SynDaverCO/syndaver-axi/README.md

All files shared here are shared under the CC-BY SA 4.0 license, with attribution to Aleph Objects.
