SynDaverCO/syndaver-axi/Electrical/Cable_drawings/Control_box/[100024] Harness, CB Plug to Ground Green, Syn1 [REV A].pdf

DRAWN BY: SAW | DATE: 01/14/2020 | 3121 N Garfield Ave Loveland, CO. 80538 Phone: 1-970-685-4501
CHECKED BY: CHECKED | DATE: XX/XX/XXXX
UNLESS OTHERWISE SPECIFIED DIMENSIONS ARE IN MILLIMETERS. TOLERANCES ARE: CUT LENGTHS ±3MM STRIP LENGTHS ±.5 | | TITLE: Harness, CB Plug to Ground Green, Syn1
DRAWING NUMBER: 100024 | SIZE: A4
RoHS COMPLIANT | REV: A
DO NOT SCALE DRAWING | SHEET:1 OF 1
Copyright 2020 Syndaver Labs CC-BY-SA 4.0, modified from designs from Aleph Objects, Inc. hps://creavecommons.org/licenses/by-sa/4.0/legalcode | | BOM
ITEM | QTY | UNIT | SUPPLIER | SUPPLIER P/N
A | 1 | PCE | TTI | 3-350820-2
B | 120 | mm | Allcable | HU15691626WE
C | 1 | PCE | Digikey | A27229TR-ND

## Cut Length = 120mm +/- 2mm

Strip 7mm | Strip 7mm

1x [A]
Conn Fast Receptacle 14-16AWG | 1x [C]
| Conn Ring 16-22AWG #4 Red PIDG

1x [B]

### 16AWG Green-Yellow Stripe Wire

REV | BY | DATE | NOTES
A | SAW | 1/21/2020 | Corrected Item C Part Number
