SynDaverCO/syndaver-axi/Electrical/Cable_drawings/Control_box/[100074] Harness, USB Ground, Syn1.pdf

DRAWN BY: SAW | DATE: 01/15/2020 | 3121 N Garfield Ave Loveland, CO. 80538 Phone: 1-970-685-4501
CHECKED BY: CHECKED | DATE: XX/XX/XXXX
UNLESS OTHERWISE SPECIFIED DIMENSIONS ARE IN MILLIMETERS. TOLERANCES ARE: CUT LENGTHS ±3MM STRIP LENGTHS ±.5 | | TITLE: Harness, USB Ground, Syn1
DRAWING NUMBER: 100074 | SIZE: A4
RoHS COMPLIANT | REV: IR
DO NOT SCALE DRAWING | SHEET:1 OF 1
Copyright 2020 Syndaver Labs CC-BY-SA 4.0, modified from designs from Aleph Objects, Inc. hps://creavecommons.org/licenses/by-sa/4.0/legalcode | | BOM
ITEM | QTY | UNIT | SUPPLIER | SUPPLIER P/N
A | 2 | PCE | Digikey | A27229TR-ND
B | 75 | mm | Allcable | HU15691626GN

## Cut Length = 75mm +/- 2mm

Strip 7mm | Strip 7mm

1x [B]

### 16AWG Green-Yellow Stripe Wire

1x [A]

### Conn Ring 16-22AWG #4 Red PIDG

1x [A]

### Conn Ring 16-22AWG #4 Red PIDG
