SynDaverCO/syndaver-axi/Electrical/Die_cut_contact_pads/Die_Cut-LCD_Ground_Pad-Syn1/[100069] Die Cut, LCD Ground Pad, Syn1.step

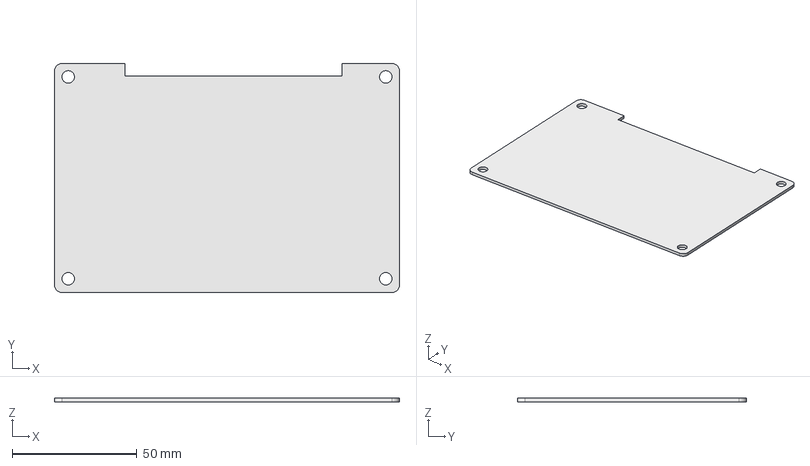
[picture p1: CAD file, 2020-06-04]
Electrical/Die_cut_contact_pads/Die_Cut-LCD_Ground_Pad-Syn1/[100069] Die Cut, LCD Ground Pad, Syn1.step
138.2 x 91.8 x 1.50 mm
