SynDaverCO/syndaver-axi/Electrical/Die_cut_contact_pads/Die_Cut-USB_ESD_Fingers-Syn1/[100073] Die Cut, USB ESD Fingers, Syn1.step

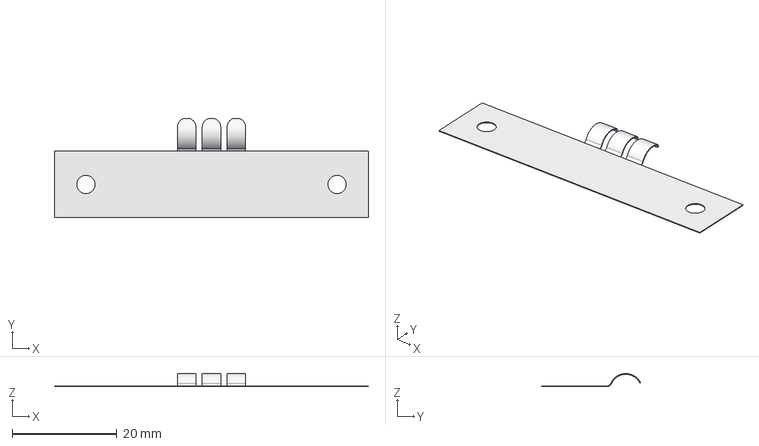
[picture p2: CAD file, 2020-06-04]
Electrical/Die_cut_contact_pads/Die_Cut-USB_ESD_Fingers-Syn1/[100073] Die Cut, USB ESD Fingers, Syn1.step
60.0 x 19.0 x 2.50 mm
