SynDaverCO/syndaver-axi/Mechanical/Machined_parts/10_12_mm_smooth_rods/[100062] Machined Part, 10mmx498mm Rod, Syn1.FCStd

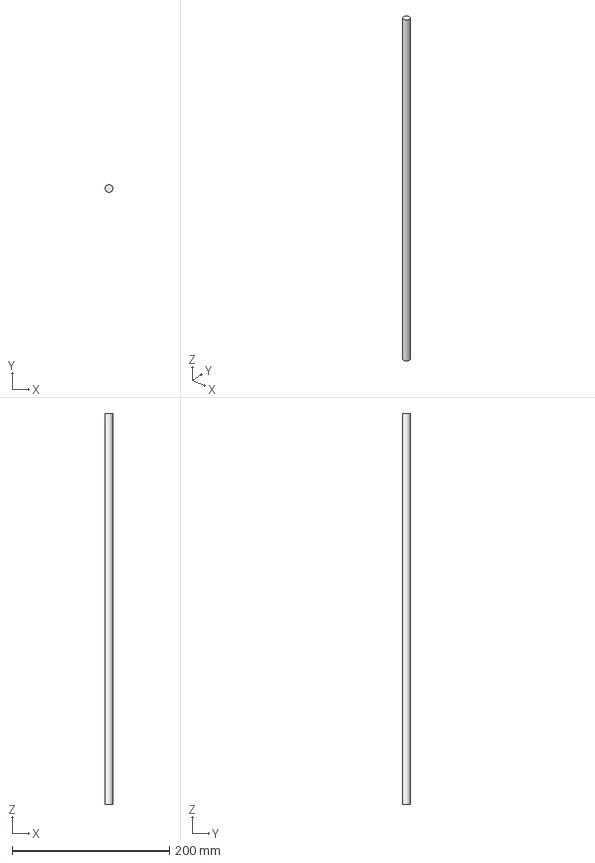
[picture p3: CAD file, 2020-06-04]
Mechanical/Machined_parts/10_12_mm_smooth_rods/[100062] Machined Part, 10mmx498mm Rod, Syn1.FCStd
9.99 x 10.00 x 498.0 mm
