SynDaverCO/syndaver-axi/Mechanical/Machined_parts/Machined_Part-Archim_Heatsink-Syn1/[100064] Machined Part, Archim Heatsink, Syn1.step

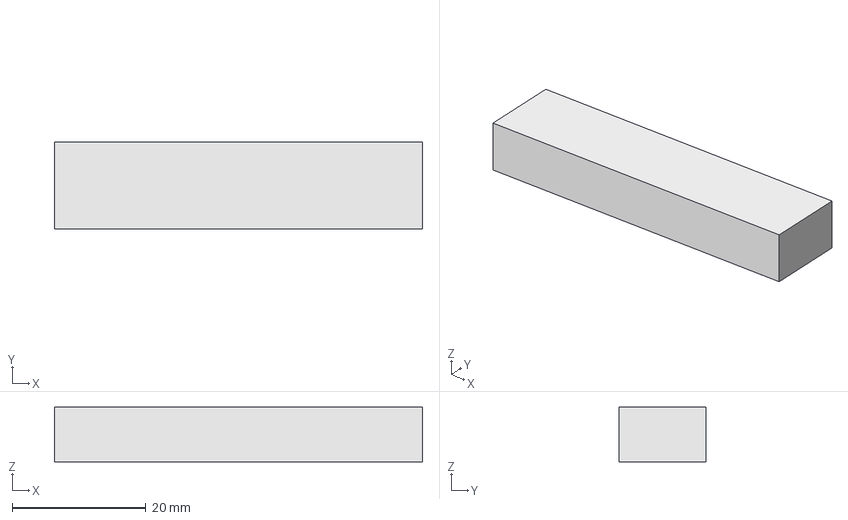
[picture p4: CAD file, 2020-06-04]
Mechanical/Machined_parts/Machined_Part-Archim_Heatsink-Syn1/[100064] Machined Part, Archim Heatsink, Syn1.step
55.0 x 13.0 x 8.20 mm
