SynDaverCO/syndaver-axi/Mechanical/Machined_parts/Machined_Part-YZ_Idler-Syn1/[100071] Machined Part, YZ Idler, Syn1.step

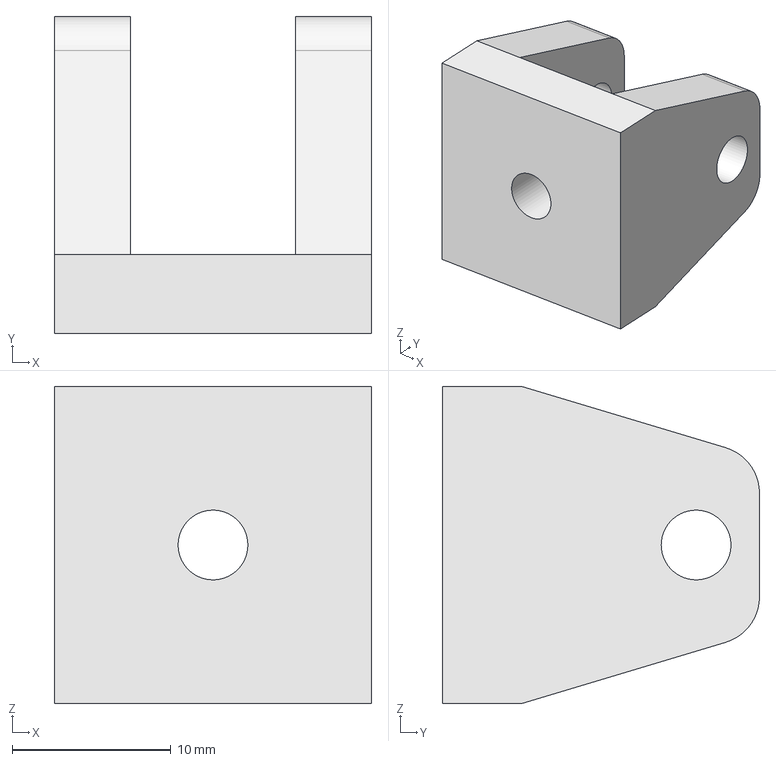
[picture p5: CAD file, 2020-06-04]
Mechanical/Machined_parts/Machined_Part-YZ_Idler-Syn1/[100071] Machined Part, YZ Idler, Syn1.step
20.0 x 20.0 x 20.0 mm
