SynDaverCO/syndaver-axi/Mechanical/Printed_parts/10mm_bushing_retaining_ring/10mm_bushing_retaining_ring_v0.1.fcstd

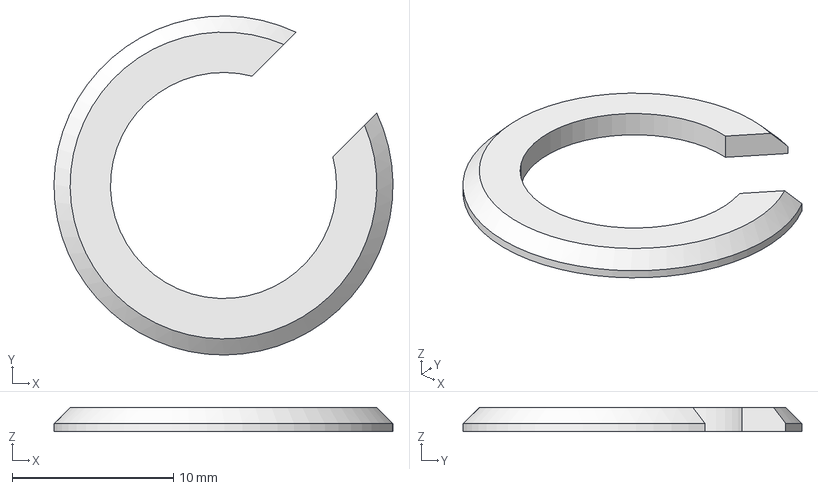
[picture p6: CAD file, 2020-06-04]
Mechanical/Printed_parts/10mm_bushing_retaining_ring/10mm_bushing_retaining_ring_v0.1.fcstd
21.0 x 21.0 x 1.50 mm
