SynDaverCO/syndaver-axi/Mechanical/Printed_parts/12mm_bushing_retaining_ring/12mm_bushing_retaining_ring.fcstd

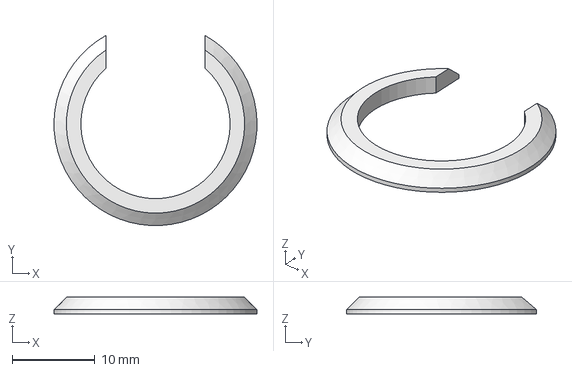
[picture p7: CAD file, 2020-06-04]
Mechanical/Printed_parts/12mm_bushing_retaining_ring/12mm_bushing_retaining_ring.fcstd
24.5 x 22.9 x 2.00 mm
