SynDaverCO/syndaver-axi/Mechanical/Printed_parts/bed_corner/bed_corner_v2.2.3.fcstd

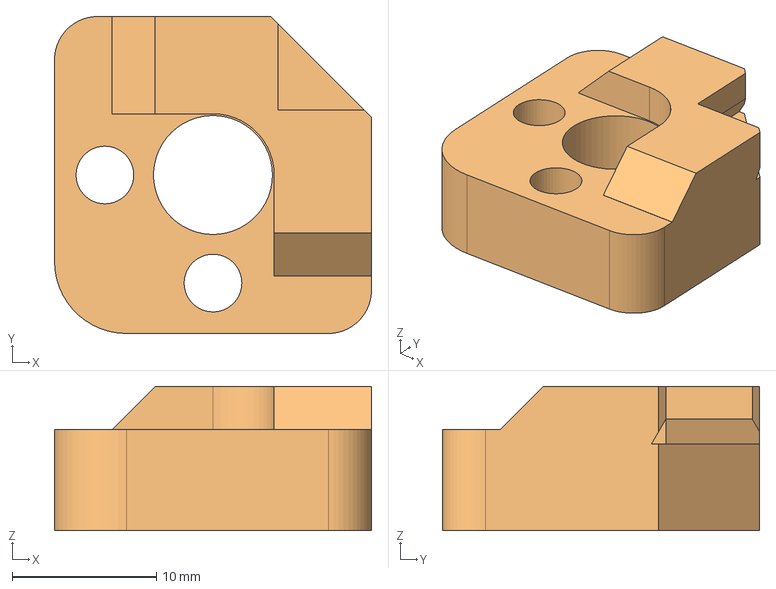
[picture p8: CAD file, 2020-06-04]
Mechanical/Printed_parts/bed_corner/bed_corner_v2.2.3.fcstd
22.0 x 22.0 x 10.0 mm
