SynDaverCO/syndaver-axi/Mechanical/Printed_parts/bed_mount_chassis/bed_mount_chassis_v3.6.fcstd

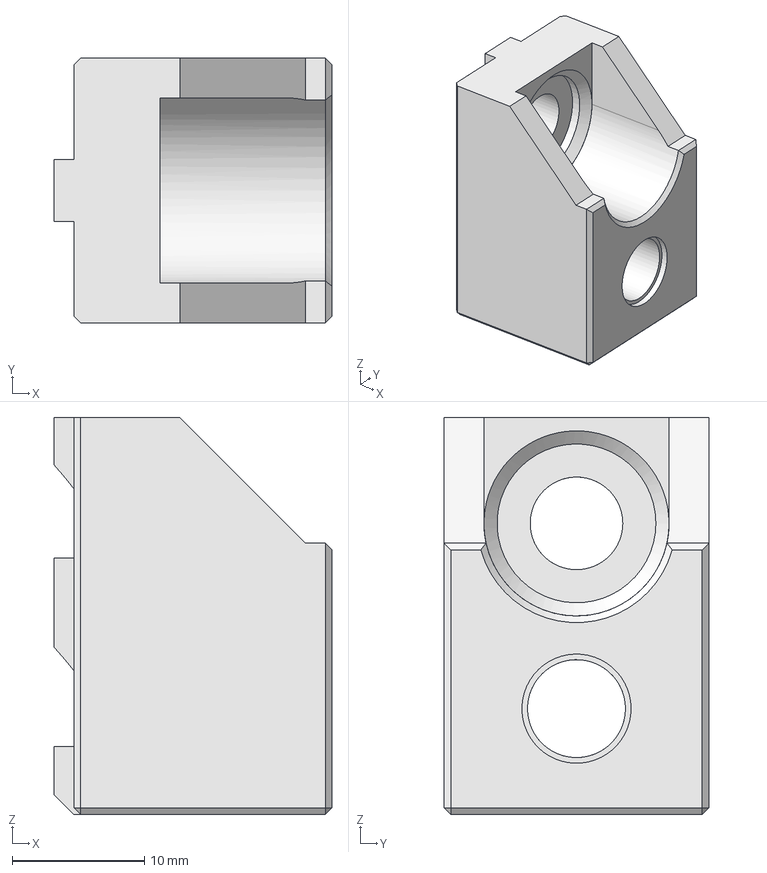
[picture p9: CAD file, 2020-06-04]
Mechanical/Printed_parts/bed_mount_chassis/bed_mount_chassis_v3.6.fcstd
21.0 x 20.0 x 30.0 mm
