SynDaverCO/syndaver-axi/Mechanical/Printed_parts/bed_mount_table/bed_mount_table_v1.1.fcstd

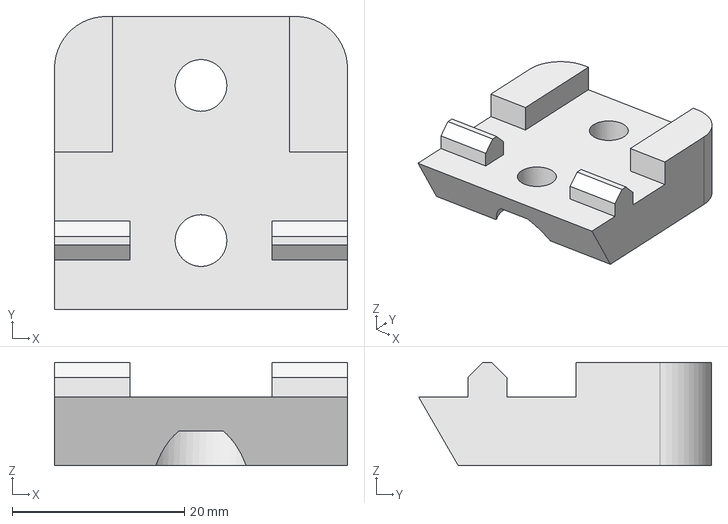
[picture p10: CAD file, 2020-06-04]
Mechanical/Printed_parts/bed_mount_table/bed_mount_table_v1.1.fcstd
34.0 x 34.0 x 12.0 mm
