SynDaverCO/syndaver-axi/Mechanical/Printed_parts/belt_anchor/Z_belt_anchor_v1.1.fcstd

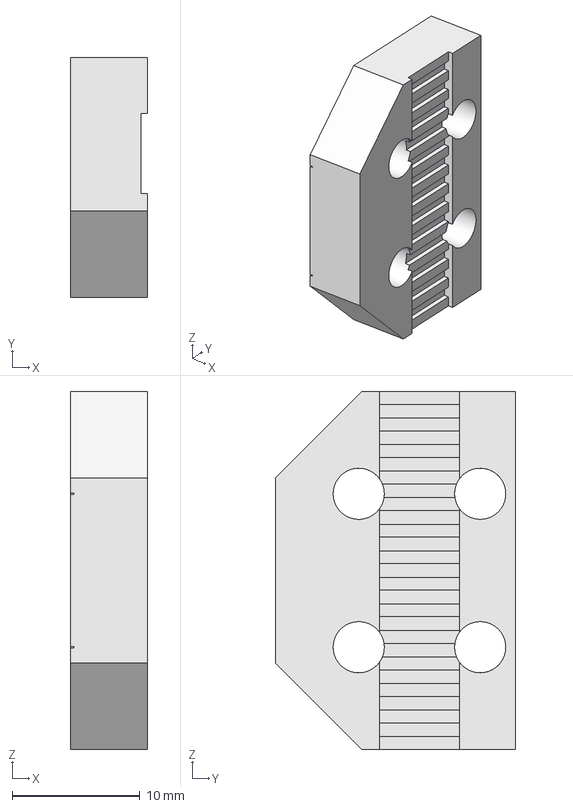
[picture p11: CAD file, 2020-06-04]
Mechanical/Printed_parts/belt_anchor/Z_belt_anchor_v1.1.fcstd
6.00 x 18.8 x 28.0 mm
