SynDaverCO/syndaver-axi/Mechanical/Printed_parts/cable_clip/cable_clip_v0.1.FCStd

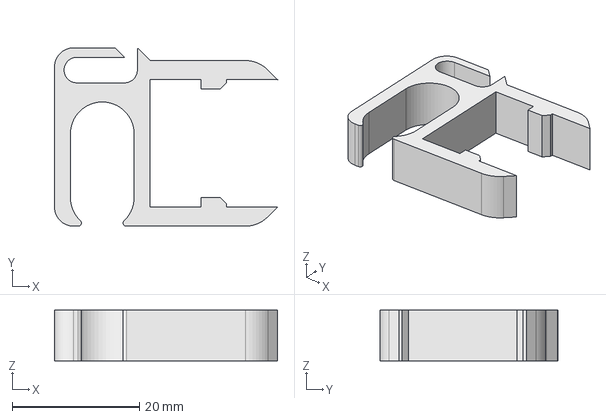
[picture p12: CAD file, 2020-06-04]
Mechanical/Printed_parts/cable_clip/cable_clip_v0.1.FCStd
35.0 x 28.0 x 8.00 mm
