SynDaverCO/syndaver-axi/Mechanical/Printed_parts/electronics_chassis_mount_front/electronics_chassis_mount_front_v1.fcstd

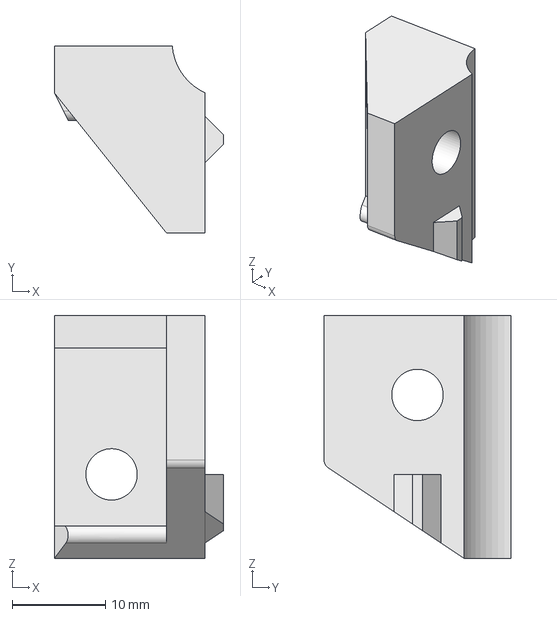
[picture p13: CAD file, 2020-06-04]
Mechanical/Printed_parts/electronics_chassis_mount_front/electronics_chassis_mount_front_v1.fcstd
18.1 x 20.0 x 26.0 mm
