SynDaverCO/syndaver-axi/Mechanical/Printed_parts/extruder_harness_cable_guide/extruder_harness_cable_guide_v0.1.FCStd

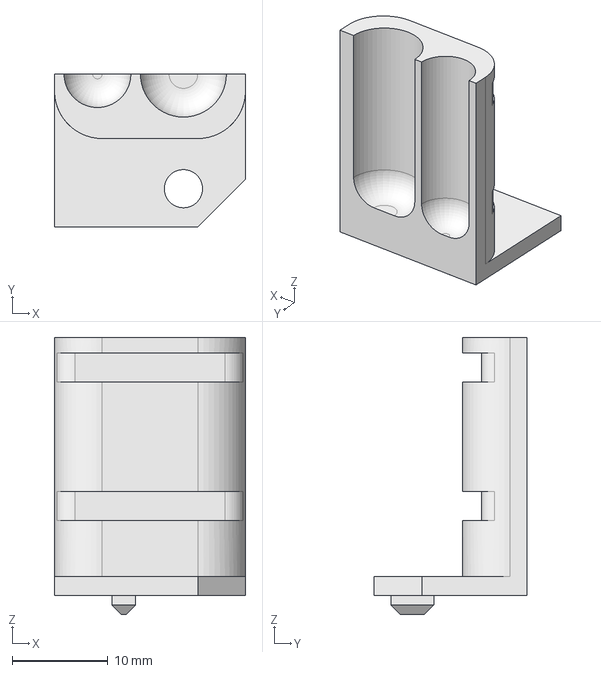
[picture p14: CAD file, 2020-06-04]
Mechanical/Printed_parts/extruder_harness_cable_guide/extruder_harness_cable_guide_v0.1.FCStd
20.0 x 16.0 x 29.0 mm
