SynDaverCO/syndaver-axi/Mechanical/Printed_parts/flexy_bed_foot/flexy_bed_foot_v0.1.fcstd

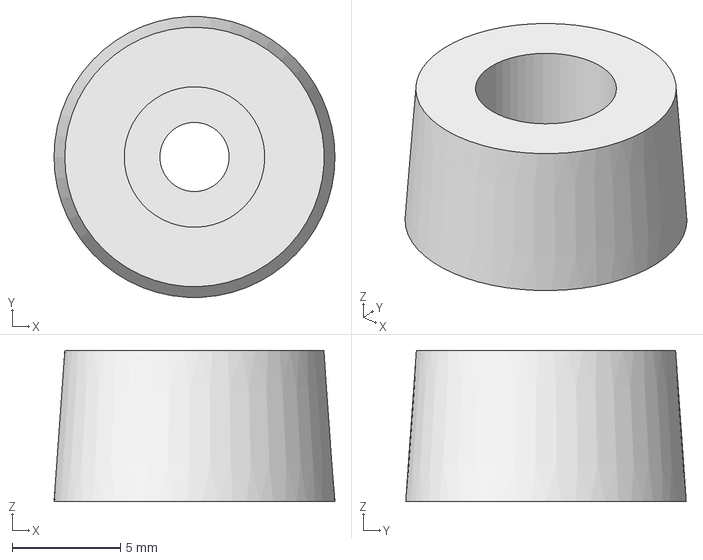
[picture p15: CAD file, 2020-06-04]
Mechanical/Printed_parts/flexy_bed_foot/flexy_bed_foot_v0.1.fcstd
13.0 x 13.0 x 7.00 mm
