SynDaverCO/syndaver-axi/Mechanical/Printed_parts/frame_foot/frame_foot_v0.1.FCStd

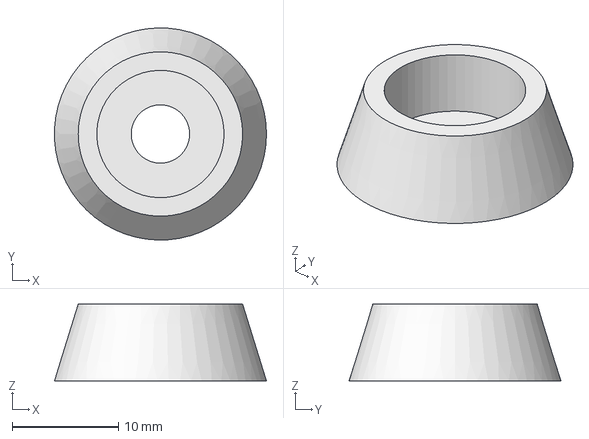
[picture p16: CAD file, 2020-06-04]
Mechanical/Printed_parts/frame_foot/frame_foot_v0.1.FCStd
20.0 x 20.0 x 7.25 mm
