SynDaverCO/syndaver-axi/Mechanical/Printed_parts/heatsink_mount/heatsink_mount_v0.3.FCStd

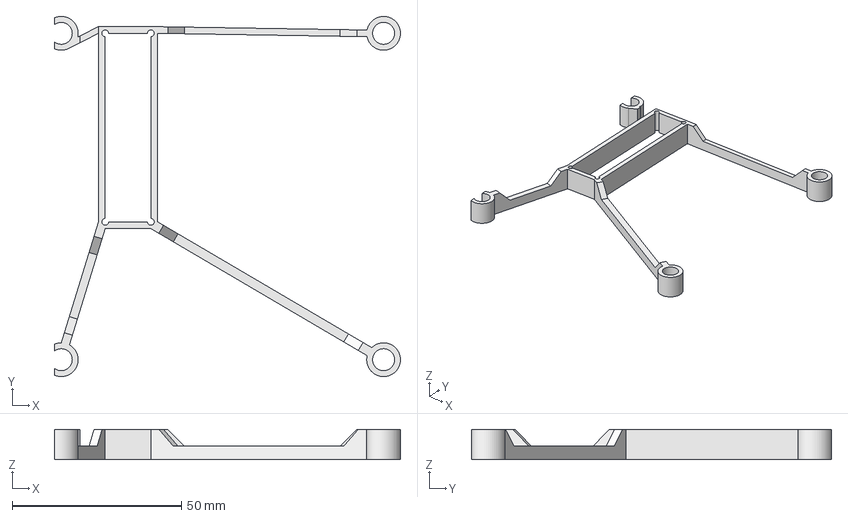
[picture p17: CAD file, 2020-06-04]
Mechanical/Printed_parts/heatsink_mount/heatsink_mount_v0.3.FCStd
102.3 x 106.5 x 9.00 mm
