SynDaverCO/syndaver-axi/Mechanical/Printed_parts/interconnect_housing_bottom/interconnect_housing_bottom_v0.1.FCStd

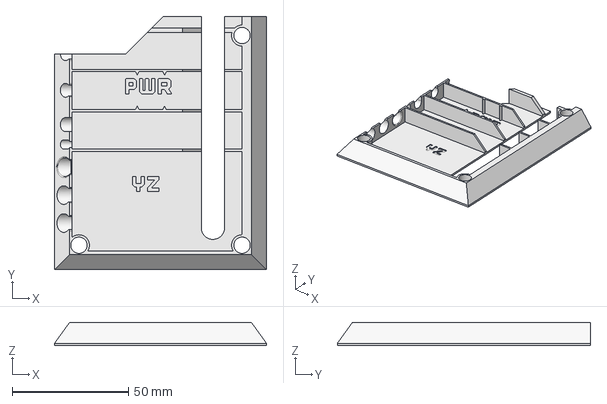
[picture p18: CAD file, 2020-06-04]
Mechanical/Printed_parts/interconnect_housing_bottom/interconnect_housing_bottom_v0.1.FCStd
91.0 x 108.8 x 10.0 mm
