SynDaverCO/syndaver-axi/Mechanical/Printed_parts/interconnect_housing_top/interconnect_housing_top.FCStd

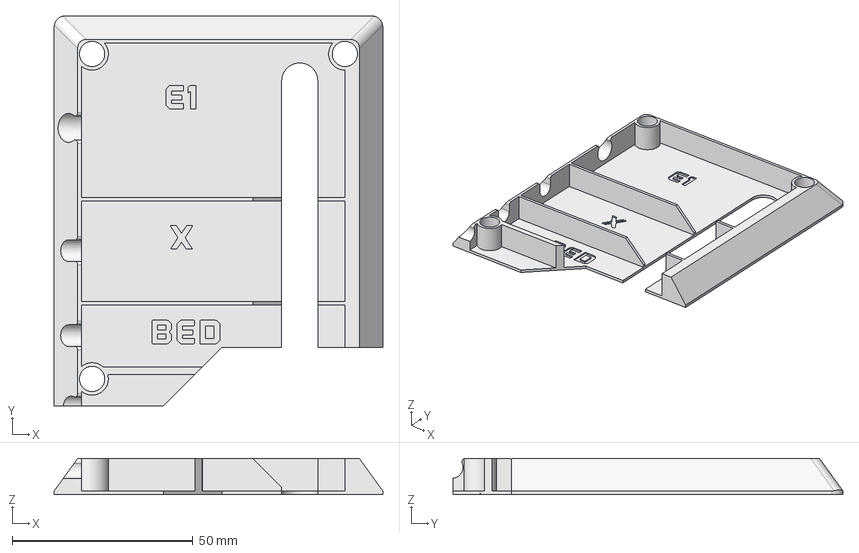
[picture p19: CAD file, 2020-06-04]
Mechanical/Printed_parts/interconnect_housing_top/interconnect_housing_top.FCStd
91.0 x 108.0 x 10.0 mm
