SynDaverCO/syndaver-axi/Mechanical/Printed_parts/interconnect_strain_relief/interconnect_strain_relief_v0.4.FCStd

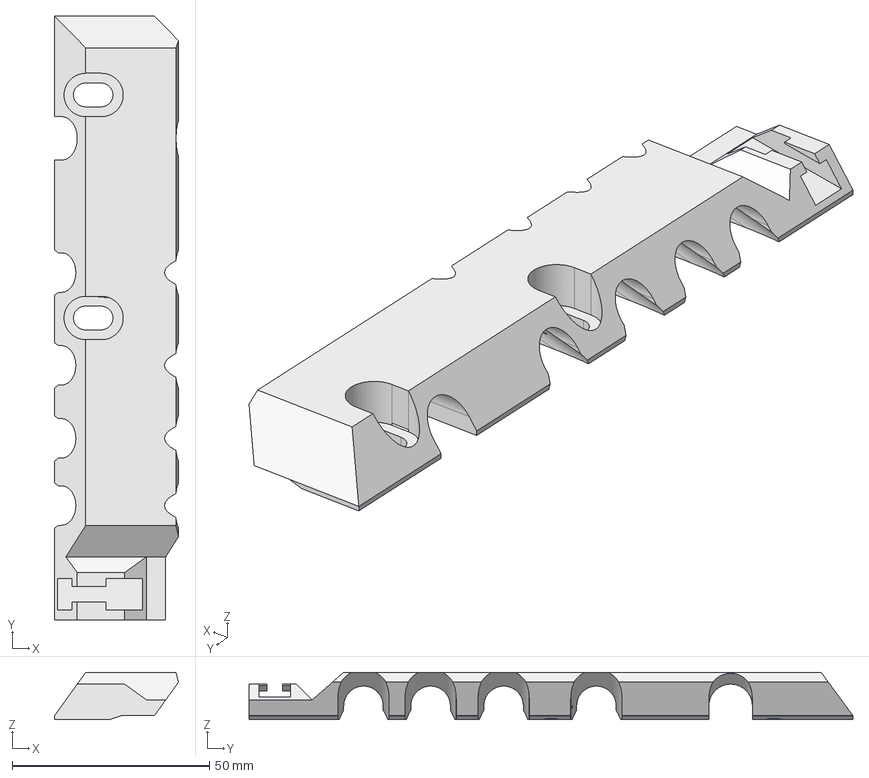
[picture p20: CAD file, 2020-06-04]
Mechanical/Printed_parts/interconnect_strain_relief/interconnect_strain_relief_v0.4.FCStd
31.4 x 153.0 x 12.0 mm
