SynDaverCO/syndaver-axi/Mechanical/Printed_parts/lcd_back/LCD_back_V0.2.3.FCStd

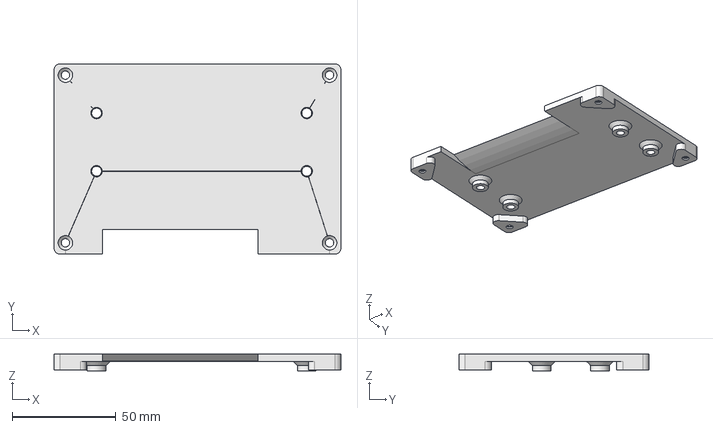
[picture p21: CAD file, 2020-06-04]
Mechanical/Printed_parts/lcd_back/LCD_back_V0.2.3.FCStd
138.2 x 91.8 x 8.00 mm
