SynDaverCO/syndaver-axi/Mechanical/Printed_parts/lcd_bezel/LCD_bezel_V0.3.fcstd

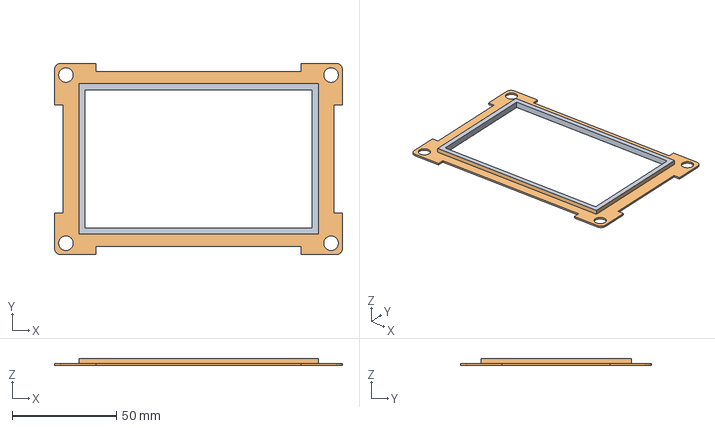
[picture p22: CAD file, 2020-06-04]
Mechanical/Printed_parts/lcd_bezel/LCD_bezel_V0.3.fcstd
138.2 x 91.9 x 3.50 mm
