SynDaverCO/syndaver-axi/Mechanical/Printed_parts/lcd_center/LCD_center_v0.2.fcstd

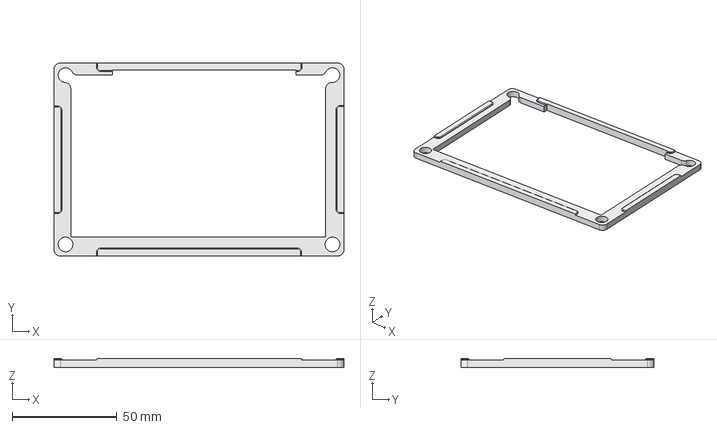
[picture p23: CAD file, 2020-06-04]
Mechanical/Printed_parts/lcd_center/LCD_center_v0.2.fcstd
138.2 x 92.0 x 4.25 mm
