SynDaverCO/syndaver-axi/Mechanical/Printed_parts/spool_arm/spool_arm_v1.2.fcstd

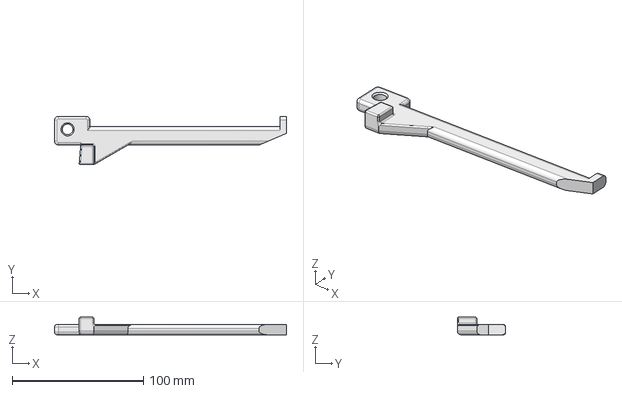
[picture p24: CAD file, 2020-06-04]
Mechanical/Printed_parts/spool_arm/spool_arm_v1.2.fcstd
177.0 x 37.0 x 13.5 mm
