SynDaverCO/syndaver-axi/Mechanical/Printed_parts/USB_bezel/USB_bezel_v1.1.FCStd

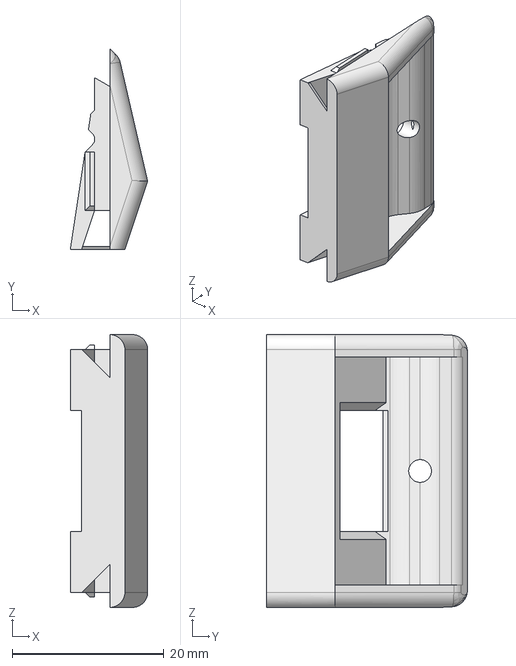
[picture p25: CAD file, 2020-06-04]
Mechanical/Printed_parts/USB_bezel/USB_bezel_v1.1.FCStd
10.2 x 26.5 x 36.0 mm
