SynDaverCO/syndaver-axi/Mechanical/Printed_parts/USB_mount/USB_mount_v0.1.FCStd

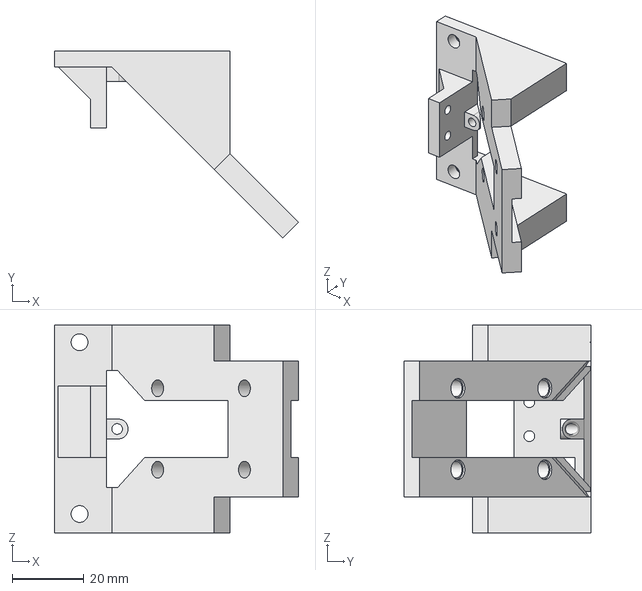
[picture p26: CAD file, 2020-06-04]
Mechanical/Printed_parts/USB_mount/USB_mount_v0.1.FCStd
68.2 x 52.3 x 58.0 mm
