SynDaverCO/syndaver-axi/Mechanical/Printed_parts/wiper_mount/wiper_mount_v2.1.fcstd

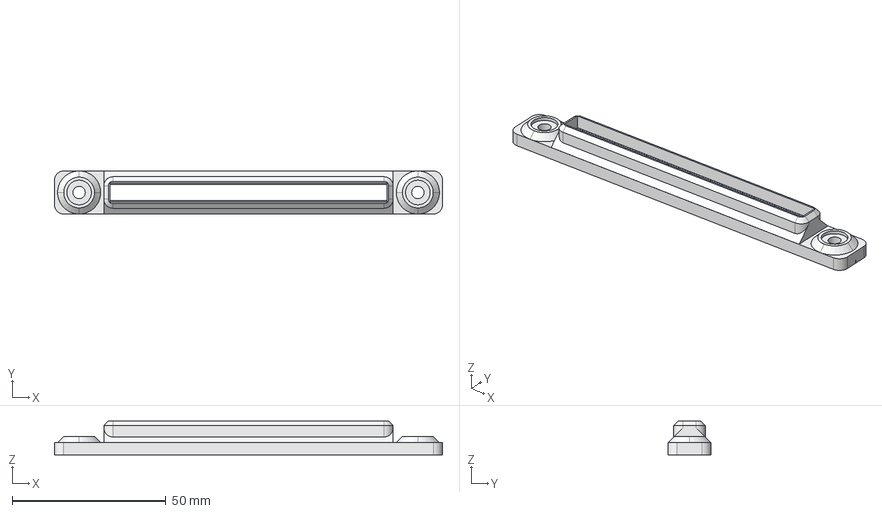
[picture p27: CAD file, 2020-06-04]
Mechanical/Printed_parts/wiper_mount/wiper_mount_v2.1.fcstd
126.0 x 14.0 x 11.0 mm
