SynDaverCO/syndaver-axi/Mechanical/Printed_parts/x_bearing_holder/x_bearing_holder_v0.2.3.FCStd

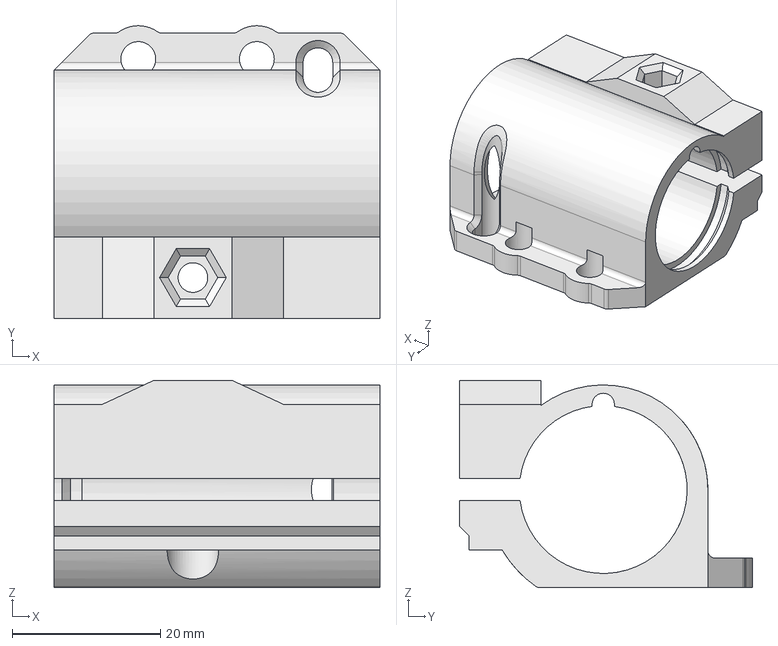
[picture p28: CAD file, 2020-06-04]
Mechanical/Printed_parts/x_bearing_holder/x_bearing_holder_v0.2.3.FCStd
44.0 x 39.5 x 28.0 mm
