SynDaverCO/syndaver-axi/Mechanical/Printed_parts/x_belt_clamp/x_belt_clamp_v0.1.fcstd

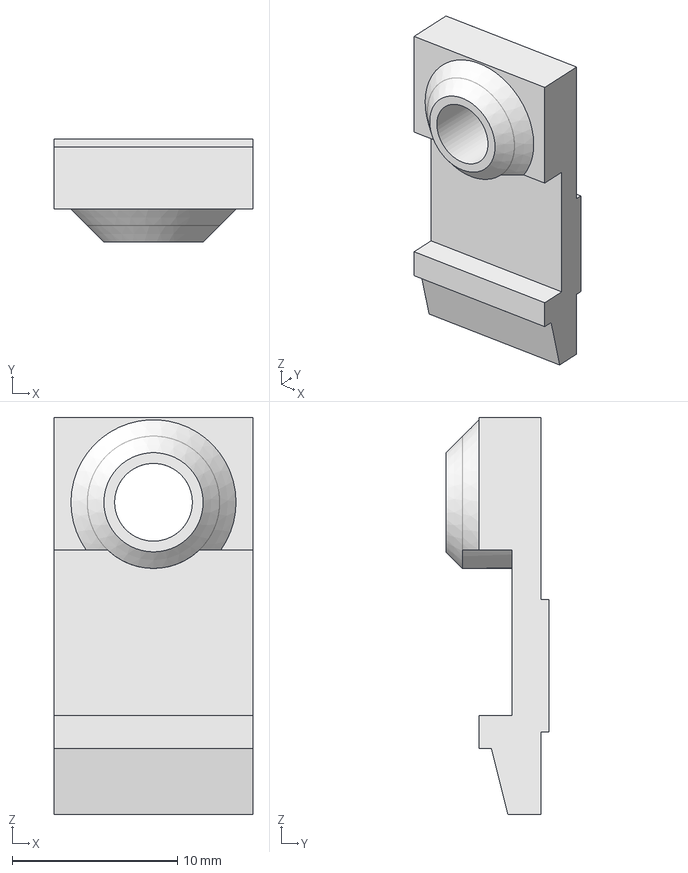
[picture p29: CAD file, 2020-06-04]
Mechanical/Printed_parts/x_belt_clamp/x_belt_clamp_v0.1.fcstd
12.0 x 6.25 x 24.0 mm
