SynDaverCO/syndaver-axi/Mechanical/Printed_parts/x_belt_tensioner/x_belt_tensioner_0.2.FCStd

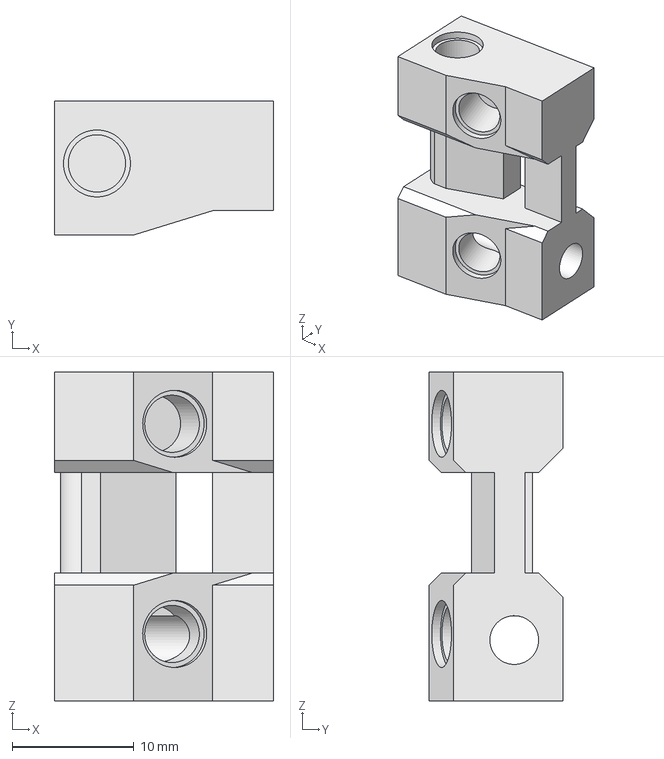
[picture p30: CAD file, 2020-06-04]
Mechanical/Printed_parts/x_belt_tensioner/x_belt_tensioner_0.2.FCStd
18.0 x 11.0 x 27.0 mm
