SynDaverCO/syndaver-axi/Mechanical/Printed_parts/x_belt_tensioner_clamp/x_belt_tensioner_clamp.fcstd

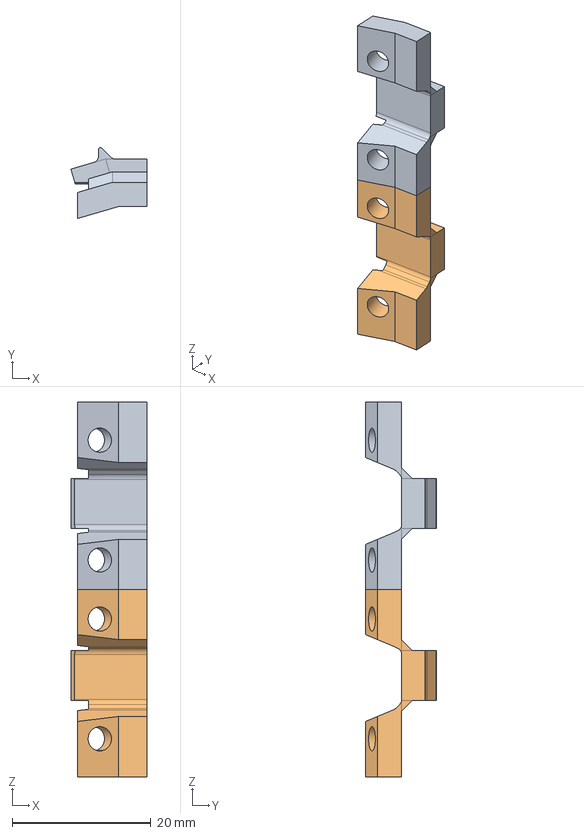
[picture p31: CAD file, 2020-06-04]
Mechanical/Printed_parts/x_belt_tensioner_clamp/x_belt_tensioner_clamp.fcstd
11.0 x 10.2 x 54.0 mm
Fillet001 (Mirror #1)
