SynDaverCO/syndaver-axi/Mechanical/Printed_parts/x_carriage/x_carriage_v0.5.2.stl

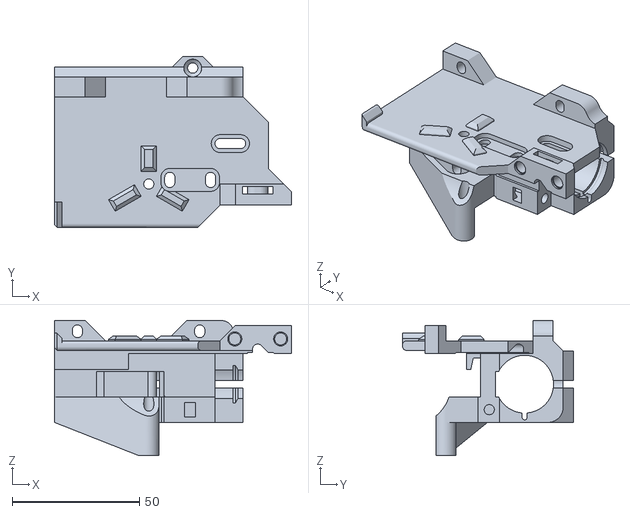
[picture p32: CAD file, 2020-06-04]
Mechanical/Printed_parts/x_carriage/x_carriage_v0.5.2.stl
93.0 x 67.0 x 53.0
