SynDaverCO/syndaver-axi/Mechanical/Printed_parts/x_carriage_cover/x_carriage_cover_v2.1.FCStd

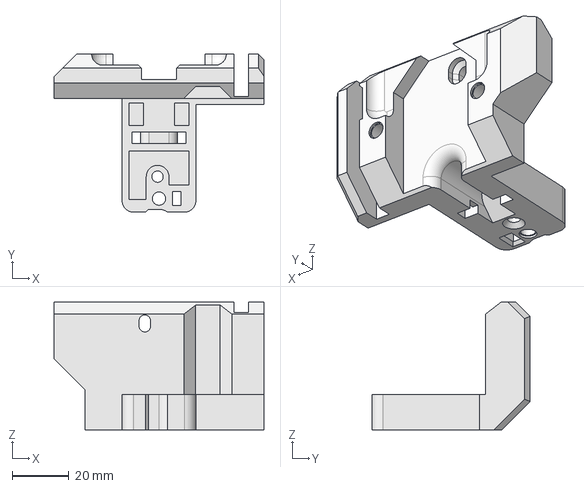
[picture p33: CAD file, 2020-06-04]
Mechanical/Printed_parts/x_carriage_cover/x_carriage_cover_v2.1.FCStd
74.0 x 55.8 x 45.0 mm
