SynDaverCO/syndaver-axi/Mechanical/Printed_parts/x_idler/vr_x_idler_v4.FCStd

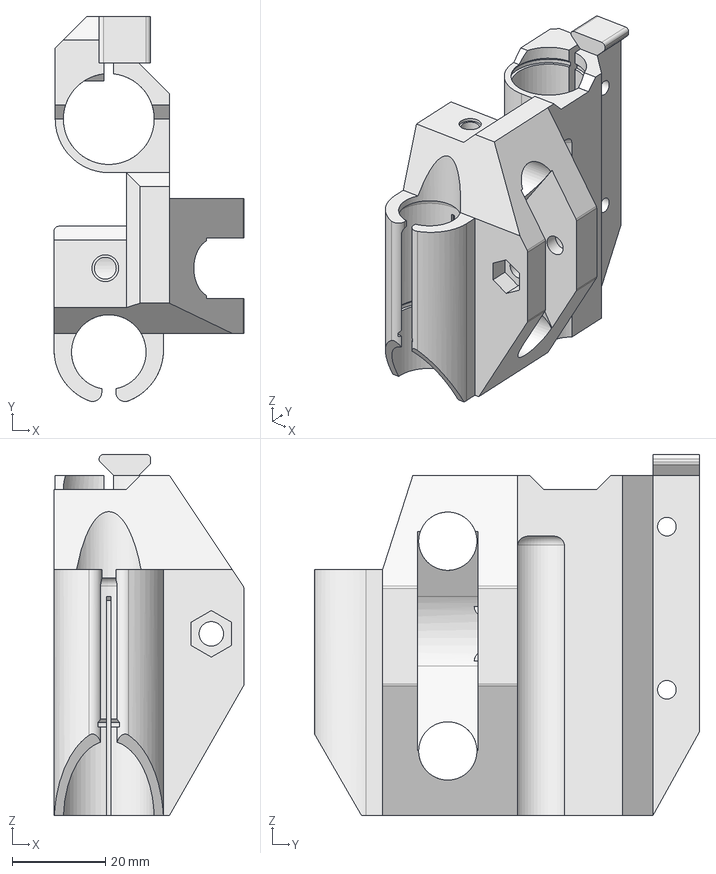
[picture p34: CAD file, 2020-06-04]
Mechanical/Printed_parts/x_idler/vr_x_idler_v4.FCStd
40.8 x 82.6 x 77.5 mm
