SynDaverCO/syndaver-axi/Mechanical/Printed_parts/x_motor_mount/x_motor_mount_v0.5.1.stl

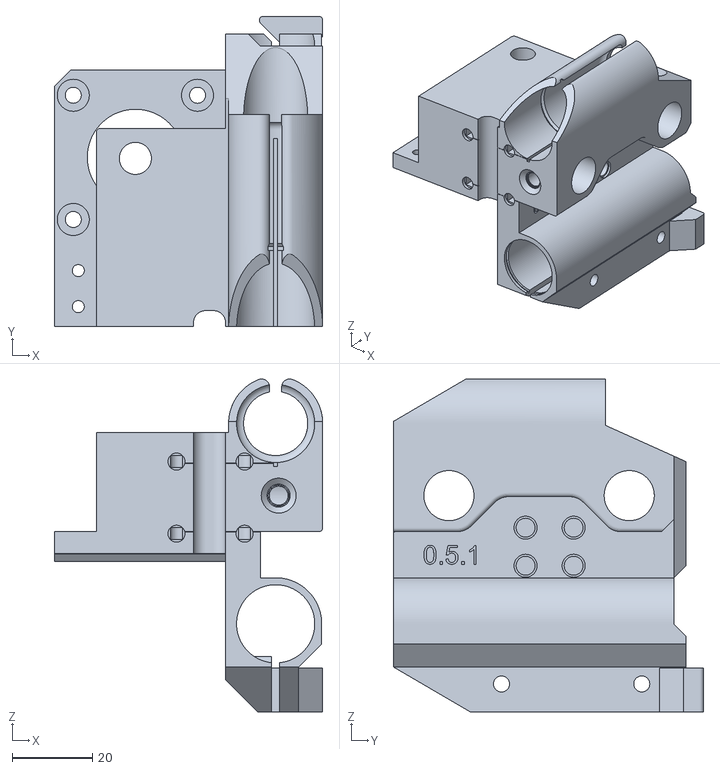
[picture p35: CAD file, 2020-06-04]
Mechanical/Printed_parts/x_motor_mount/x_motor_mount_v0.5.1.stl
67.0 x 77.4 x 83.1
