SynDaverCO/syndaver-axi/Mechanical/Printed_parts/y_bearing_holder/Y_bearing_holder_v1.4-12mm.FCStd

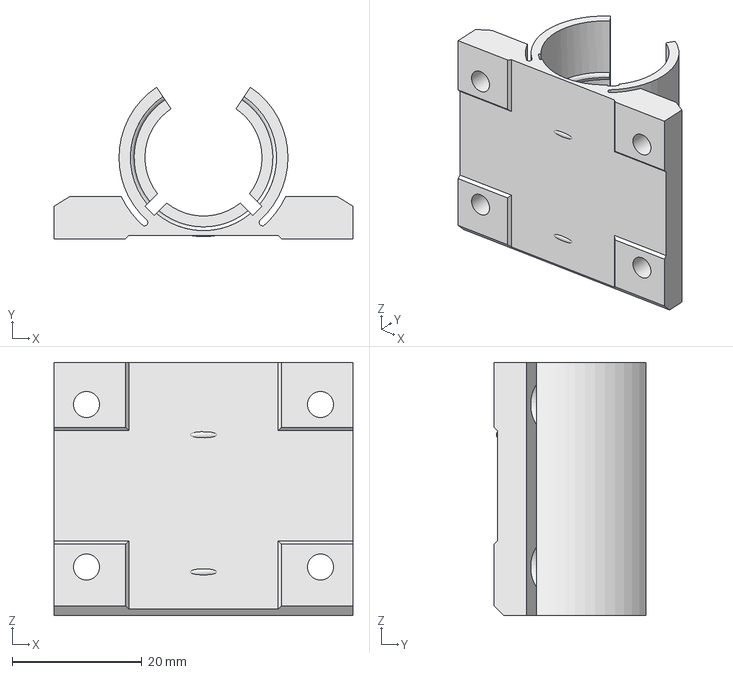
[picture p36: CAD file, 2020-06-04]
Mechanical/Printed_parts/y_bearing_holder/Y_bearing_holder_v1.4-12mm.FCStd
46.0 x 23.3 x 39.0 mm
