SynDaverCO/syndaver-axi/Mechanical/Printed_parts/y_belt_clamp/Y_belt_clamp_v0.3.FCStd

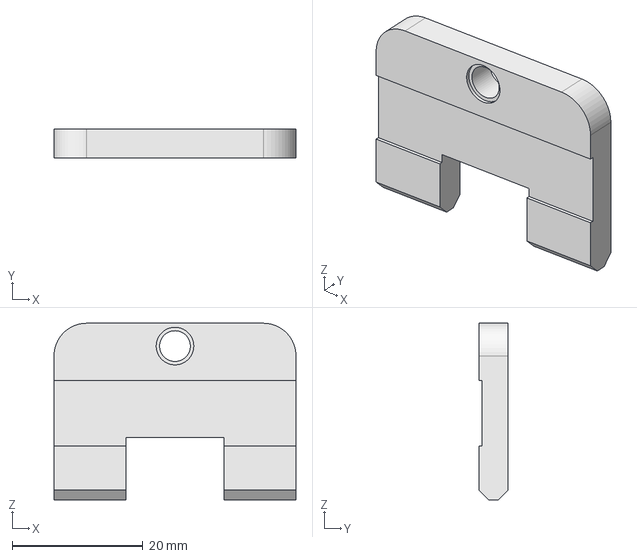
[picture p37: CAD file, 2020-06-04]
Mechanical/Printed_parts/y_belt_clamp/Y_belt_clamp_v0.3.FCStd
37.0 x 4.50 x 27.0 mm
