SynDaverCO/syndaver-axi/Mechanical/Printed_parts/y_belt_mount/y_belt_mount_v0.3.FCStd

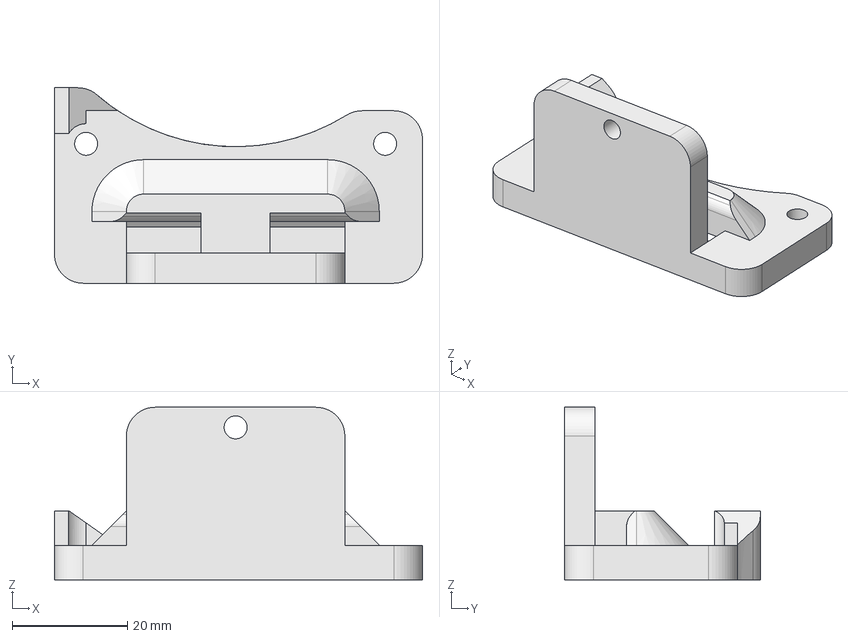
[picture p38: CAD file, 2020-06-04]
Mechanical/Printed_parts/y_belt_mount/y_belt_mount_v0.3.FCStd
64.0 x 34.0 x 30.0 mm
