SynDaverCO/syndaver-axi/Mechanical/Printed_parts/y_cable_cover/y_cable_cover_v1.3.FCStd

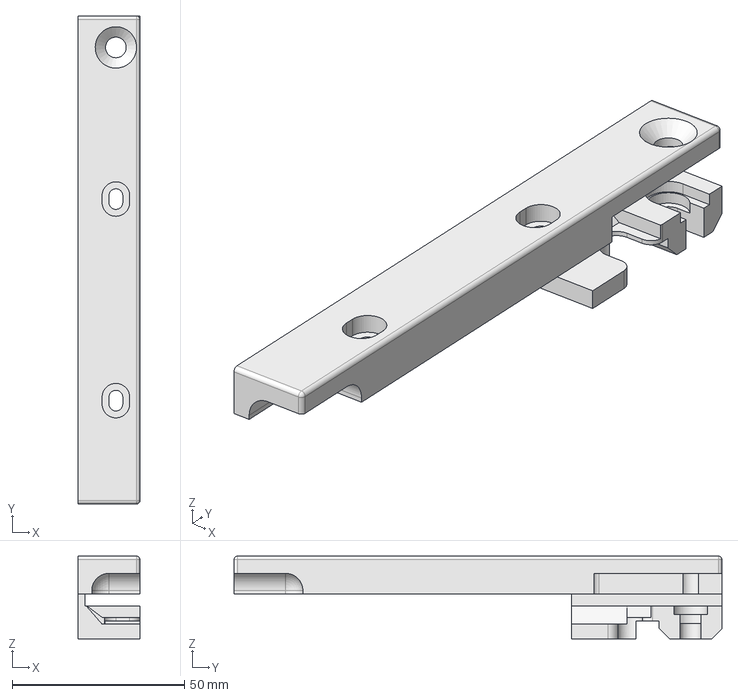
[picture p39: CAD file, 2020-06-04]
Mechanical/Printed_parts/y_cable_cover/y_cable_cover_v1.3.FCStd
18.0 x 141.6 x 24.0 mm
