SynDaverCO/syndaver-axi/Mechanical/Printed_parts/y_cable_mount/y_cable_mount_v0.1.fcstd

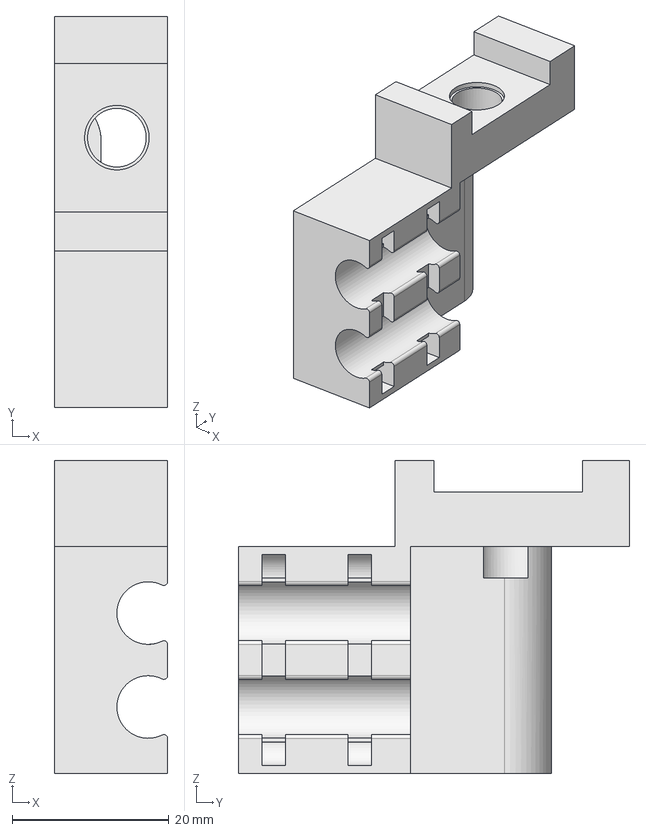
[picture p40: CAD file, 2020-06-04]
Mechanical/Printed_parts/y_cable_mount/y_cable_mount_v0.1.fcstd
14.5 x 50.0 x 40.0 mm
