SynDaverCO/syndaver-axi/Mechanical/Printed_parts/y_corner_left/y_corner_left_v1.4-12mm.FCStd

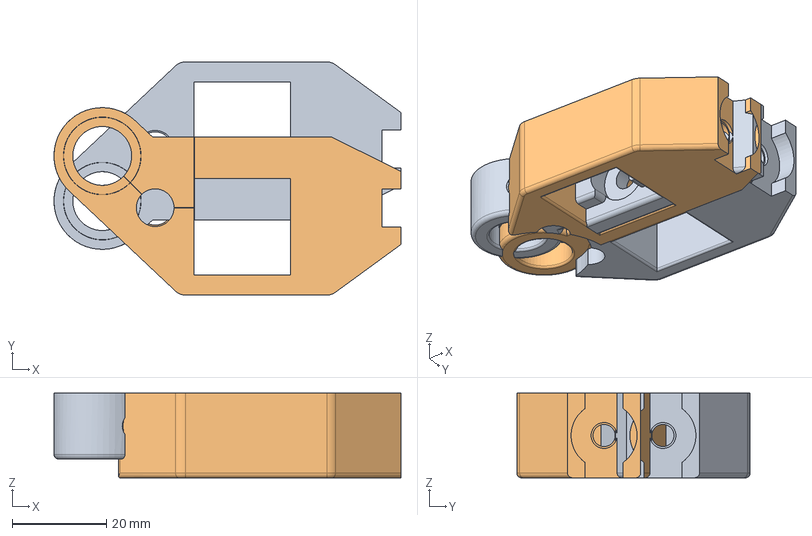
[picture p41: CAD file, 2020-06-04]
Mechanical/Printed_parts/y_corner_left/y_corner_left_v1.4-12mm.FCStd
73.7 x 49.5 x 18.0 mm
Fillet002 (Mirror #1)
