SynDaverCO/syndaver-axi/Mechanical/Printed_parts/y_corner_right/y_corner_right_v1.4-12mm.FCStd

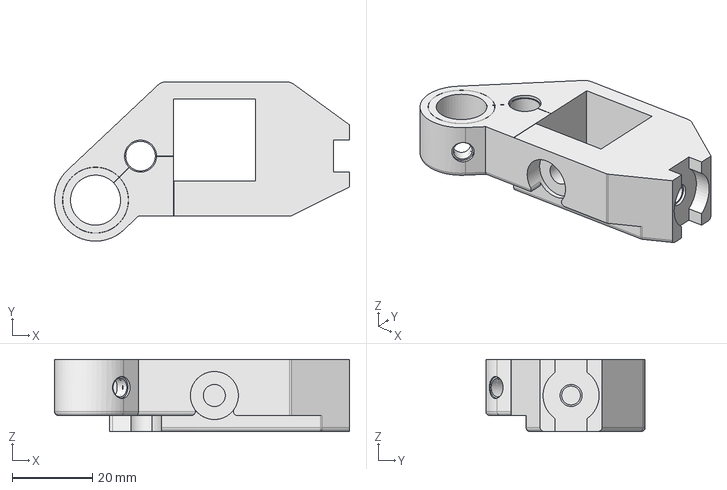
[picture p42: CAD file, 2020-06-04]
Mechanical/Printed_parts/y_corner_right/y_corner_right_v1.4-12mm.FCStd
73.7 x 39.8 x 18.0 mm
