SynDaverCO/syndaver-axi/Mechanical/Printed_parts/y_idler_housing/Y_idler_housing_v0.2.FCStd

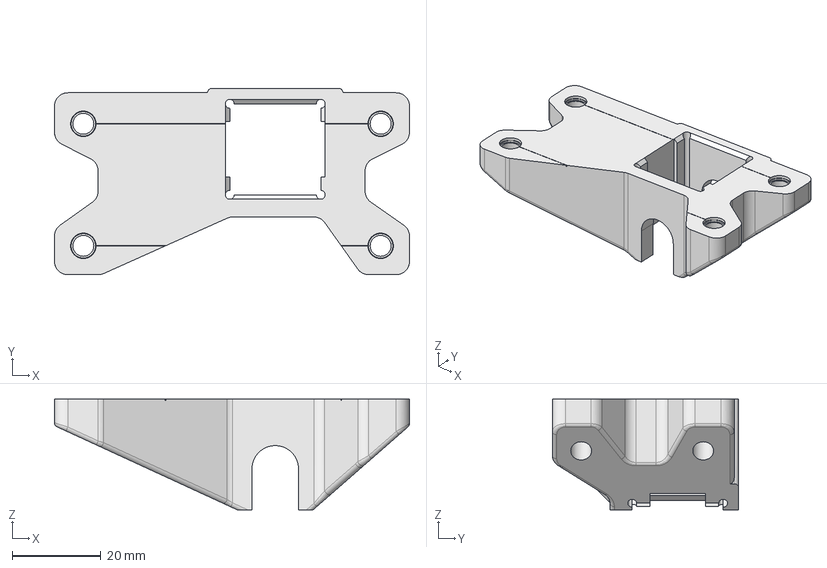
[picture p43: CAD file, 2020-06-04]
Mechanical/Printed_parts/y_idler_housing/Y_idler_housing_v0.2.FCStd
80.0 x 42.0 x 25.0 mm
