SynDaverCO/syndaver-axi/Mechanical/Printed_parts/y_motor_mount/Y_motor_mount_v0.2.FCStd

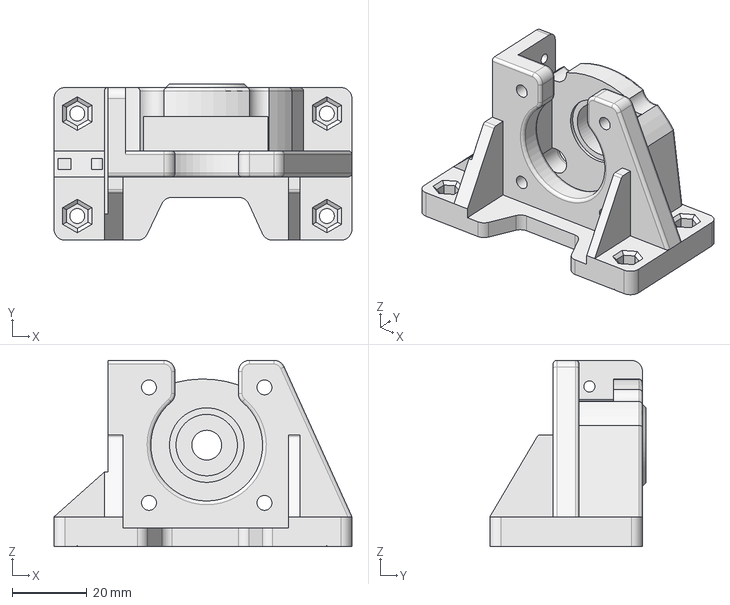
[picture p44: CAD file, 2020-06-04]
Mechanical/Printed_parts/y_motor_mount/Y_motor_mount_v0.2.FCStd
80.0 x 42.0 x 50.0 mm
