SynDaverCO/syndaver-axi/Mechanical/Printed_parts/z_lower_left/Z_lower_leftv2.5.fcstd

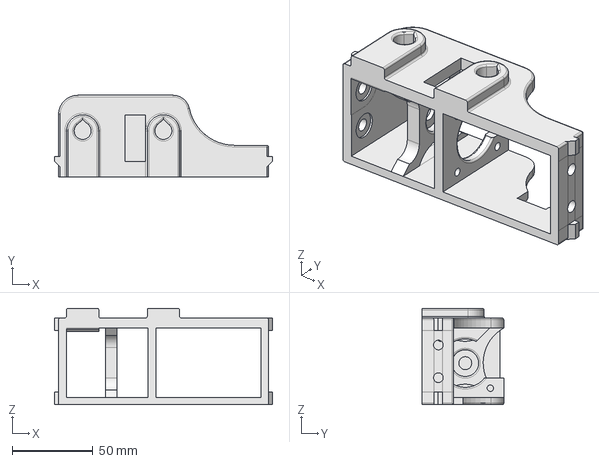
[picture p45: CAD file, 2020-06-04]
Mechanical/Printed_parts/z_lower_left/Z_lower_leftv2.5.fcstd
135.0 x 50.5 x 59.8 mm
