SynDaverCO/syndaver-axi/Mechanical/Printed_parts/z_lower_right/Z_lower_rightv2.5.fcstd

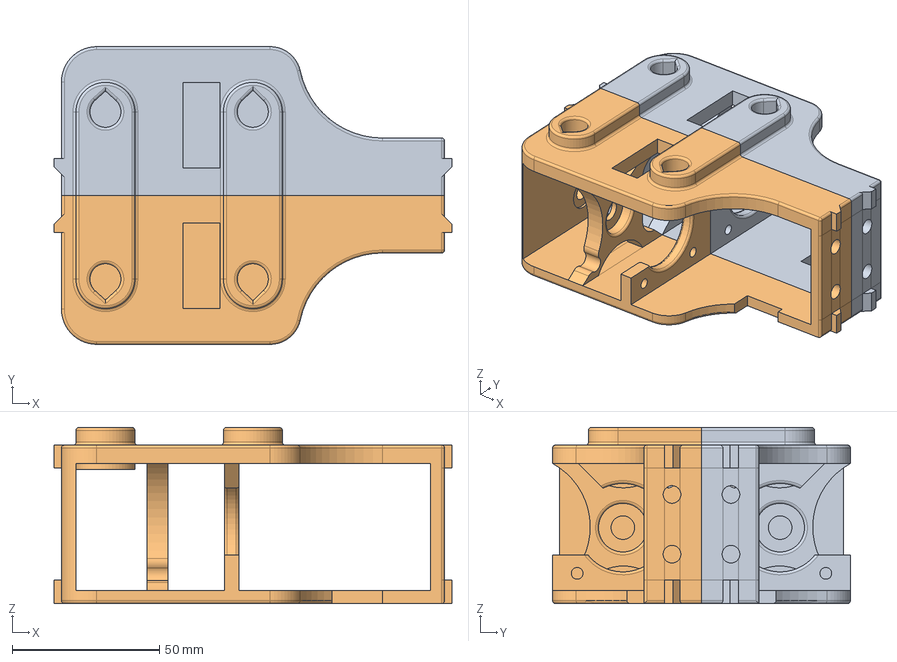
[picture p46: CAD file, 2020-06-04]
Mechanical/Printed_parts/z_lower_right/Z_lower_rightv2.5.fcstd
135.0 x 101.0 x 59.8 mm
Fillet002 (Mirror #1)
