SynDaverCO/syndaver-axi/Mechanical/Printed_parts/z_upper_left/Z_upper_leftv3.7.FCStd

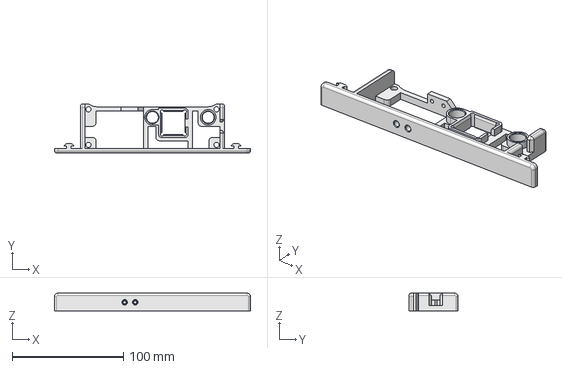
[picture p47: CAD file, 2020-06-04]
Mechanical/Printed_parts/z_upper_left/Z_upper_leftv3.7.FCStd
176.0 x 44.0 x 16.0 mm
