SynDaverCO/syndaver-axi/Mechanical/Printed_parts/z_upper_right/Z_upper_rightv3.7.FCStd

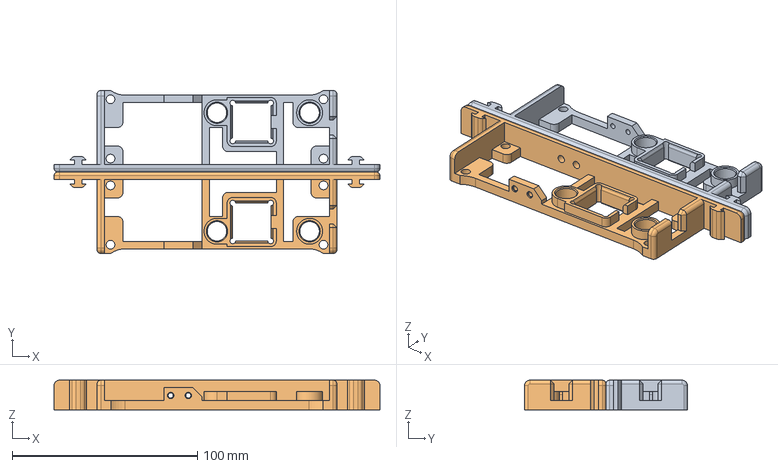
[picture p48: CAD file, 2020-06-04]
Mechanical/Printed_parts/z_upper_right/Z_upper_rightv3.7.FCStd
176.0 x 88.0 x 16.0 mm
Pocket007 (Mirror #1)
