SynDaverCO/syndaver-axi/Mechanical/Sheetmetal/Sheet_Metal-Chassis_Cover-Syn1/[100080] Sheet Metal, Chassis Cover, Syn1.step

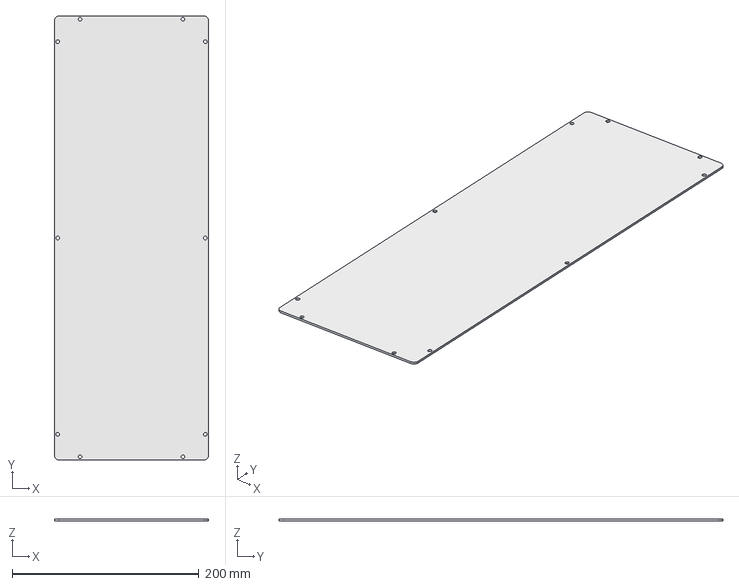
[picture p50: CAD file, 2020-06-04]
Mechanical/Sheetmetal/Sheet_Metal-Chassis_Cover-Syn1/[100080] Sheet Metal, Chassis Cover, Syn1.step
165.0 x 475.0 x 2.00 mm
