SynDaverCO/syndaver-axi/Mechanical/Sheetmetal/Sheet_Metal-Corner_Bracket-Syn1/[100065] Sheet Metal, Corner Bracket, Syn1.step

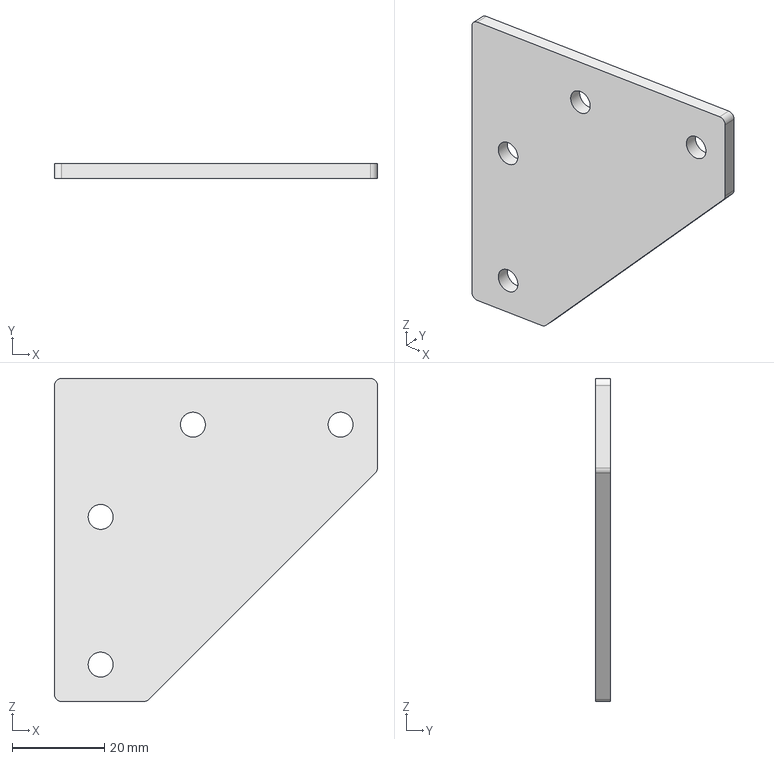
[picture p51: CAD file, 2020-06-04]
Mechanical/Sheetmetal/Sheet_Metal-Corner_Bracket-Syn1/[100065] Sheet Metal, Corner Bracket, Syn1.step
70.0 x 3.17 x 70.0 mm
