SynDaverCO/syndaver-axi/Mechanical/Sheetmetal/Sheet_Metal-Electronics_Chassis-Syn1/[100067] Sheet Metal, Electronics Chassis, Syn1.step

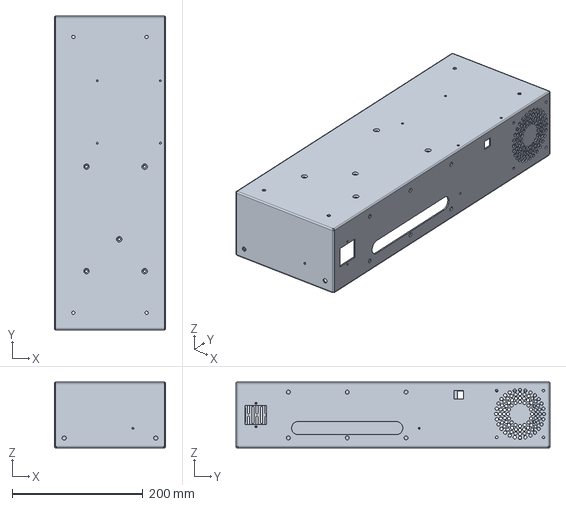
[picture p52: CAD file, 2020-06-04]
Mechanical/Sheetmetal/Sheet_Metal-Electronics_Chassis-Syn1/[100067] Sheet Metal, Electronics Chassis, Syn1.step
170.0 x 480.0 x 100.6 mm
