SynDaverCO/syndaver-axi/Mechanical/Sheetmetal/Sheet_Metal-Interconnect_Cover-Syn1/[100068] Sheet Metal, Interconnect Cover, Syn1.step

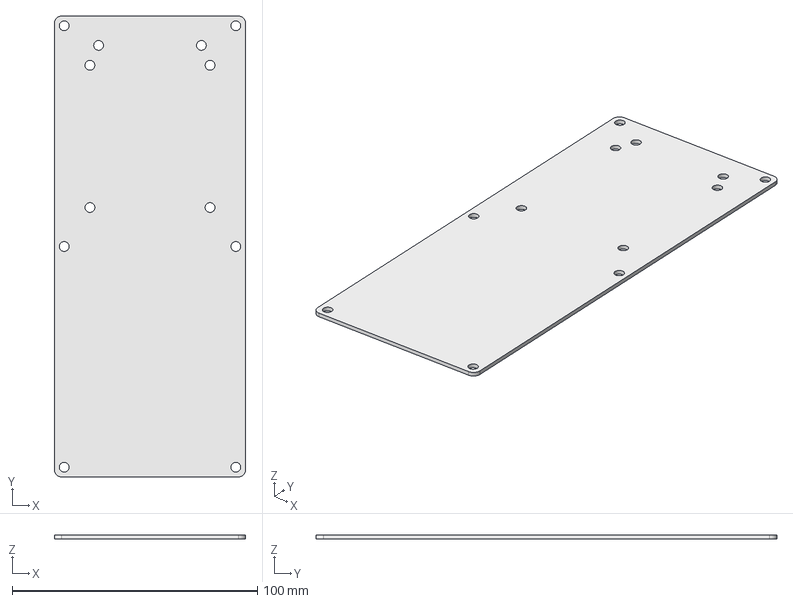
[picture p53: CAD file, 2020-06-04]
Mechanical/Sheetmetal/Sheet_Metal-Interconnect_Cover-Syn1/[100068] Sheet Metal, Interconnect Cover, Syn1.step
78.0 x 188.0 x 1.59 mm
