SynDaverCO/syndaver-axi/Mechanical/Sheetmetal/Sheet_Metal-Y_End_Plate-Syn1/[100070] Sheet Metal, Y End Plate, Syn1.step

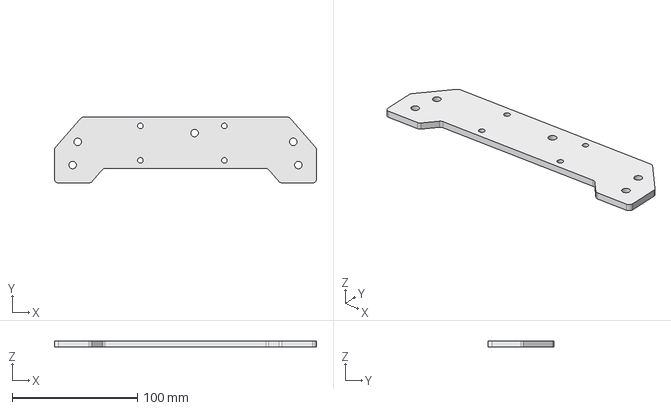
[picture p54: CAD file, 2020-06-04]
Mechanical/Sheetmetal/Sheet_Metal-Y_End_Plate-Syn1/[100070] Sheet Metal, Y End Plate, Syn1.step
209.0 x 52.5 x 4.76 mm
