SynDaverCO/syndaver-axi/Mechanical/Sheetmetal/Sheet_Metal-Z_Top_Plate-Syn1/[100072] Sheet Metal, Z Top Plate, Syn1.step

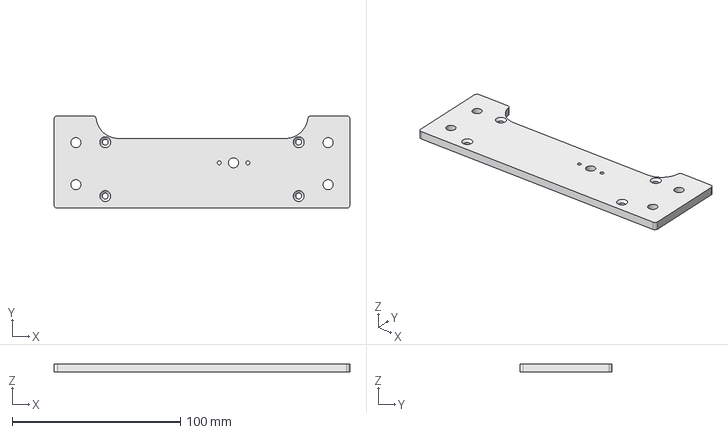
[picture p55: CAD file, 2020-06-04]
Mechanical/Sheetmetal/Sheet_Metal-Z_Top_Plate-Syn1/[100072] Sheet Metal, Z Top Plate, Syn1.step
176.0 x 55.0 x 5.00 mm
