SynDaverCO/syndaver-axi/Mechanical/Machined_parts/10_12_mm_smooth_rods/[100063] Machined Part, 12mmx538mm Rod, Syn1.FCStd

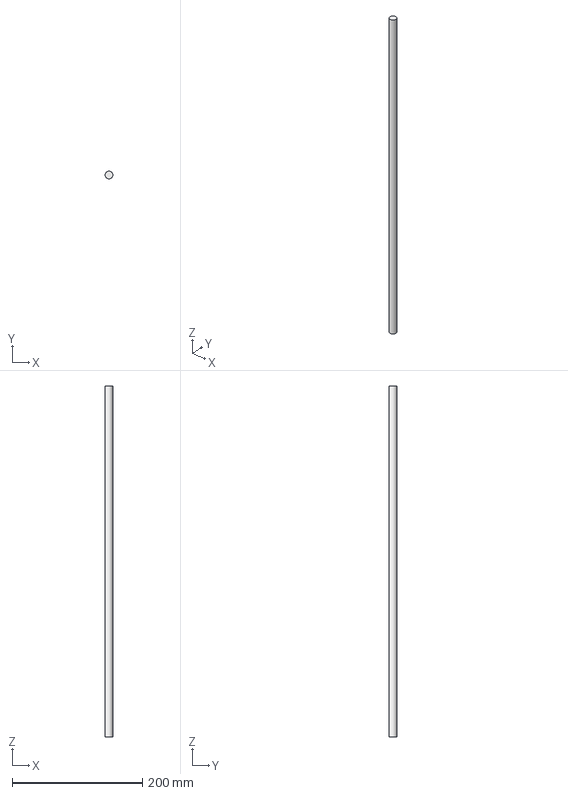
[picture p56: CAD file, 2020-06-04]
Mechanical/Machined_parts/10_12_mm_smooth_rods/[100063] Machined Part, 12mmx538mm Rod, Syn1.FCStd
12.0 x 12.0 x 538.0 mm
