SynDaverCO/syndaver-axi/Mechanical/Printed_parts/electronics_chassis_mount_back/electronics_chassis_mount_back_v1.1.FCStd

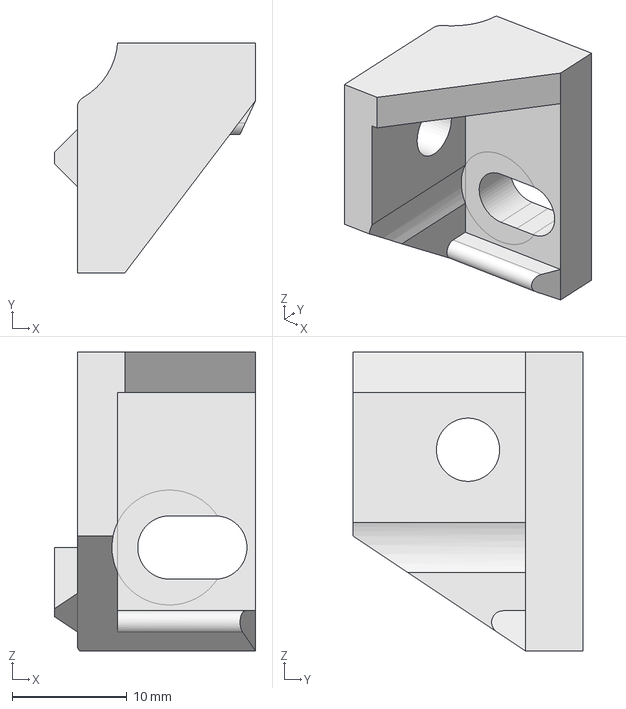
[picture p57: CAD file, 2020-06-04]
Mechanical/Printed_parts/electronics_chassis_mount_back/electronics_chassis_mount_back_v1.1.FCStd
17.5 x 20.0 x 26.0 mm
