SynDaverCO/syndaver-axi/Mechanical/Machined_parts/10_12_mm_smooth_rods/[100061] Machined Part, 10mmx403mm Rod, Syn1.FCStd

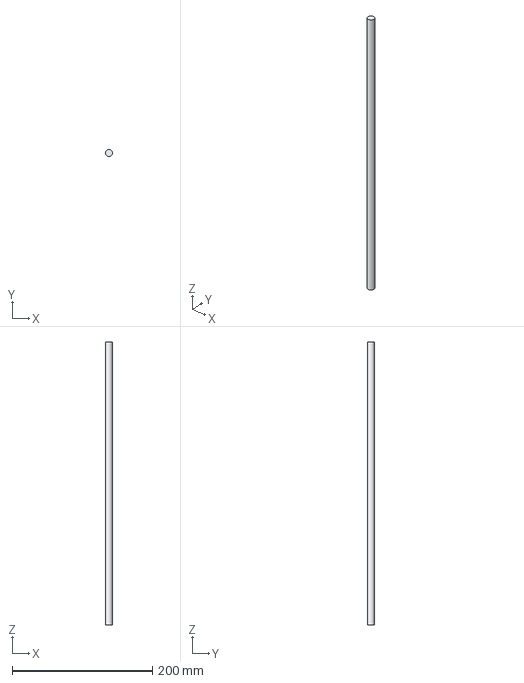
[picture p58: CAD file, 2020-06-04]
Mechanical/Machined_parts/10_12_mm_smooth_rods/[100061] Machined Part, 10mmx403mm Rod, Syn1.FCStd
9.99 x 10.00 x 403.0 mm
