SynDaverCO/syndaver-axi/(list of files, cad)

Other CAD files:
Mechanical/Printed_parts/heatsink_mount/heatsink_mount_0.3.stl
Mechanical/Sheetmetal/Sheet_Metal-Bed_Mount_Plate-Syn1/[100060] Sheet Metal, Bed Mount Plate, Syn1.FCStd
Electrical/Die_cut_contact_pads/Die_Cut-LCD_Ground_Pad-Syn1/[100069] Die Cut, LCD Ground Pad, Syn1.FCStd
Electrical/Die_cut_contact_pads/Die_Cut-USB_ESD_Fingers-Syn1/[100073] Die Cut, USB ESD Fingers, Syn1.FCStd
Mechanical/Machined_parts/Machined_Part-Archim_Heatsink-Syn1/[100064] Machined Part, Archim Heatsink, Syn1.fcstd
Mechanical/Machined_parts/Machined_Part-YZ_Idler-Syn1/[100071] Machined Part, YZ Idler, Syn1.FCStd
Mechanical/Printed_parts/10mm_bushing_retaining_ring/10mm_bushing_retaining_ring_v0.1.stl
Mechanical/Printed_parts/12mm_bushing_retaining_ring/12mm_bushing_retaining_ring.stl
Mechanical/Printed_parts/USB_bezel/USB_bezel_v1.1.stl
Mechanical/Printed_parts/USB_mount/USB_mount_v0.1.stl
Mechanical/Printed_parts/bed_corner/bed_corner_v2.2.3.stl
Mechanical/Printed_parts/bed_mount_chassis/bed_mount_chassis_v3.6.stl
Mechanical/Printed_parts/bed_mount_table/bed_mount_table_v1.1.stl
Mechanical/Printed_parts/belt_anchor/Z_belt_anchor_v1.1.stl
Mechanical/Printed_parts/cable_clip/cable_clip_v0.1.stl
Mechanical/Printed_parts/electronics_chassis_mount_back/electronics_chassis_mount_back_v1.1.stl
Mechanical/Printed_parts/electronics_chassis_mount_back/electronics_chassis_mount_back_v1.fcstd
Mechanical/Printed_parts/electronics_chassis_mount_back/electronics_chassis_mount_back_v1.stl
Mechanical/Printed_parts/electronics_chassis_mount_front/electronics_chassis_mount_front_v1.stl
Mechanical/Printed_parts/extruder_harness_cable_guide/extruder_harness_cable_guide_v0.1.stl
Mechanical/Printed_parts/flexy_bed_foot/flexy_bed_foot_v0.1.stl
Mechanical/Printed_parts/frame_foot/frame_foot_v0.1.stl
Mechanical/Printed_parts/interconnect_housing_bottom/interconnect_housing_bottom_v0.1.stl
Mechanical/Printed_parts/interconnect_housing_top/interconnect_housing_top.stl
Mechanical/Printed_parts/interconnect_strain_relief/interconnect_strain_relief_v0.4.stl
Mechanical/Printed_parts/lcd_back/LCD_back_V0.2.3.stl
Mechanical/Printed_parts/lcd_bezel/LCD_bezel_V0.3.stl
Mechanical/Printed_parts/lcd_center/LCD_center_V0.2.stl
Mechanical/Printed_parts/spool_arm/spool_arm_v1.2.stl
Mechanical/Printed_parts/wiper_mount/wiper_mount_v2.1.stl
Mechanical/Printed_parts/x_bearing_holder/x_bearing_holder_v0.2.3.stl
Mechanical/Printed_parts/x_belt_clamp/x_belt_clamp_v0.1.stl
Mechanical/Printed_parts/x_belt_tensioner/x_belt_tensioner_0.2.stl
Mechanical/Printed_parts/x_belt_tensioner_clamp/x_belt_tensioner_clamp.stl
Mechanical/Printed_parts/x_carriage_cover/x_carriage_cover_v2.1.stl
Mechanical/Printed_parts/x_idler/vr_x_idler_v4.stl
Mechanical/Printed_parts/y_bearing_holder/Y_bearing_holder_v1.4-12mm.stl
Mechanical/Printed_parts/y_belt_clamp/Y_belt_clamp_v0.3.stl
Mechanical/Printed_parts/y_belt_mount/y_belt_mount_v0.3.stl
Mechanical/Printed_parts/y_cable_cover/y_cable_cover_v1.3.stl
Mechanical/Printed_parts/y_cable_mount/y_cable_mount_v0.1.stl
Mechanical/Printed_parts/y_corner_left/y_corner_left_v1.4-12mm.stl
Mechanical/Printed_parts/y_corner_right/y_corner_right_v1.4-12mm.stl
Mechanical/Printed_parts/y_idler_housing/Y_idler_housing_v0.2.stl
Mechanical/Printed_parts/y_motor_mount/Y_motor_mount_v0.2.stl
Mechanical/Printed_parts/z_lower_left/Z_lower_leftv2.5.stl
Mechanical/Printed_parts/z_lower_right/Z_lower_rightv2.5.stl
Mechanical/Printed_parts/z_upper_left/Z_upper_leftv3.7.stl
Mechanical/Printed_parts/z_upper_right/Z_upper_rightv3.7.stl
Mechanical/Sheetmetal/Sheet_Metal-Chassis_Cover-Syn1/[100080] Sheet Metal, Chassis Cover, Syn1.FCStd
Mechanical/Sheetmetal/Sheet_Metal-Corner_Bracket-Syn1/[100065] Sheet Metal, Corner Bracket, Syn1.FCStd
Mechanical/Sheetmetal/Sheet_Metal-Electronics_Chassis-Syn1/[100067] Sheet Metal, Electronics Chassis, Syn1.FCStd
Mechanical/Sheetmetal/Sheet_Metal-Interconnect_Cover-Syn1/[100068] Sheet Metal, Interconnect Cover, Syn1.FCStd
Mechanical/Sheetmetal/Sheet_Metal-Y_End_Plate-Syn1/[100070] Sheet Metal, Y End Plate, Syn1.FCStd
Mechanical/Sheetmetal/Sheet_Metal-Z_Top_Plate-Syn1/[100072] Sheet Metal, Z Top Plate, Syn1.FCStd
