SynDaverCO/syndaver-axi/Electrical/Cable_drawings/Control_box/[100007] Harness, CB PSU to Ground Green, Assembled, Syn1 [REV A].pdf

DRAWN BY: SAW | DATE: 01/14/2020 | 3121 N Garfield Ave Loveland, CO. 80538 Phone: 1-970-685-4501
CHECKED BY: CHECKED | DATE: XX/XX/XXXX
UNLESS OTHERWISE SPECIFIED DIMENSIONS ARE IN MILLIMETERS. TOLERANCES ARE: CUT LENGTHS ±3MM STRIP LENGTHS ±.5 | | TITLE: Harness, CB PSU to Ground Green, Assembled, Syn1
DRAWING NUMBER: 100007 | SIZE: A4
RoHS COMPLIANT | REV: A
DO NOT SCALE DRAWING | SHEET:1 OF 1
Copyright 2020 Syndaver Labs CC-BY-SA 4.0, modified from designs from Aleph Objects, Inc. hps://creavecommons.org/licenses/by-sa/4.0/legalcode | | BOM
ITEM | QTY | UNIT | SUPPLIER | SUPPLIER P/N
A | 1 | PCE | Digikey | A27229TR-ND
B | 100 | mm | Allcable | HU15691626GN
C | 1 | PCE | TTI | 2-34541-1
Conn Ring 16-22 AWG | Cut Length = 100mm +/- 2mm
#4 Red PIDG | 16awg Green-Yellow Stripe Wire

Strip 7mm | Strip 7mm

## Conn spade term 16-22AWG

1x [B]

1x [A]
1x [C]
REV | BY | DATE | NOTE
A | SAW | 1/27/2020 | UPDATED [C] IMAGE - VISUAL ONLY
