SynDaverCO/syndaver-axi/Electrical/Cable_drawings/Control_box/[100008] Harness, CB DC Power Harness, Assembled, Syn1 [REV B].pdf

DRAWN BY: SAW | DATE: 01/14/2020 | 3121 N Garfield Ave Loveland, CO. 80538 Phone: 1-970-685-4501
CHECKED BY: CHECKED | DATE: XX/XX/XXXX
UNLESS OTHERWISE SPECIFIED DIMENSIONS ARE IN MILLIMETERS. TOLERANCES ARE: CUT LENGTHS ±3MM STRIP LENGTHS ±.5 | | TITLE: Harness, CB DC Power Harness, Assembled, Syn1
DRAWING NUMBER: 100008 | SIZE: A4
RoHS COMPLIANT | REV: B
DO NOT SCALE DRAWING | SHEET: 1 OF 1
Copyright 2020 Syndaver Labs CC-BY-SA 4.0, modified from designs from Aleph Objects, Inc. hps://creavecommons.org/licenses/by-sa/4.0/legalcode | | BOM
ITEM | QTY | UNIT | SUPPLIER | SUPPLIER P/N
A | 1650 mm | | Allcable | HU15691626BK
B | 1650 mm | | Allcable | HU15691626RD
C | 1 | PCE | TTI | 0395300006
D | 6 | PCE | TTI | FSD78-6-D
E | 6 | PCE | TTI | 2-34541-1

### Cut Length = 550mm +/- 3mm

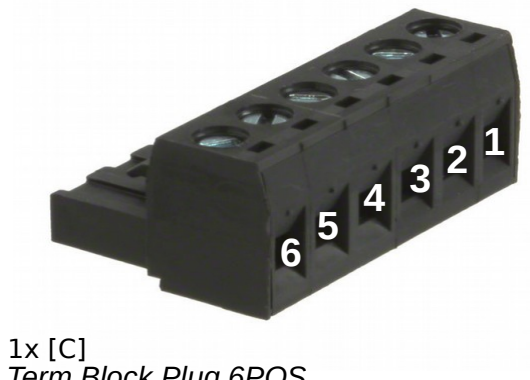
[picture p59: figure]

16 AWG 6.0mm Pin Length
Power Phase Black Single
Wire - Insulated Ferrule
Strip 7mm | 16awg Black Wire | Strip 7mm

16awg Red Wire

Pin 1

Pin 2

Pin 3

Pin 4

Pin 5

Term Block Plug 6POS | Pin 6
STR 5.08mm

Conn spade term 16-22AWG

6x [E]

3x [A]

3x [B]

6x [D]

REV | BY | DATE | NOTES
A | SAW | 1/27/2020 | UPDATE [E] IMAGE - VISUAL ONLY
B | WEST | 3/20/2020 | CHANGE PN OF ITEM [C] TO CORRECT PN
