SynDaverCO/syndaver-axi/Electrical/Cable_drawings/Control_box/[100025] Harness, CB Case Fan Assembly, Syn1.pdf

DRAWN BY: SAW | DATE: 01/14/2020 | 3121 N Garfield Ave Loveland, CO. 80538 Phone: 1-970-685-4501
CHECKED BY: CHECKED | DATE: XX/XX/XXXX
UNLESS OTHERWISE SPECIFIED DIMENSIONS ARE IN MILLIMETERS. TOLERANCES ARE: CUT LENGTHS ±3MM STRIP LENGTHS ±.5 | | TITLE: Harness, CB Case Fan Assembly, Syn1
DRAWING NUMBER: 100025 | SIZE: A4
RoHS COMPLIANT | REV: IR
DO NOT SCALE DRAWING | SHEET:1 OF 1
Copyright 2020 Syndaver Labs CC-BY-SA 4.0, modified from designs from Aleph Objects, Inc. hps://creavecommons.org/licenses/by-sa/4.0/legalcode | | BOM
ITEM | QTY | UNIT | SUPPLIER | SUPPLIER P/N
A | 1 | PCE | Pelonis Technologies, Inc. | C8015L24BPLP1B-7
B | 1 | PCE | Sager Electronics | 50579402
C | 2 | PCE | TTI Global Distribuon | 16-02-0086

Pelonis FAN 24V 80x15mm Low flow

1x [A]

1x [B] Pin 1

Length = 100mm

Strip 4mm
Pin 2

Female 2pin Housing

Female Molex Pin

2x [C]
