SynDaverCO/syndaver-axi/Mechanical/Machined_parts/10_12_mm_smooth_rods/[100061] Machined Part, 10mmx403mm Rod, Syn1.pdf

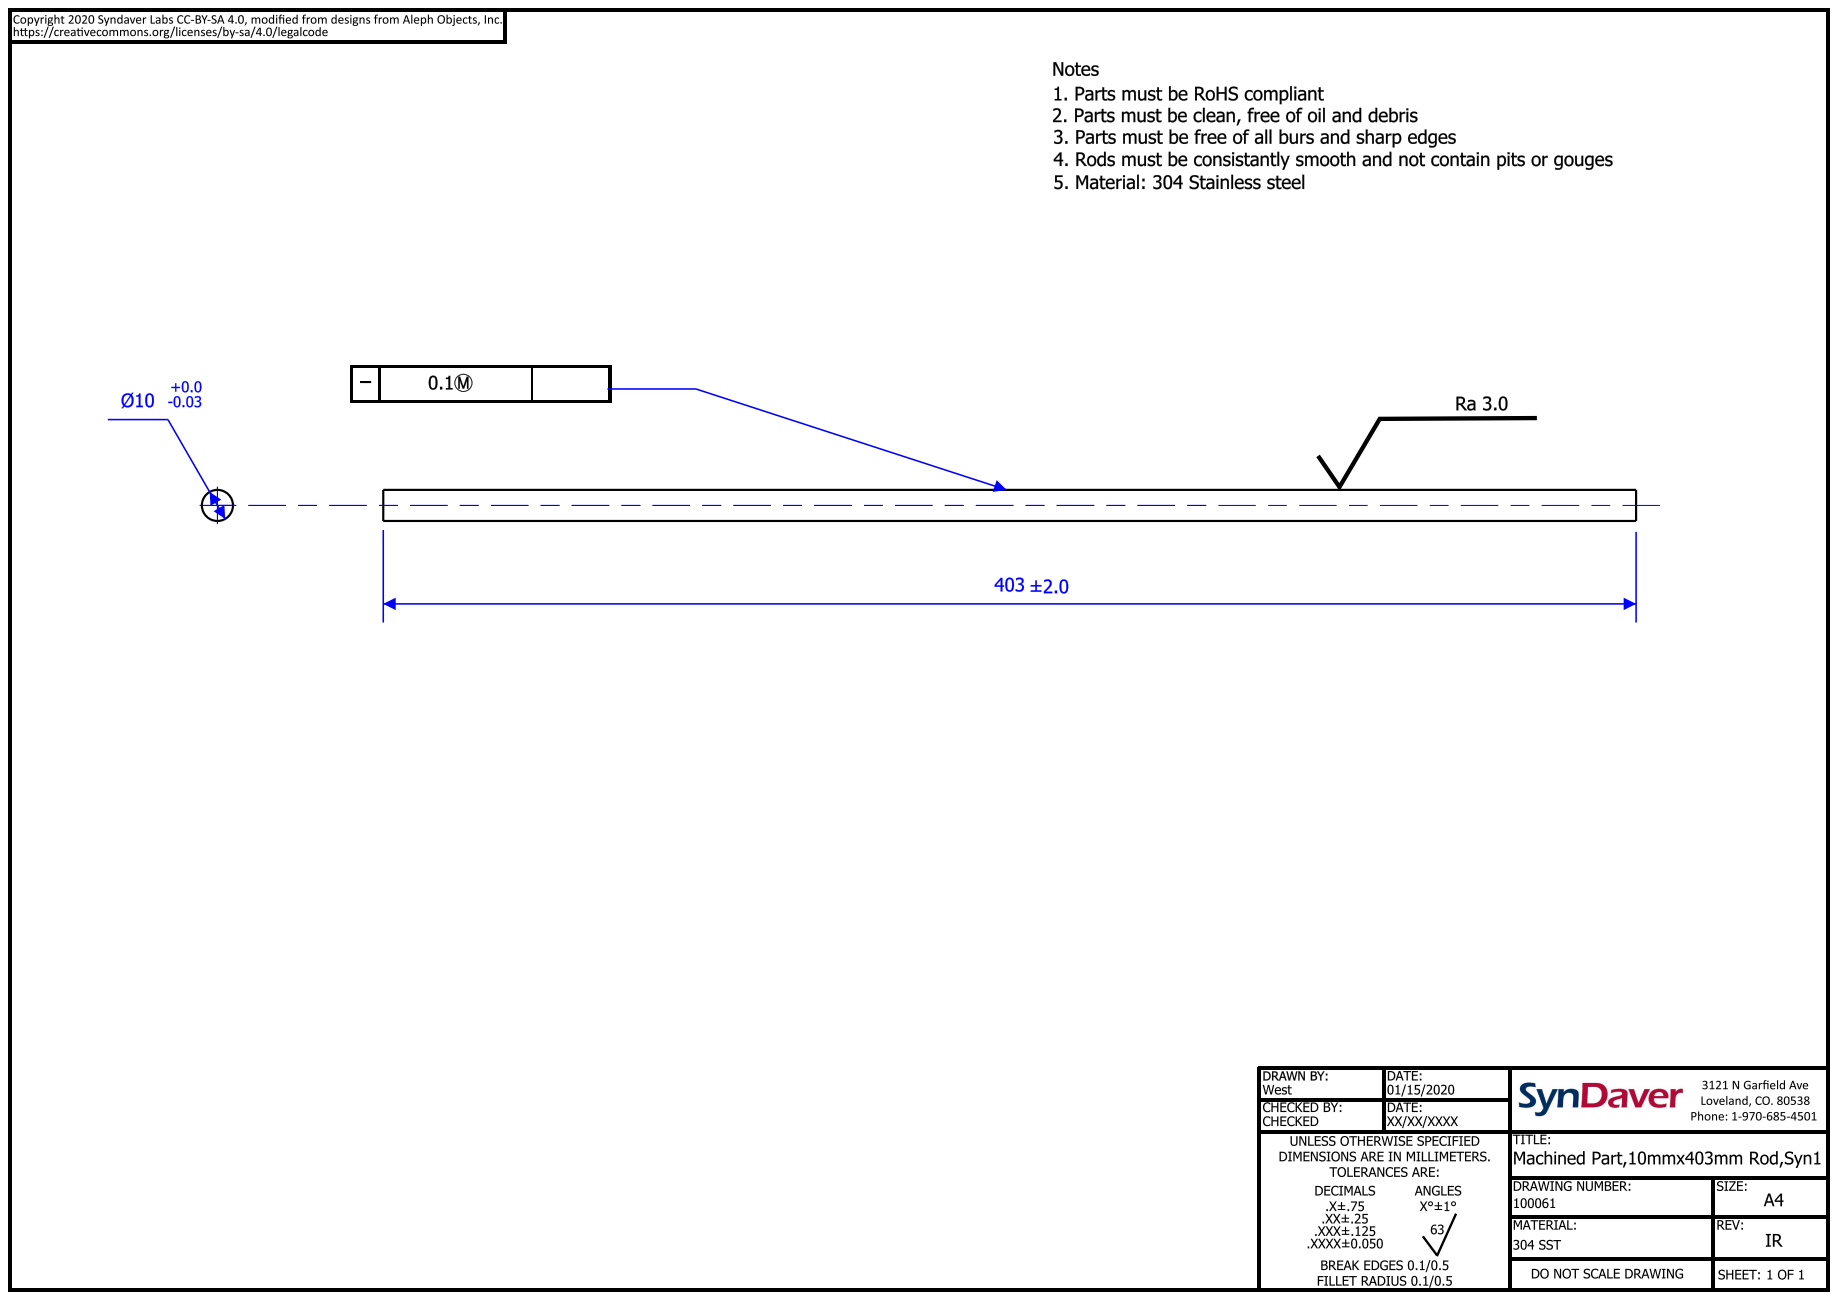
[picture p77: page 1]
