SynDaverCO/syndaver-axi/Mechanical/Machined_parts/10_12_mm_smooth_rods/[100062] Machined Part, 10mmx498mm Rod, Syn1.pdf

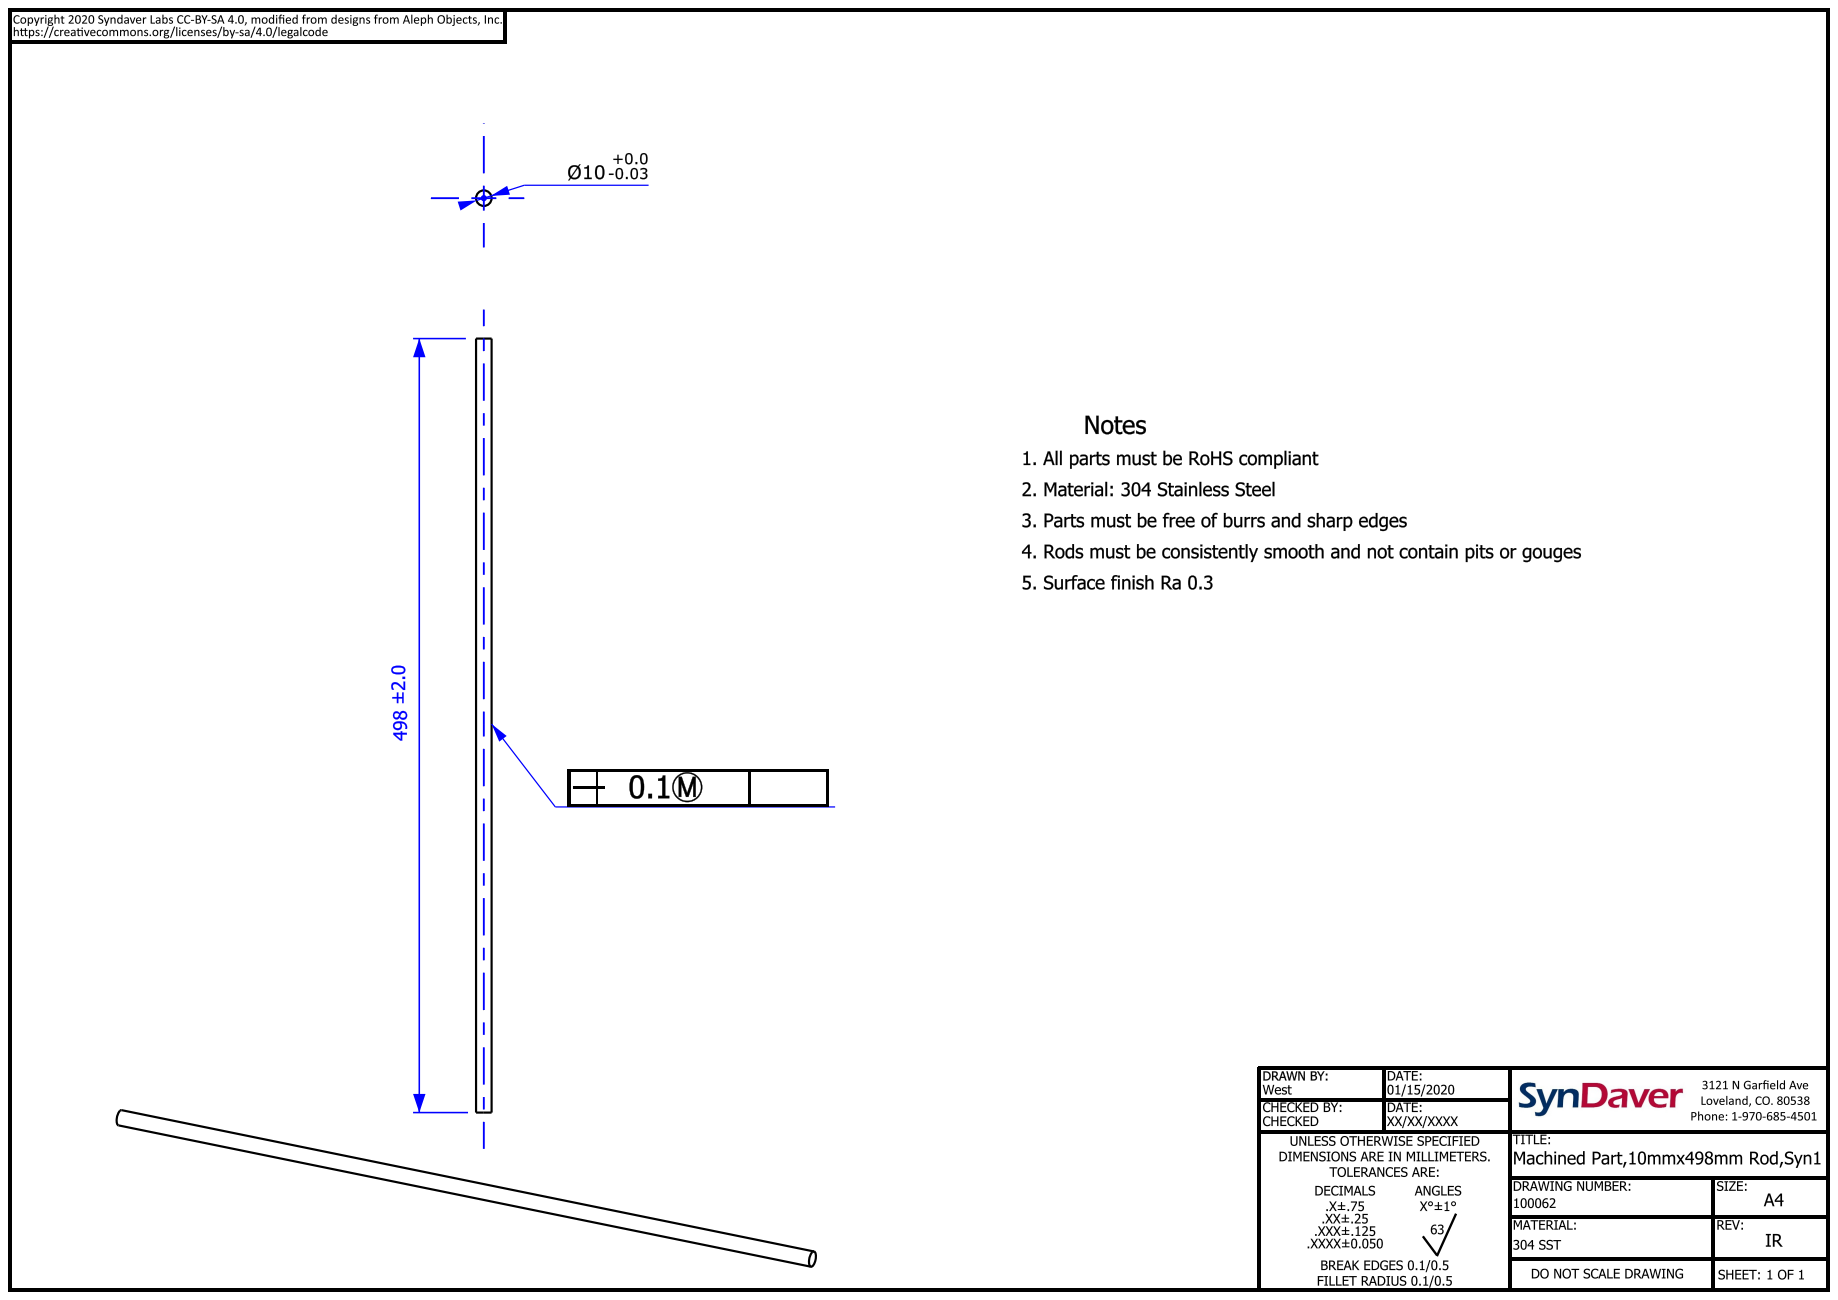
[picture p78: page 1]
