SynDaverCO/syndaver-axi/Mechanical/Machined_parts/10_12_mm_smooth_rods/[100063] Machined Part, 12mmx538mm Rod, Syn1.pdf

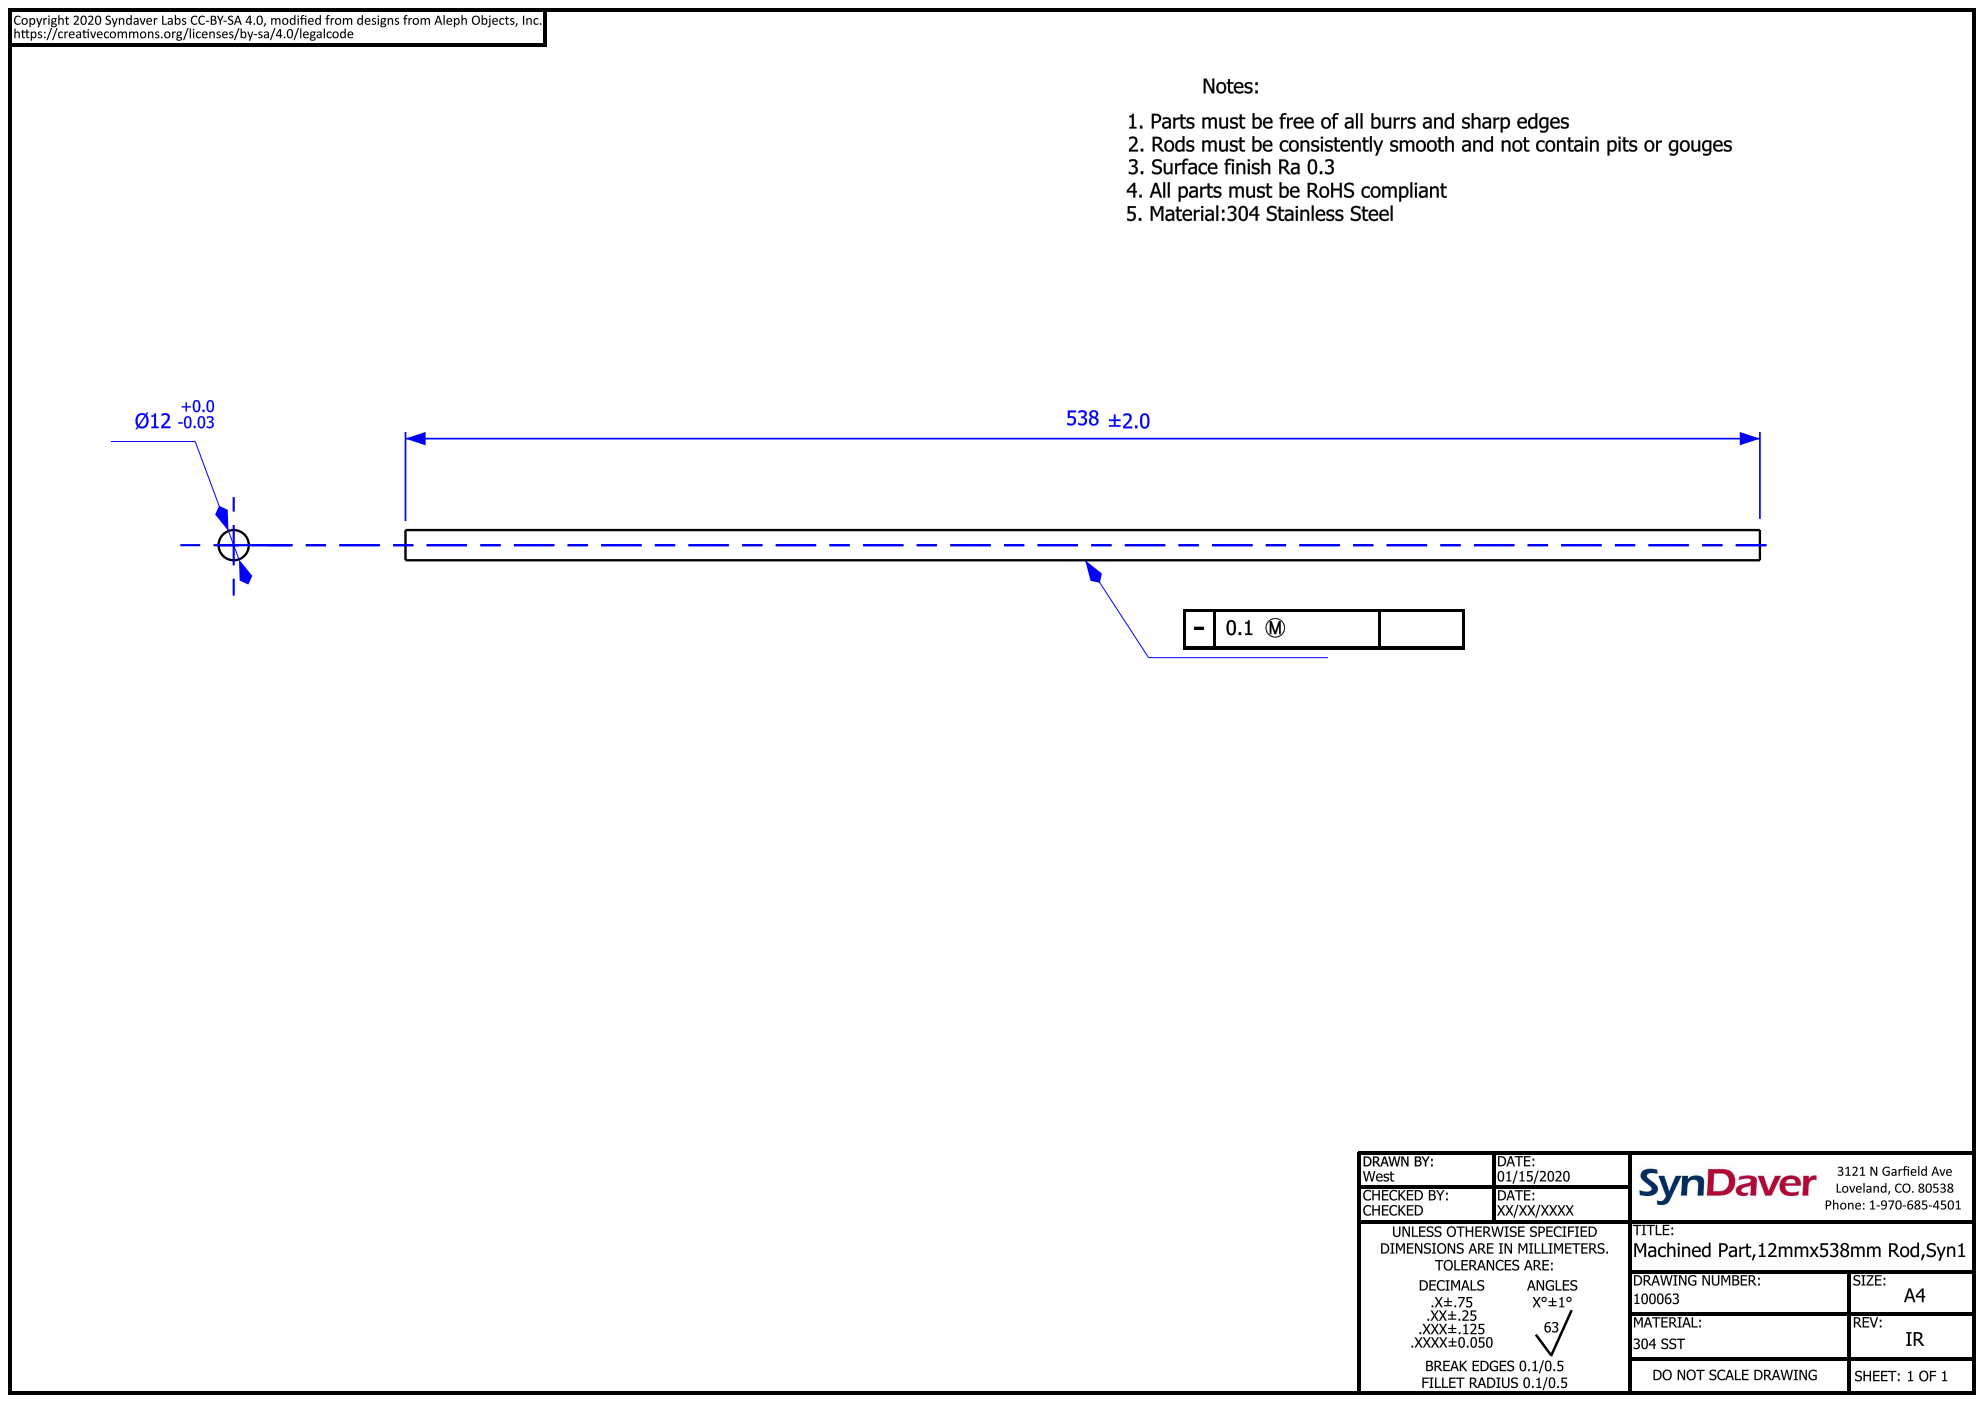
[picture p79: page 1]
