SynDaverCO/syndaver-axi/Mechanical/Machined_parts/Machined_Part-Archim_Heatsink-Syn1/[100064] Machined Part, Archim Heatsink, Syn1.pdf

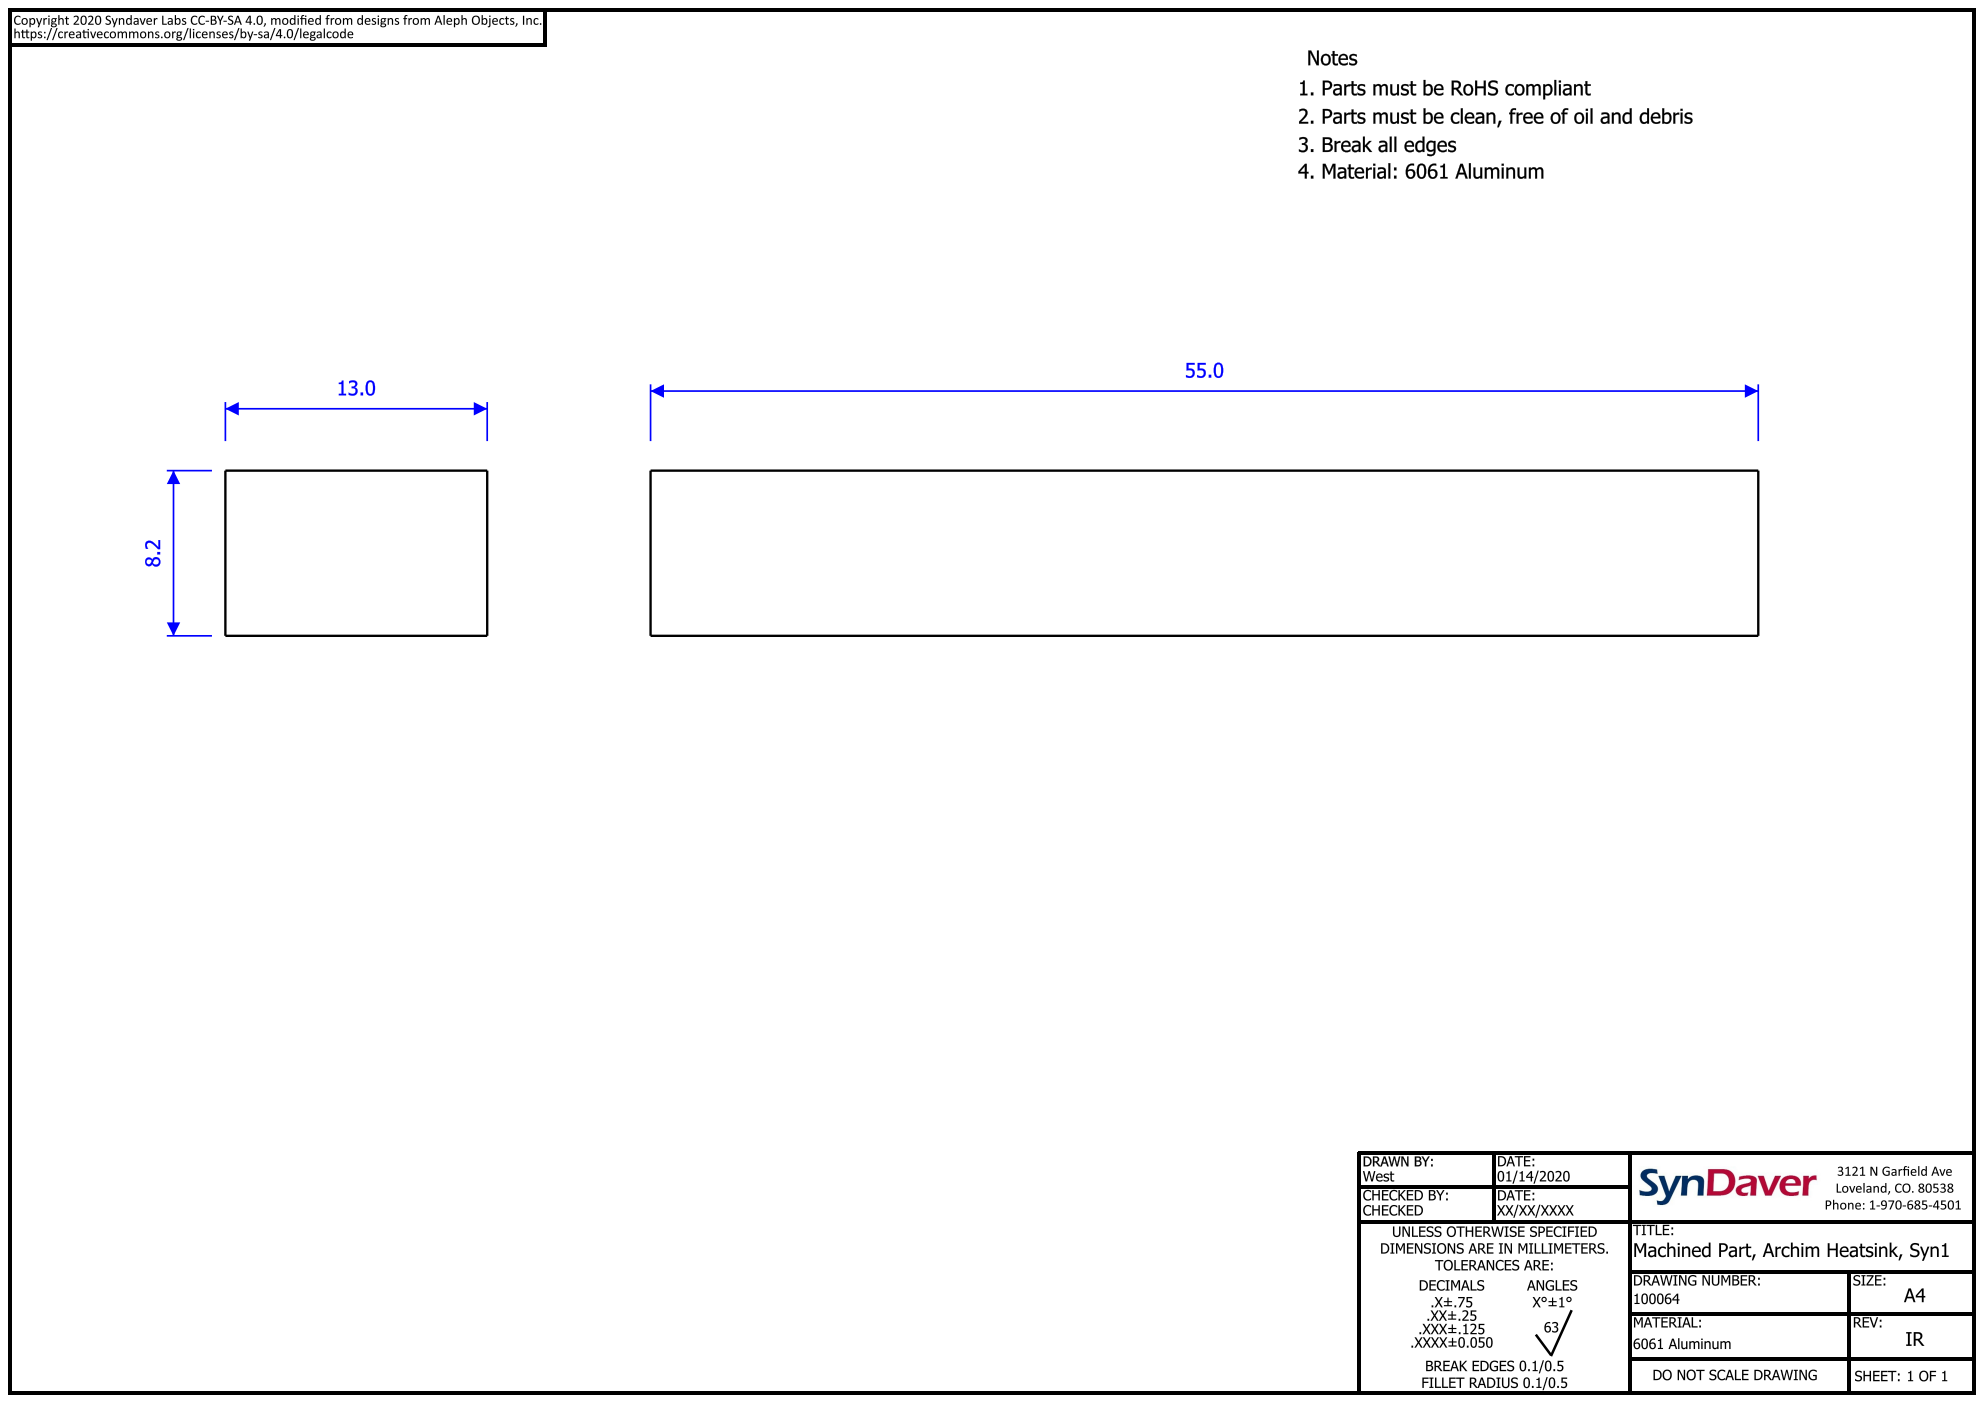
[picture p80: page 1]
