SynDaverCO/syndaver-axi/Mechanical/Machined_parts/Machined_Part-YZ_Idler-Syn1/[100071] Machined Part, YZ Idler, Syn1.pdf

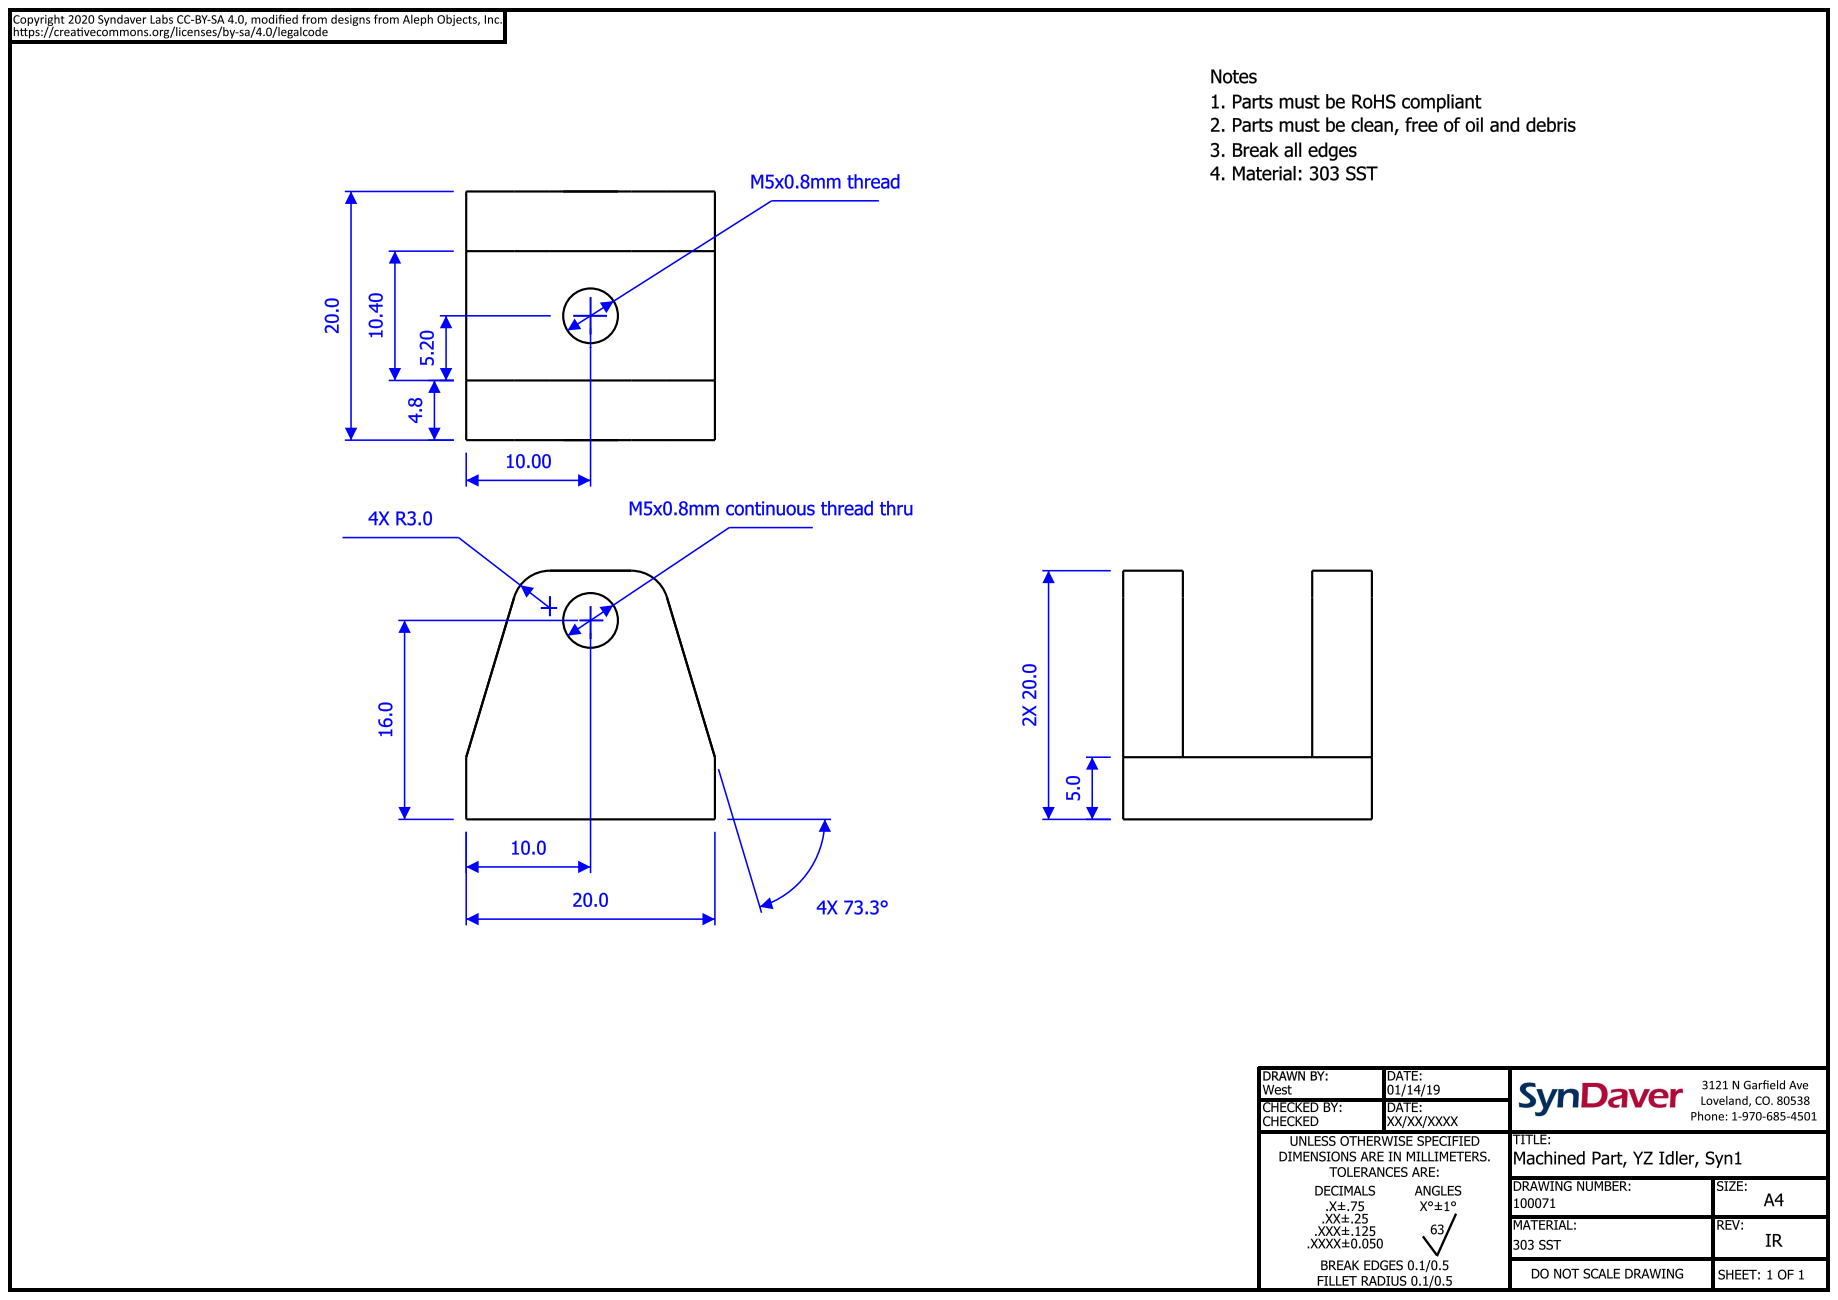
[picture p81: page 1]
