SynDaverCO/syndaver-axi/Mechanical/Sheetmetal/Sheet_Metal-Corner_Bracket-Syn1/[100065] Sheet Metal, Corner Bracket, Syn1 [Rev A].pdf

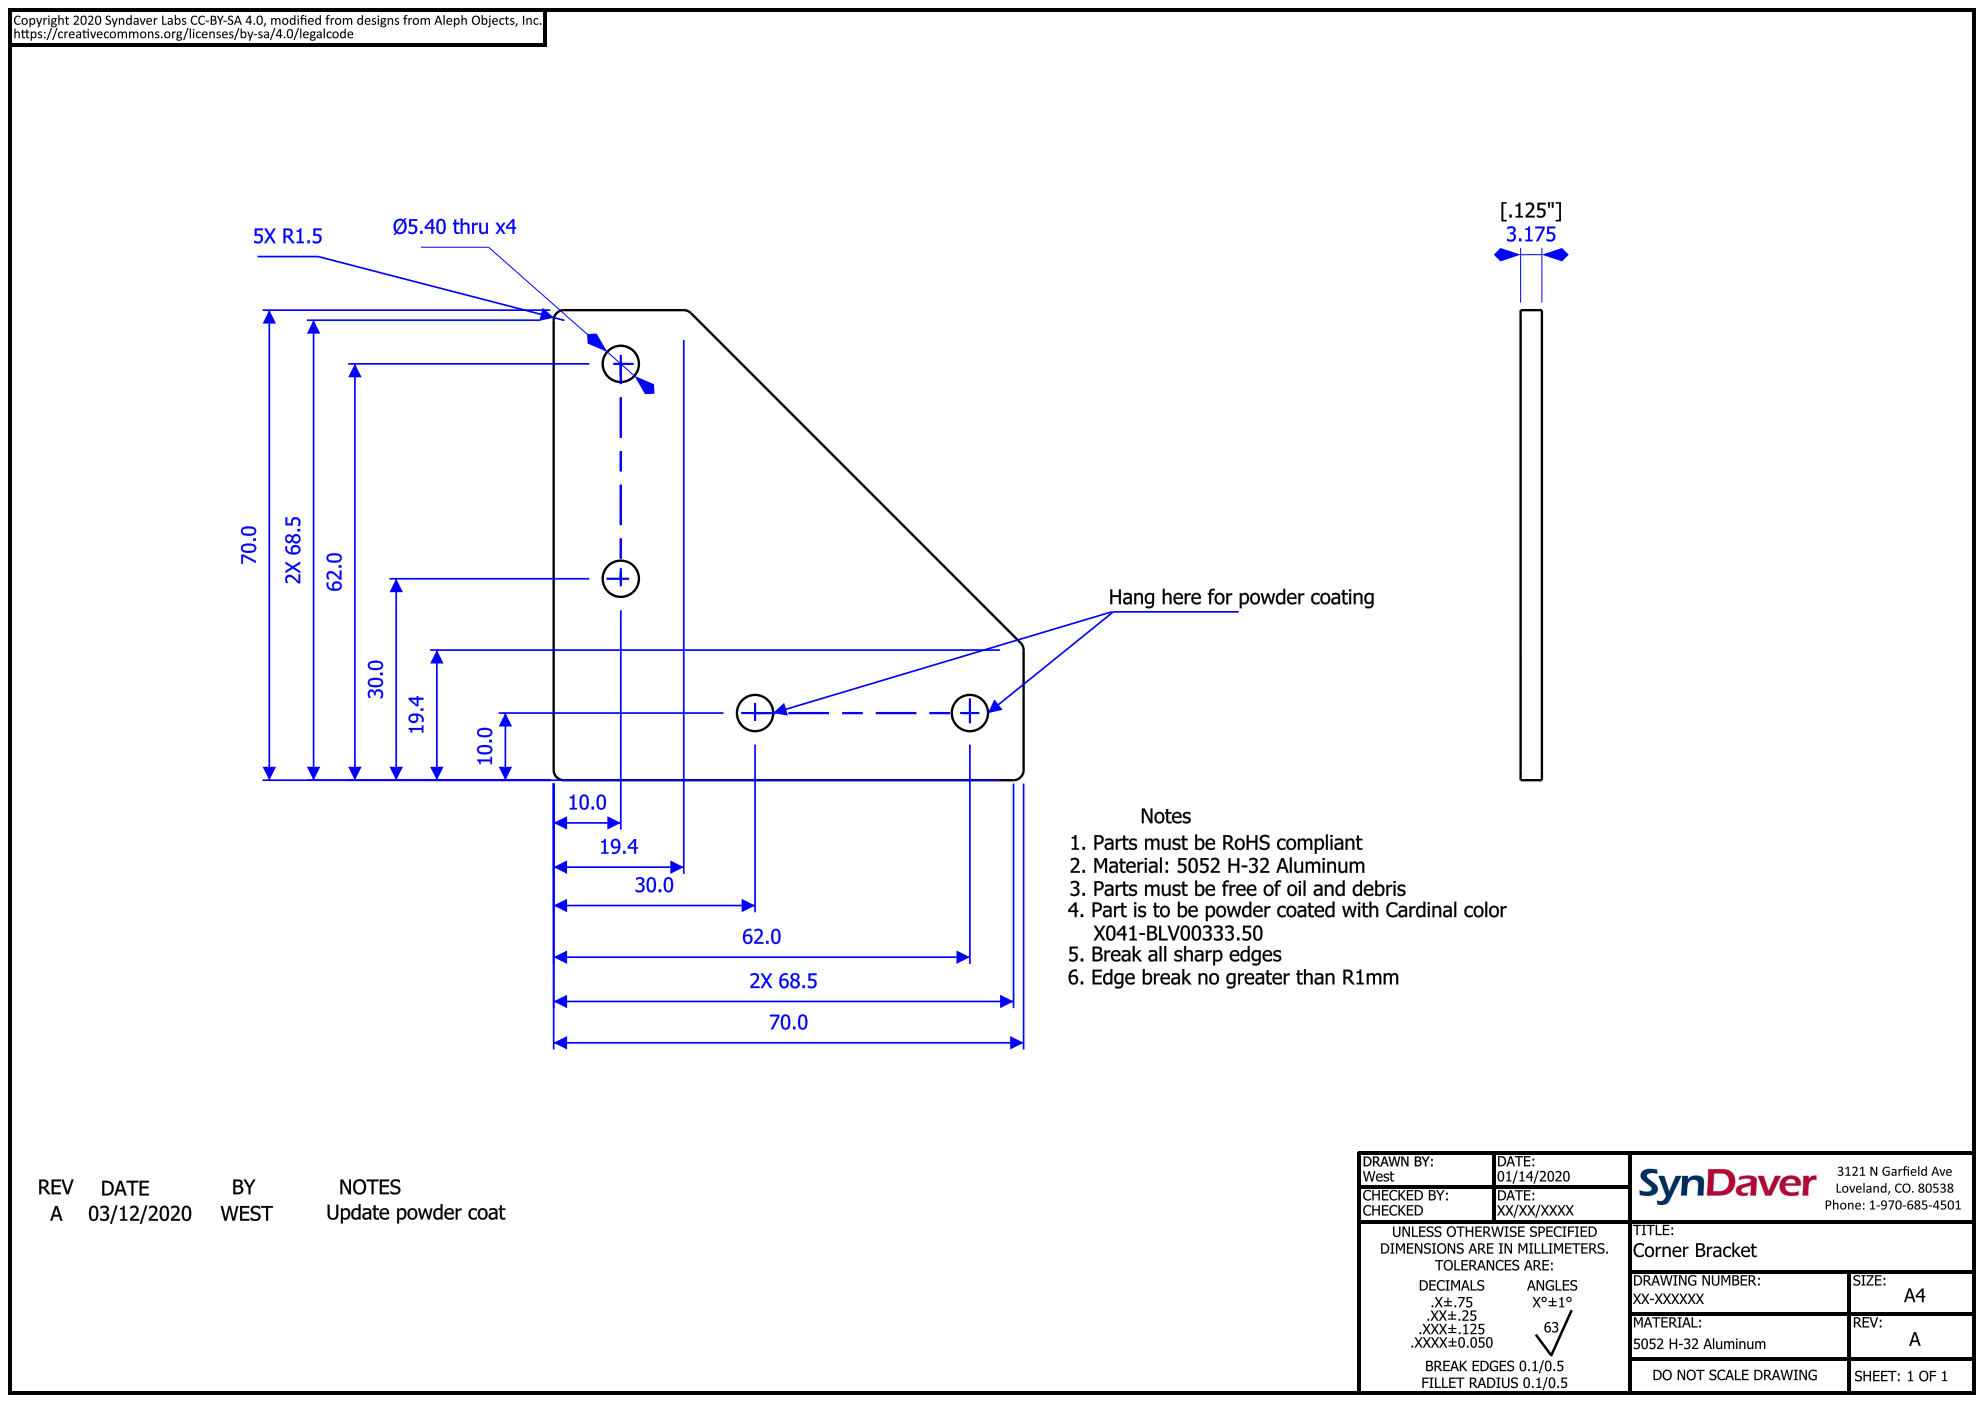
[picture p82: page 1]
