SynDaverCO/syndaver-axi/Mechanical/Sheetmetal/Sheet_Metal-Electronics_Chassis-Syn1/[100067] Sheet Metal, Electronics Chassis, Syn1 [REV B].pdf

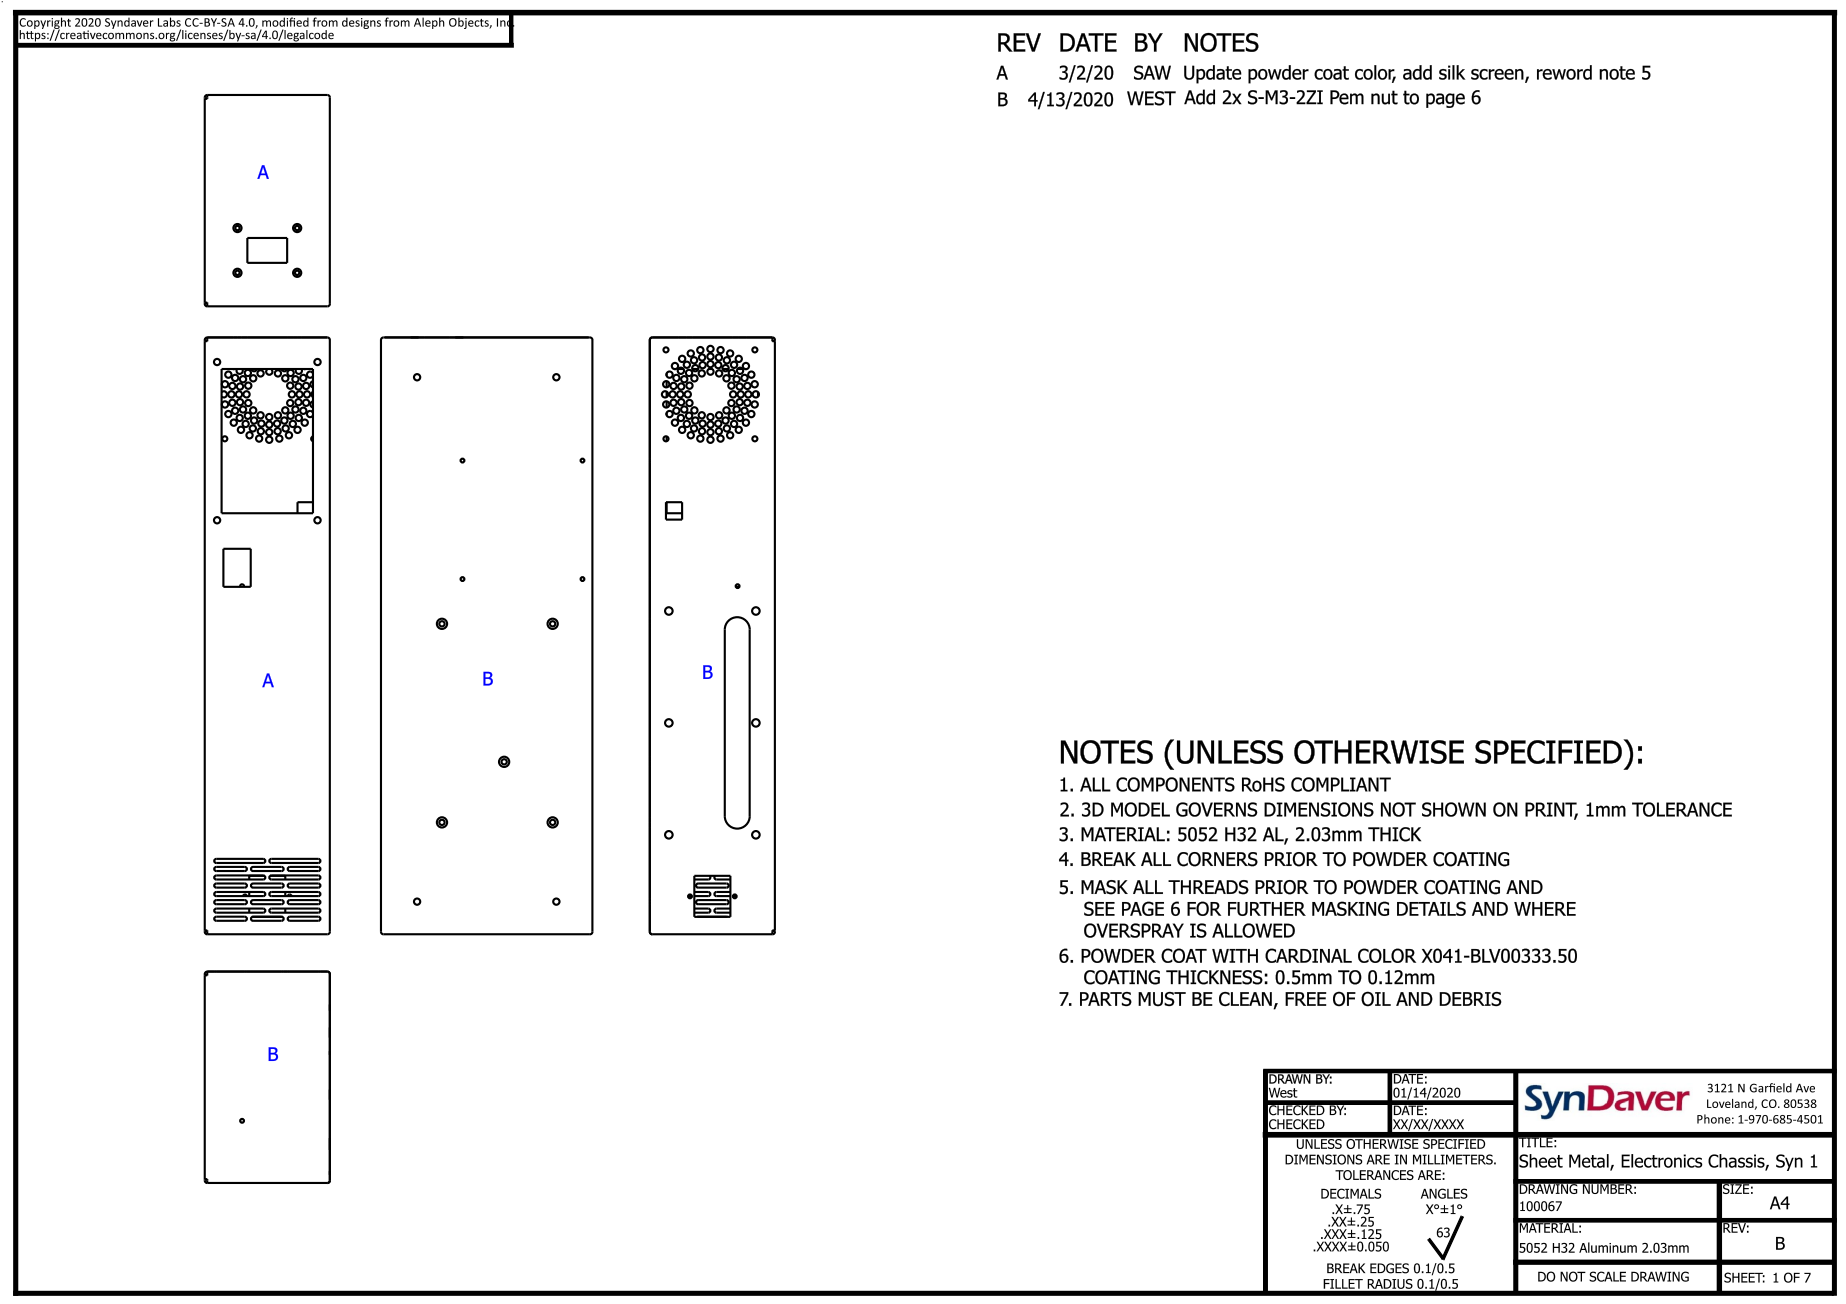
[picture p83: page 1]
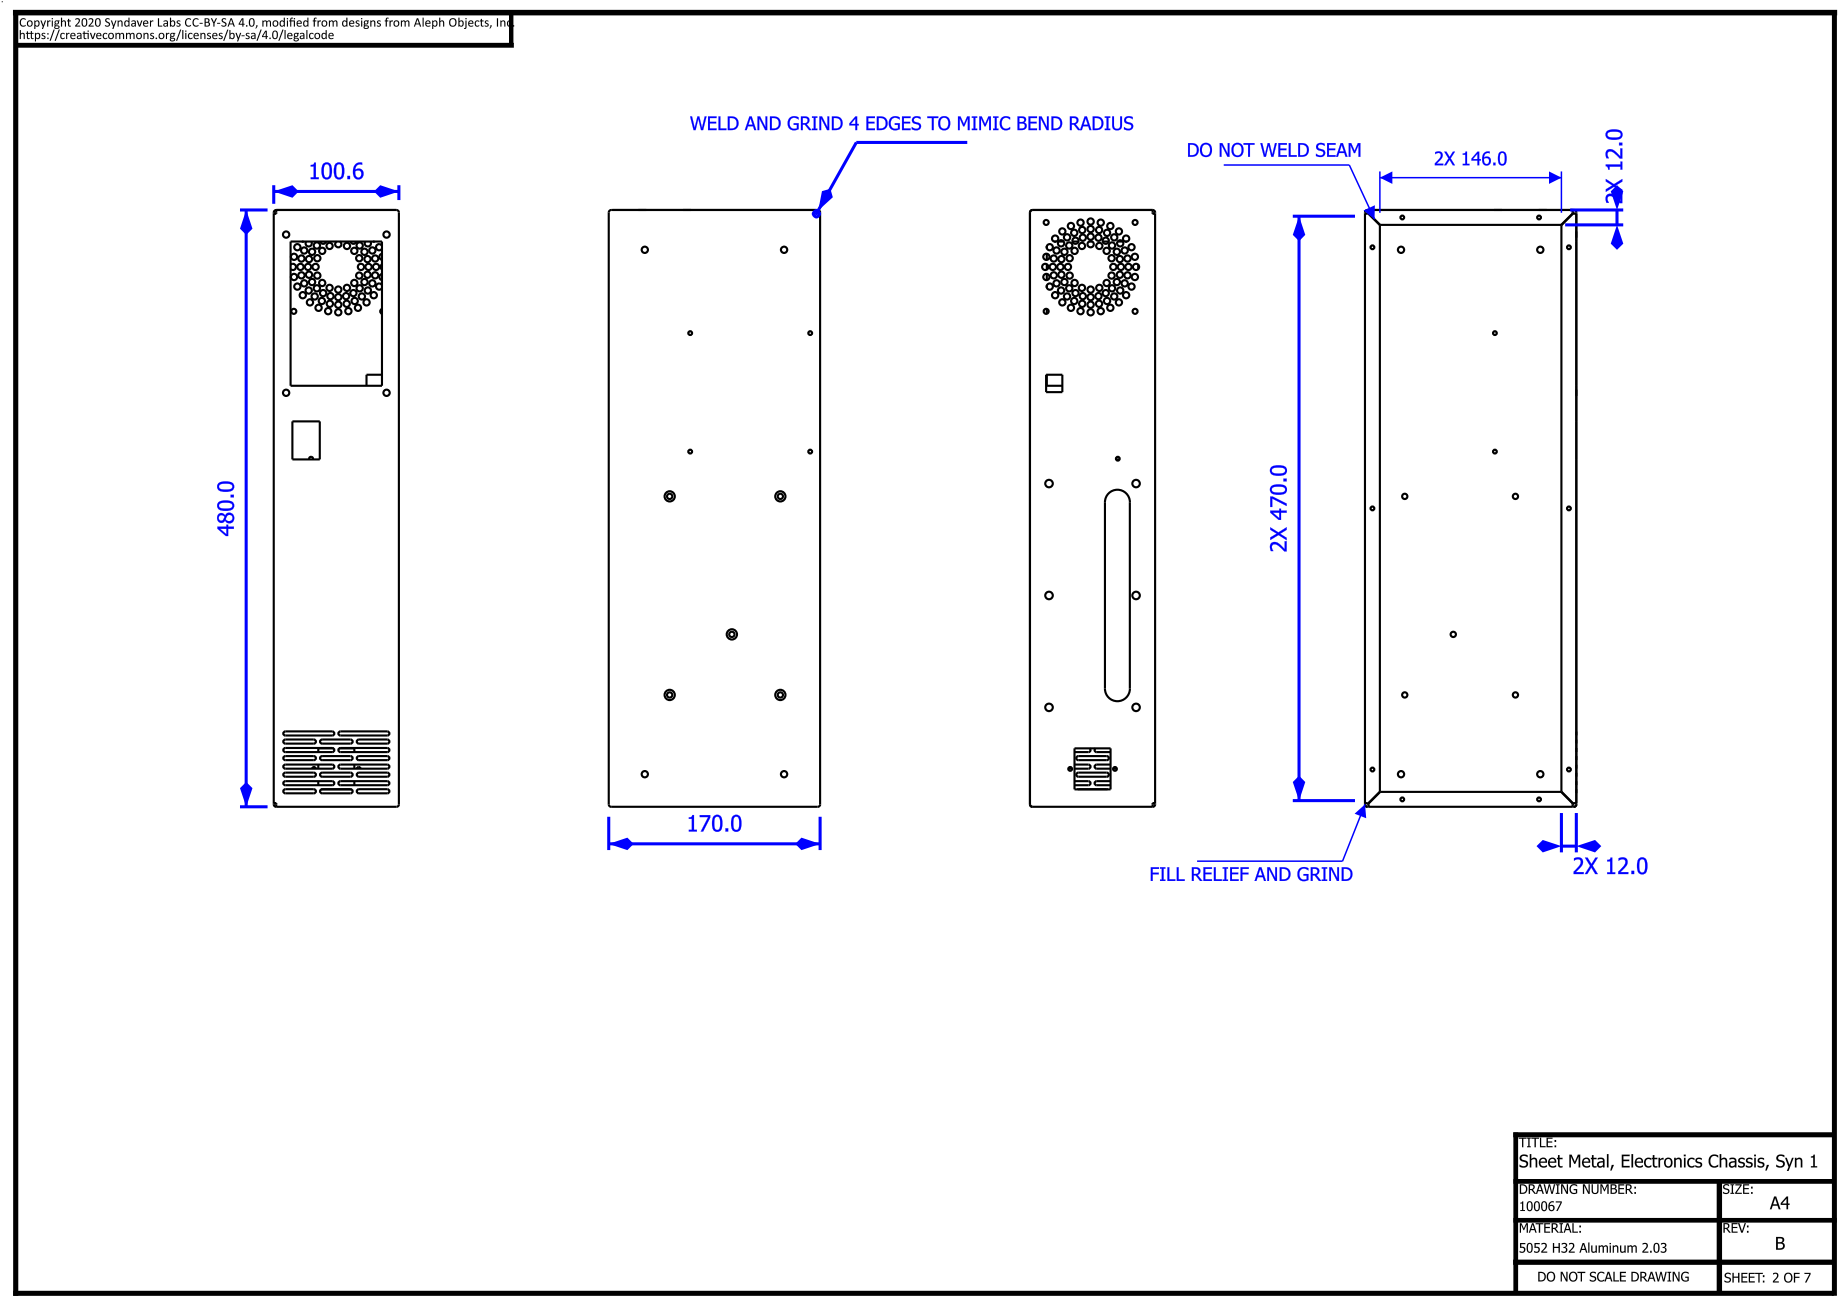
[picture p84: page 2]
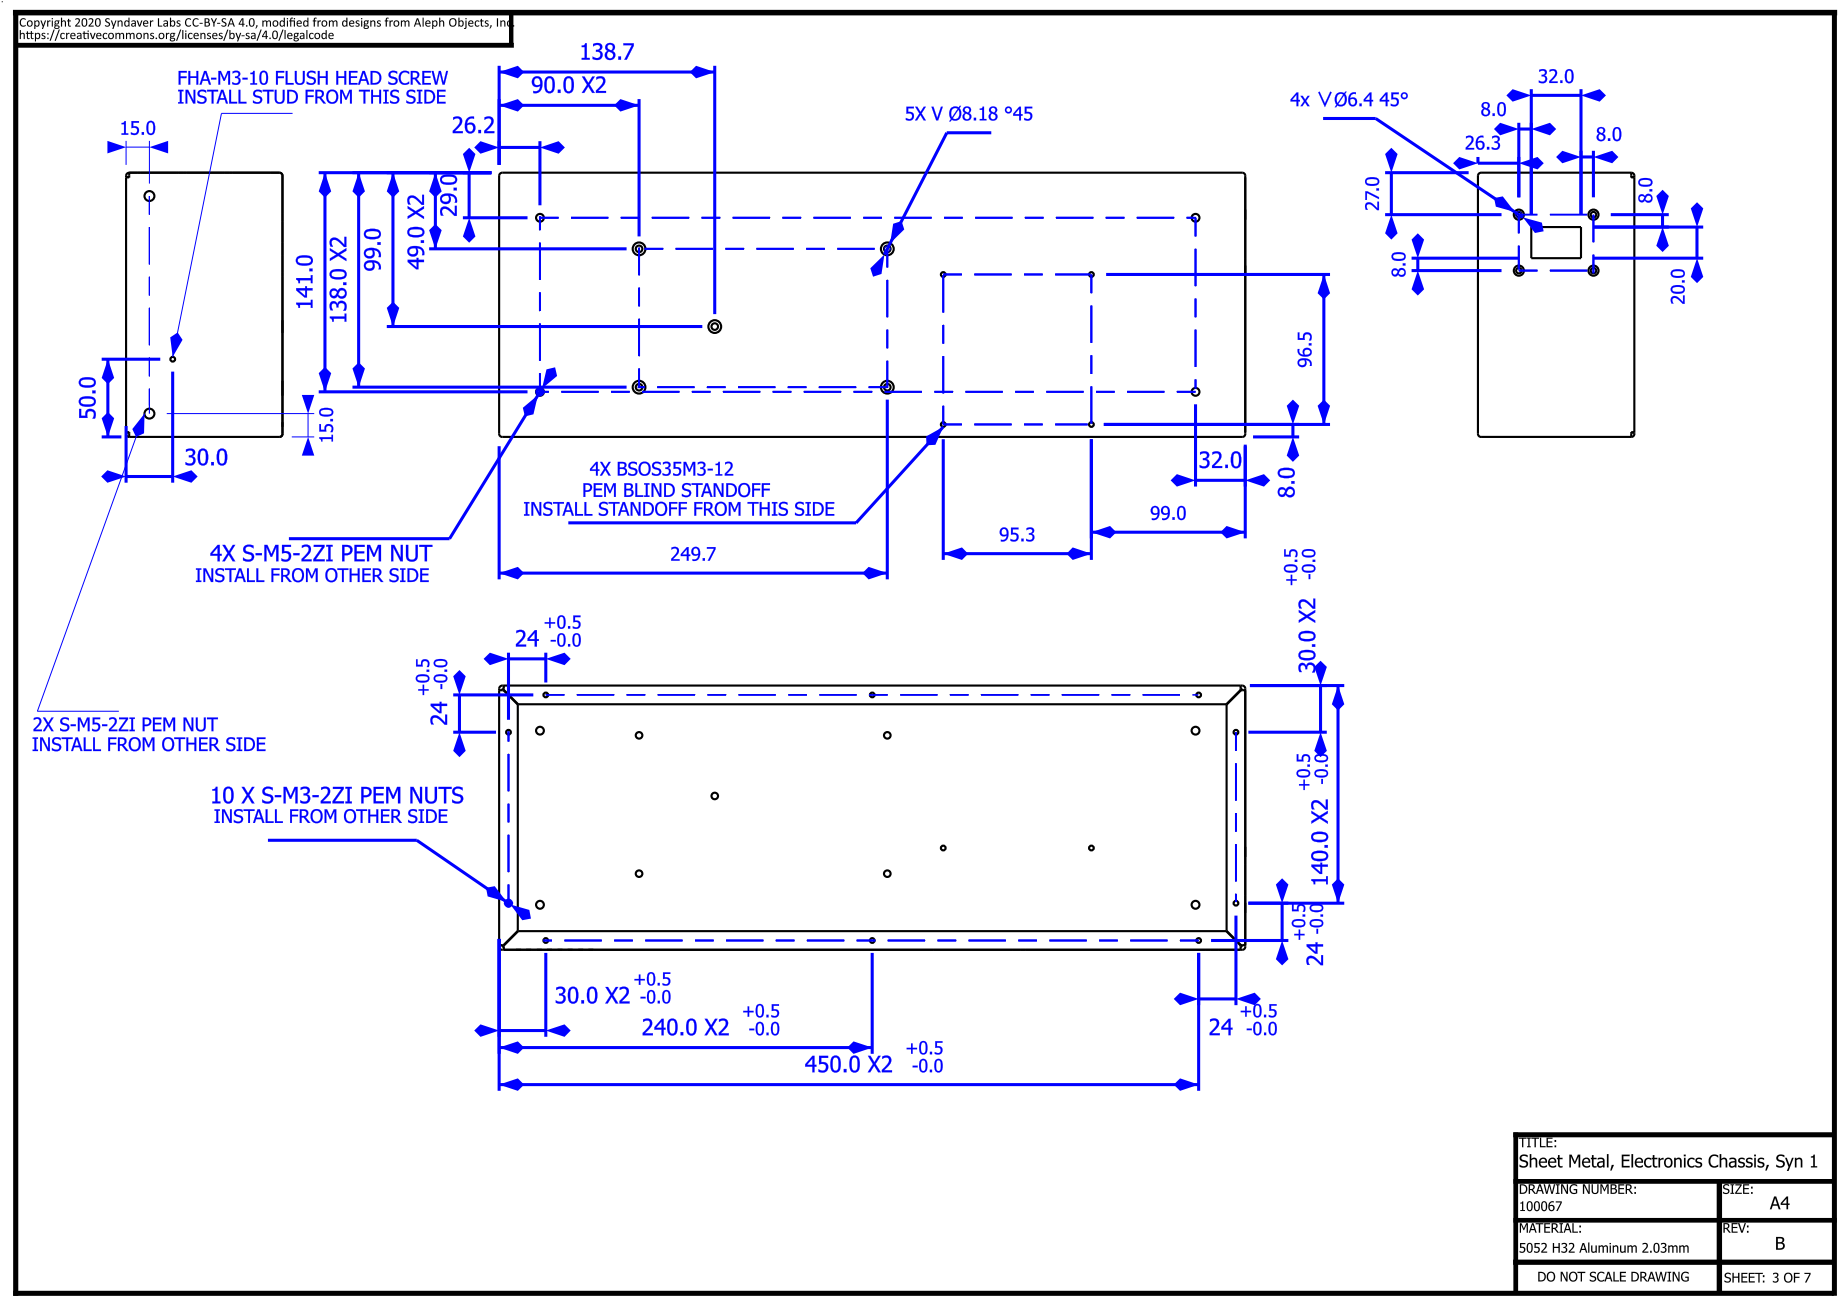
[picture p85: page 3]
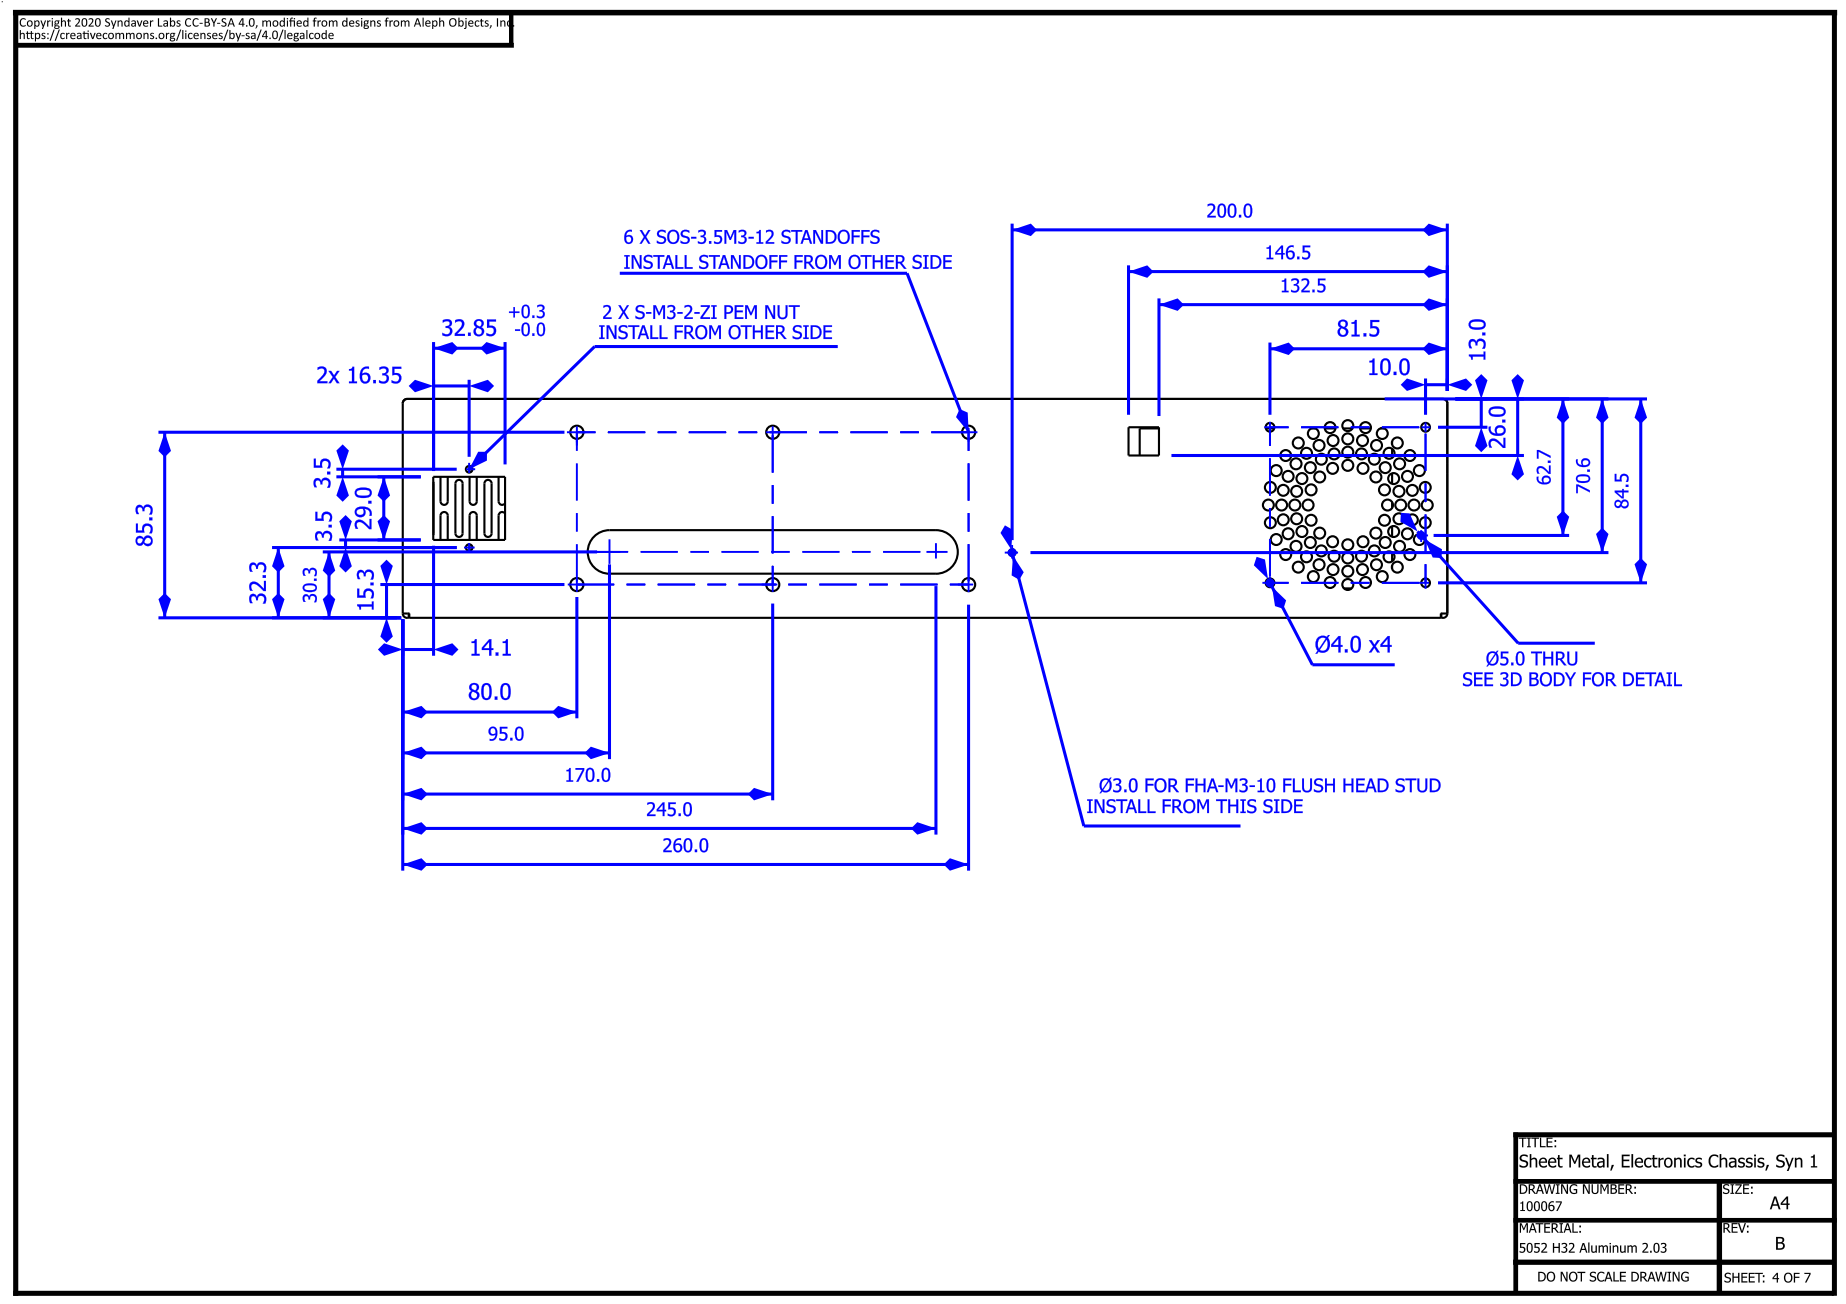
[picture p86: page 4]
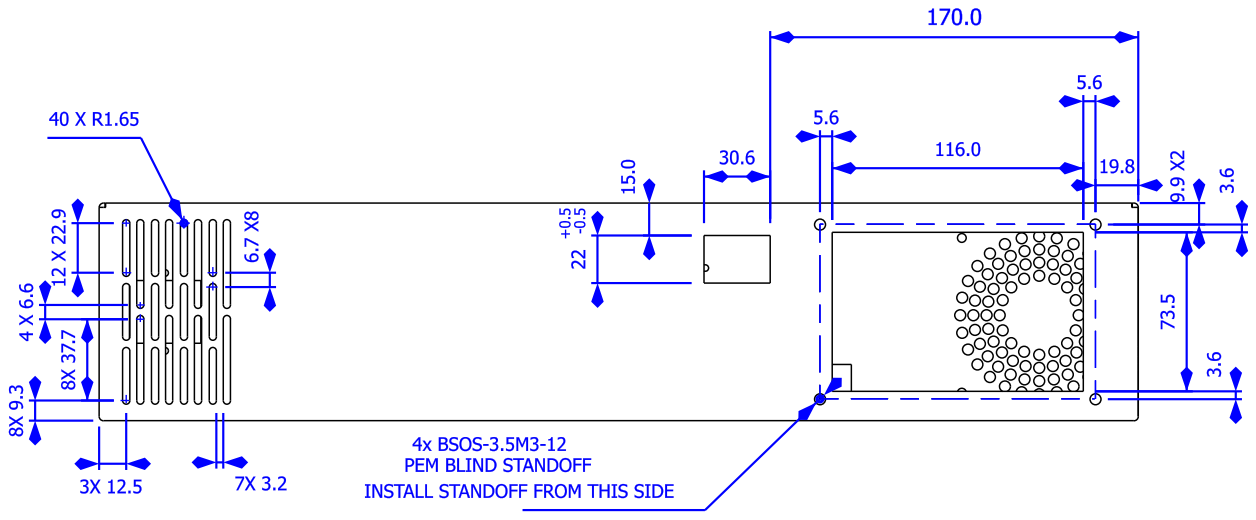
[picture p87: page 5]
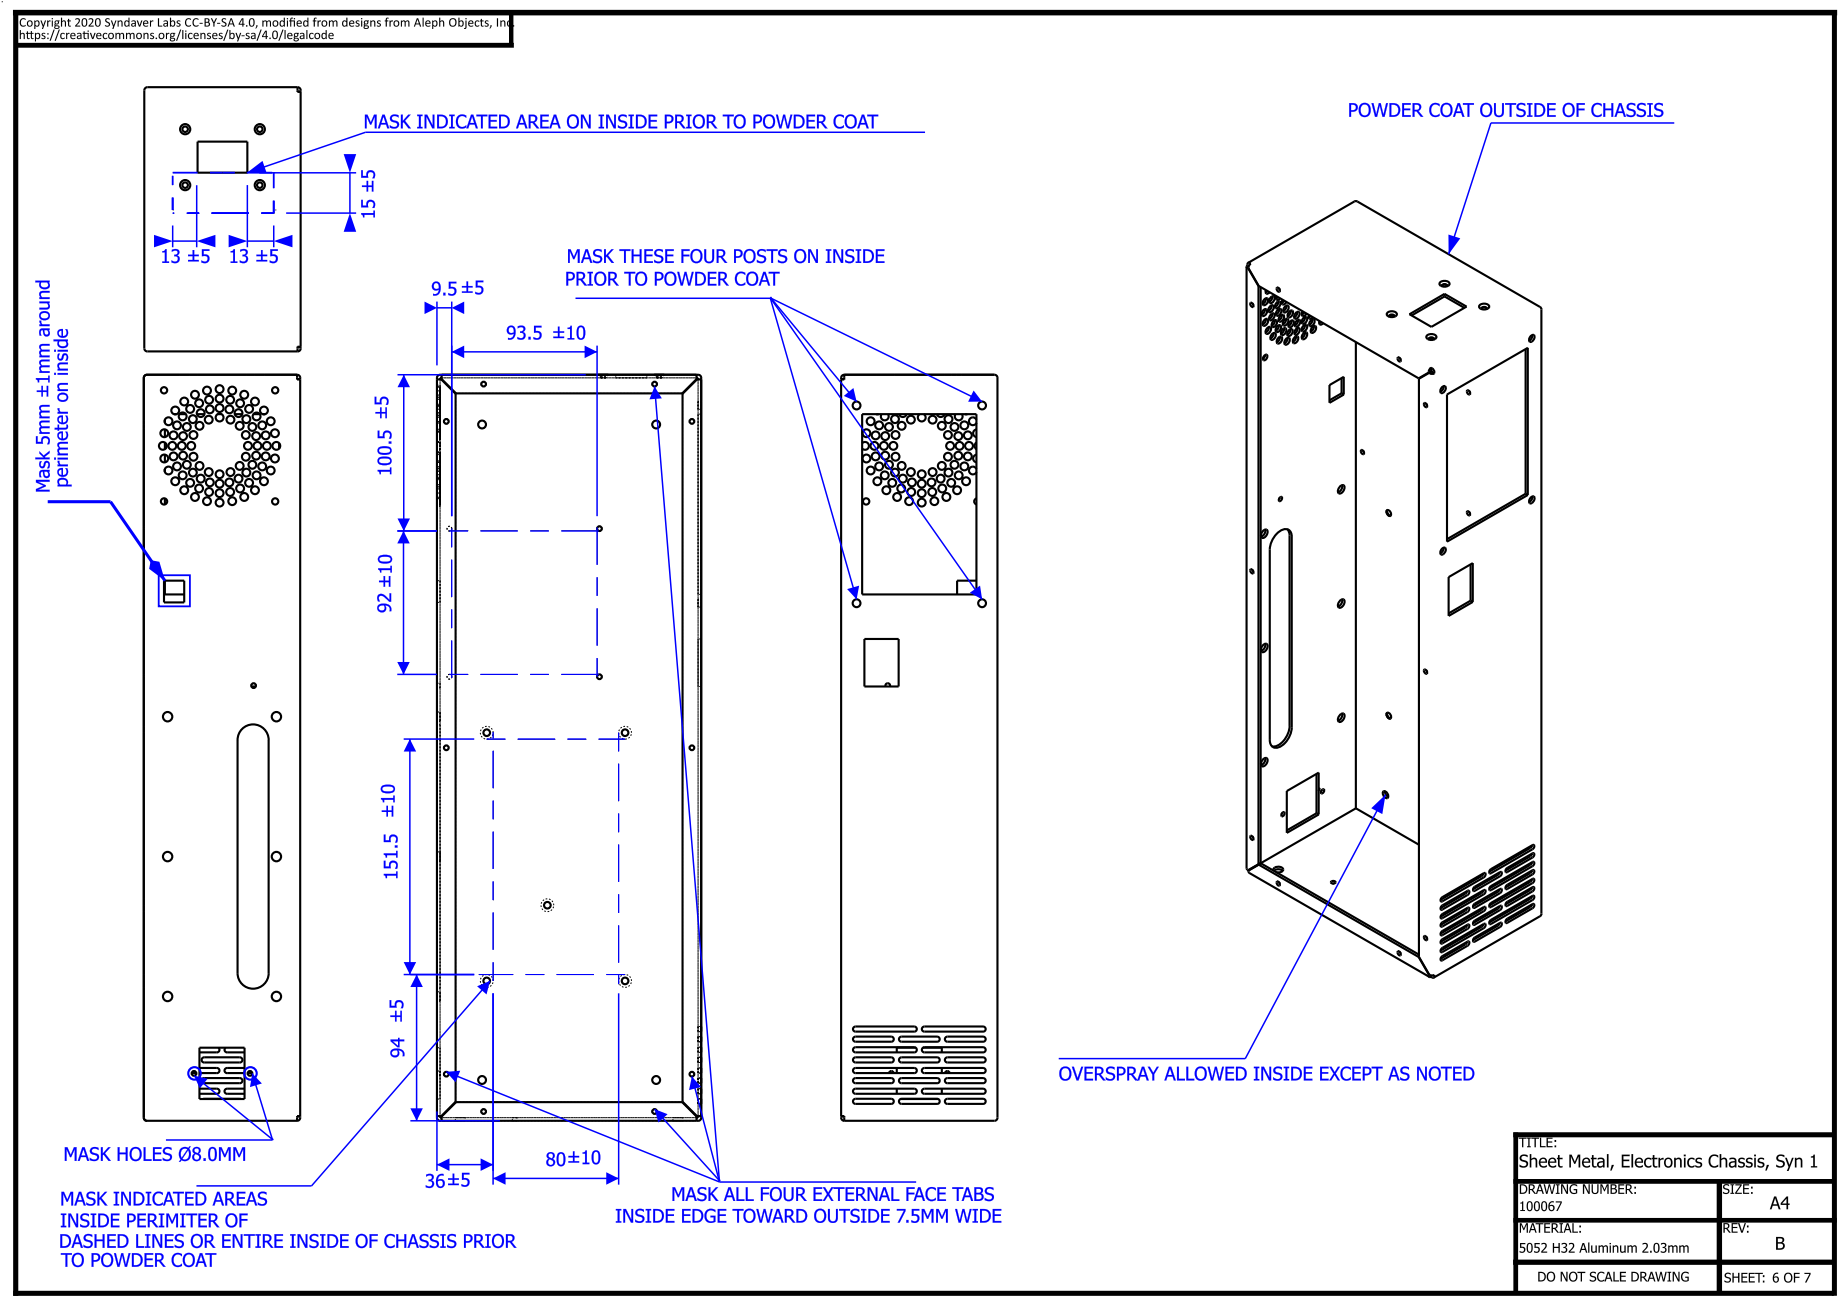
[picture p88: page 6]
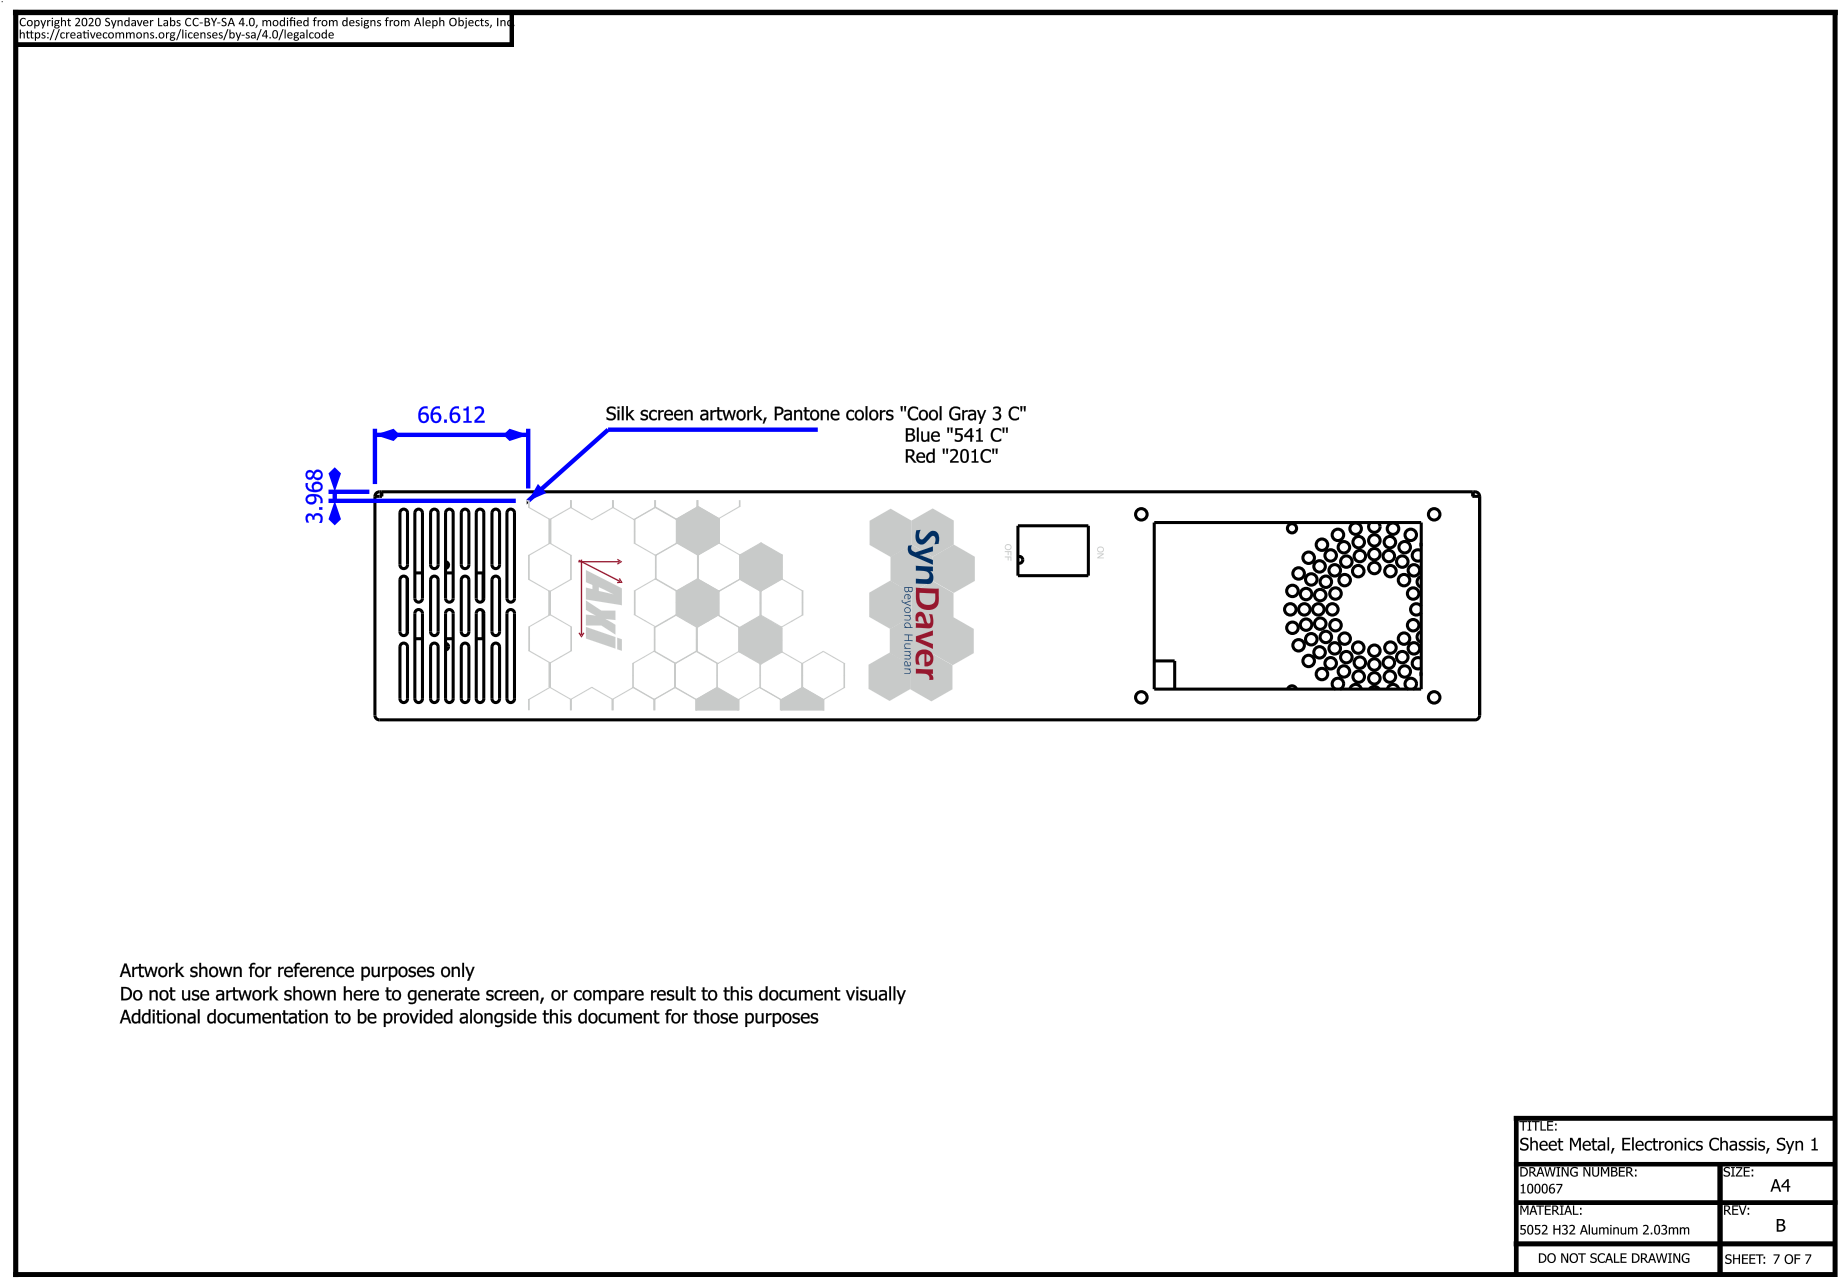
[picture p89: page 7]
