SynDaverCO/syndaver-axi/Mechanical/Sheetmetal/Sheet_Metal-Interconnect_Cover-Syn1/[100068] Sheet Metal, Interconnect Cover, Syn1 [rev A].pdf

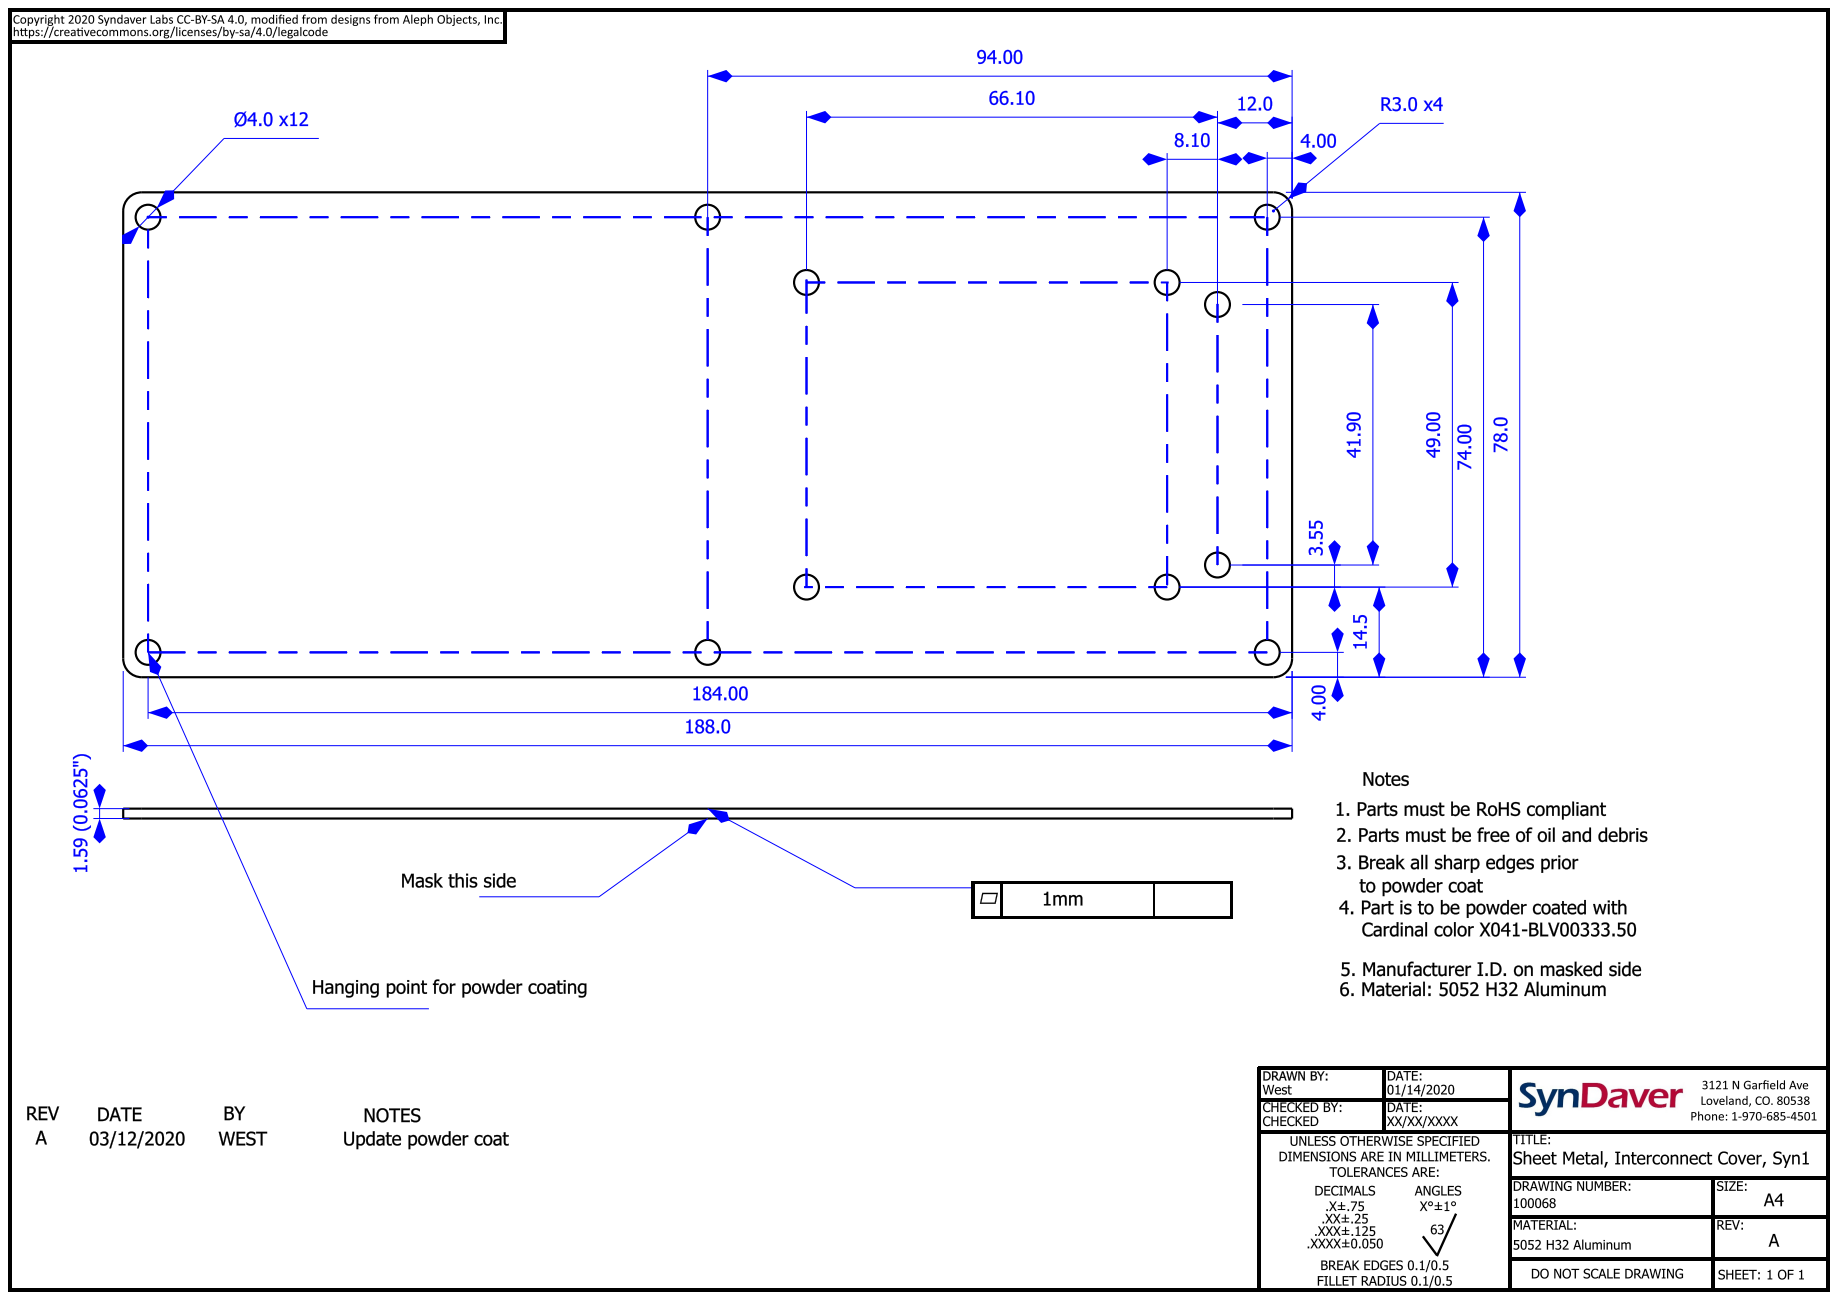
[picture p90: page 1]
