SynDaverCO/syndaver-axi/Mechanical/Sheetmetal/Sheet_Metal-Y_End_Plate-Syn1/[100070] Sheet Metal, Y End Plate, Syn1 [rev A].pdf

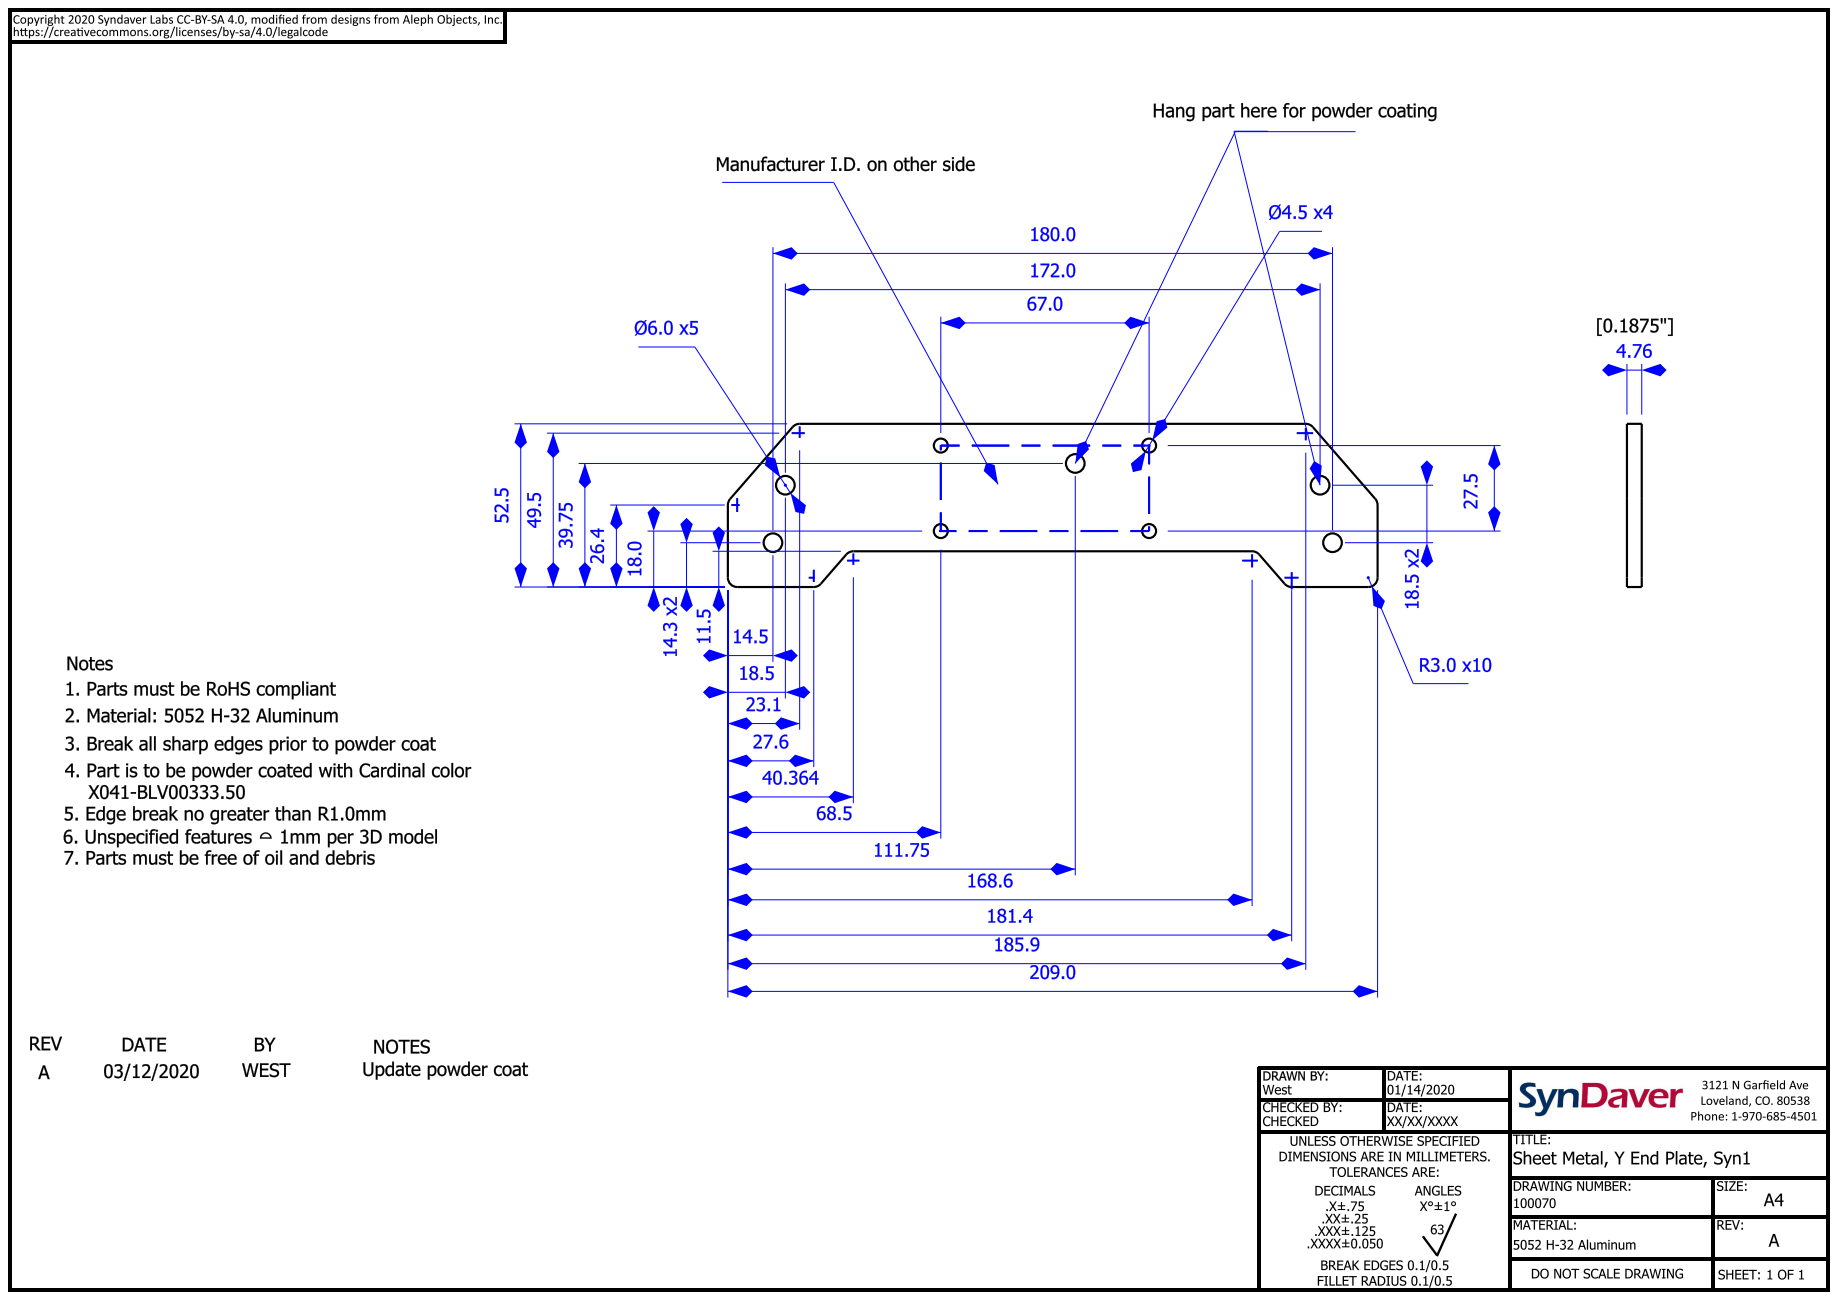
[picture p91: page 1]
