SynDaverCO/syndaver-axi/Mechanical/Sheetmetal/Sheet_Metal-Z_Top_Plate-Syn1/[100072] Sheet Metal, Z Top Plate, Syn1 [rev A].pdf

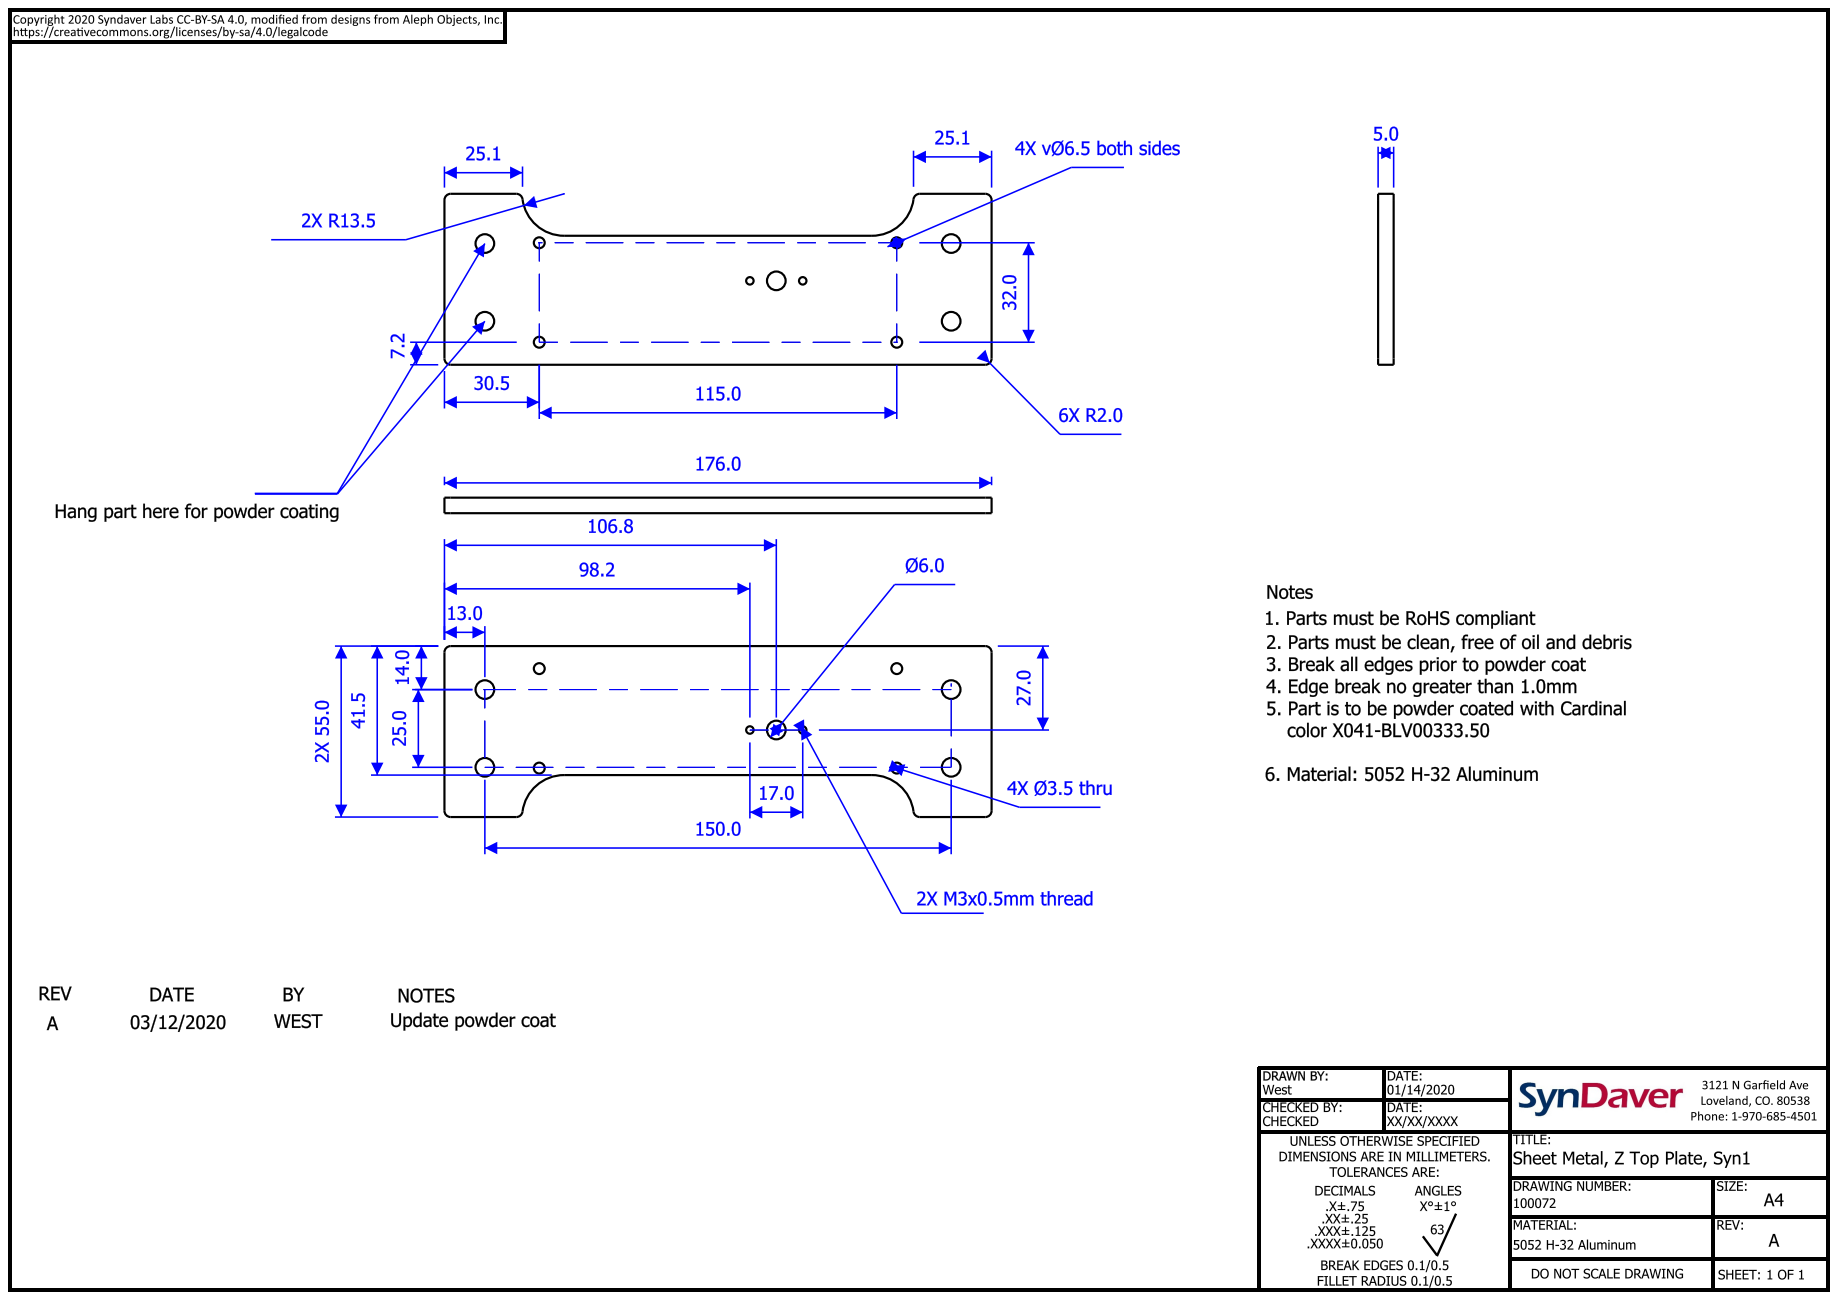
[picture p92: page 1]
