SynDaverCO/syndaver-axi/Electrical/Die_cut_contact_pads/Die_Cut-LCD_Ground_Pad-Syn1/[100069] Die Cut, LCD Ground Pad, Syn1.pdf

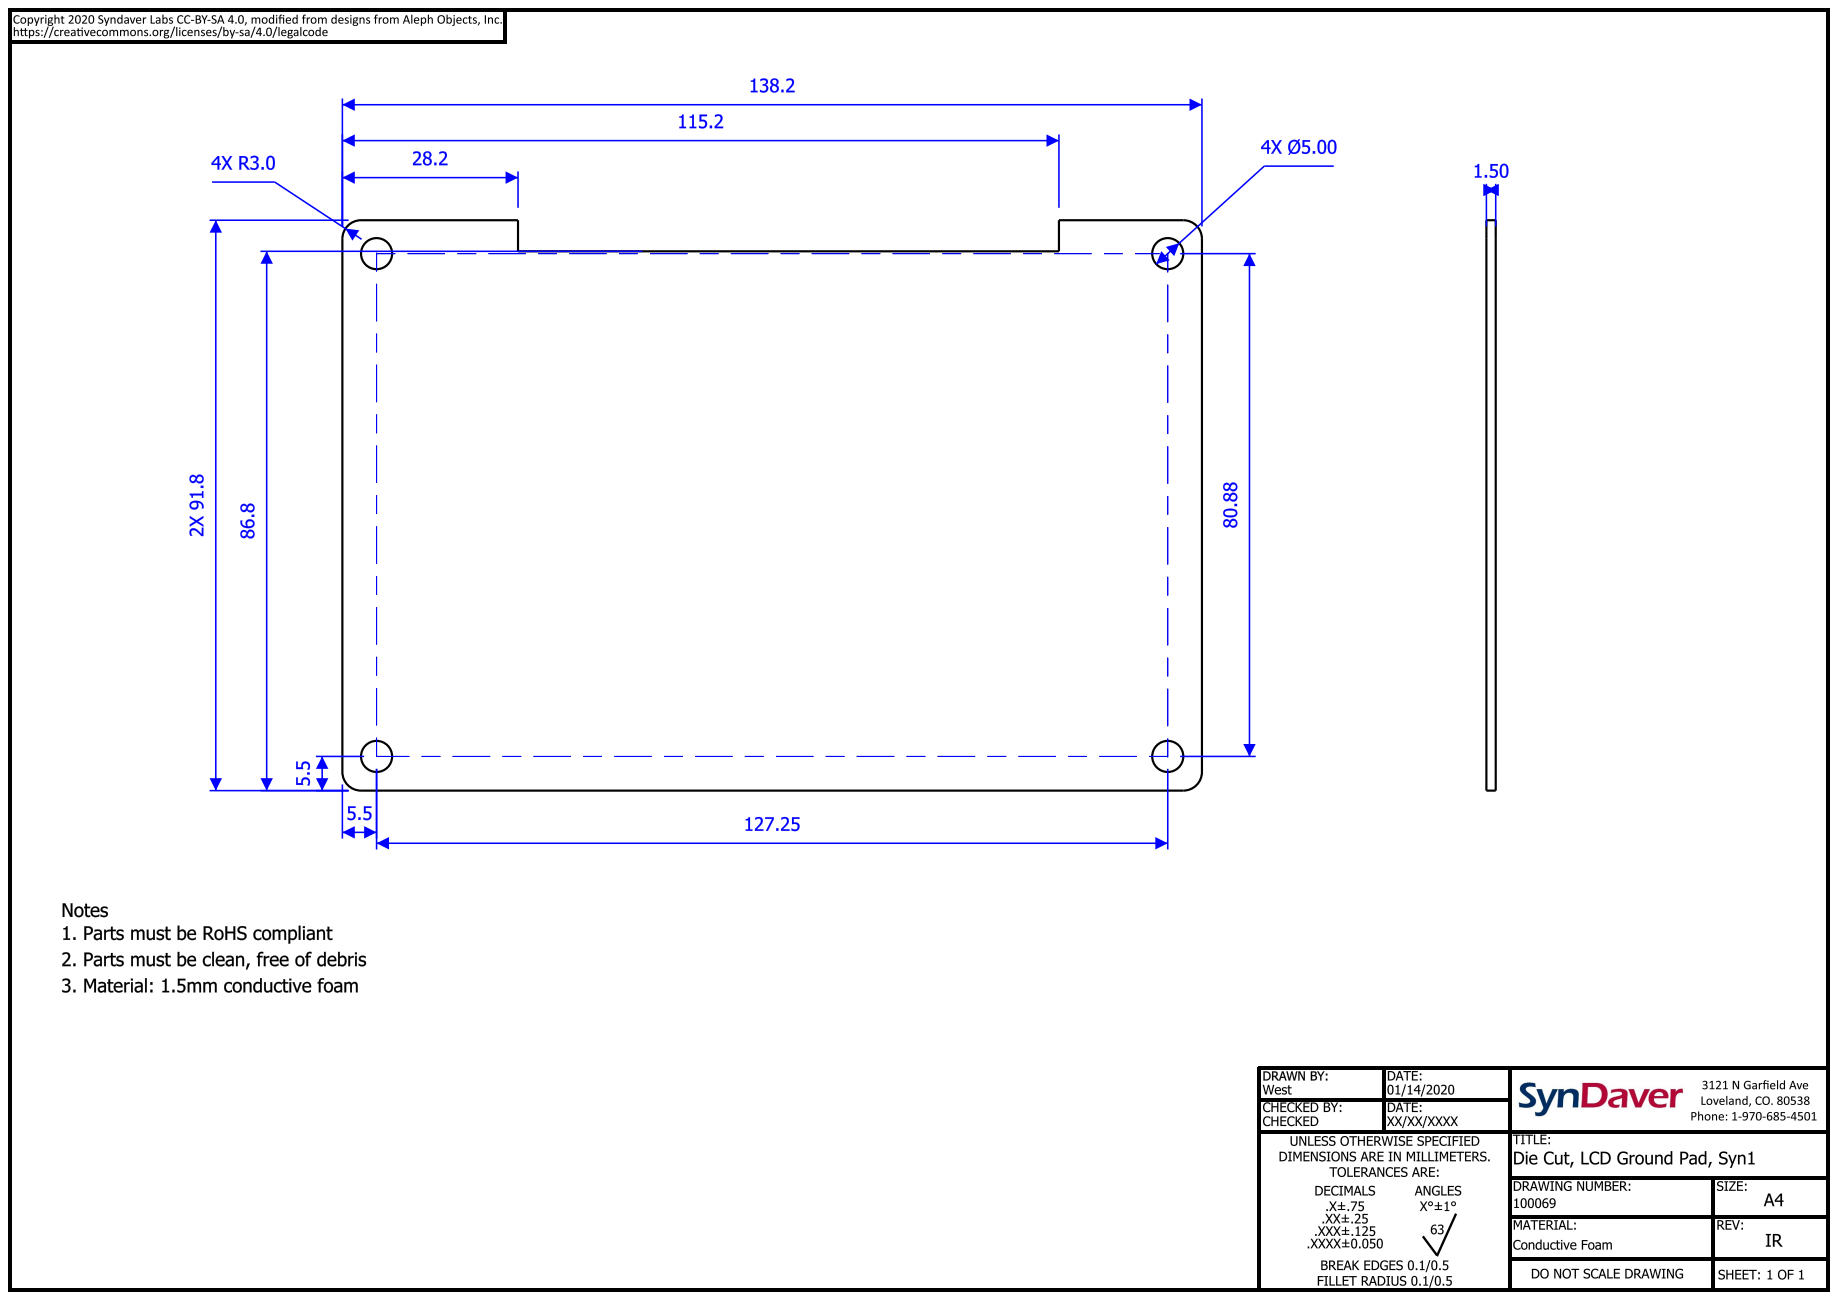
[picture p93: page 1]
