SynDaverCO/syndaver-axi/Electrical/Die_cut_contact_pads/Die_Cut-USB_ESD_Fingers-Syn1/[100073] Die Cut, USB ESD Fingers, Syn1.pdf

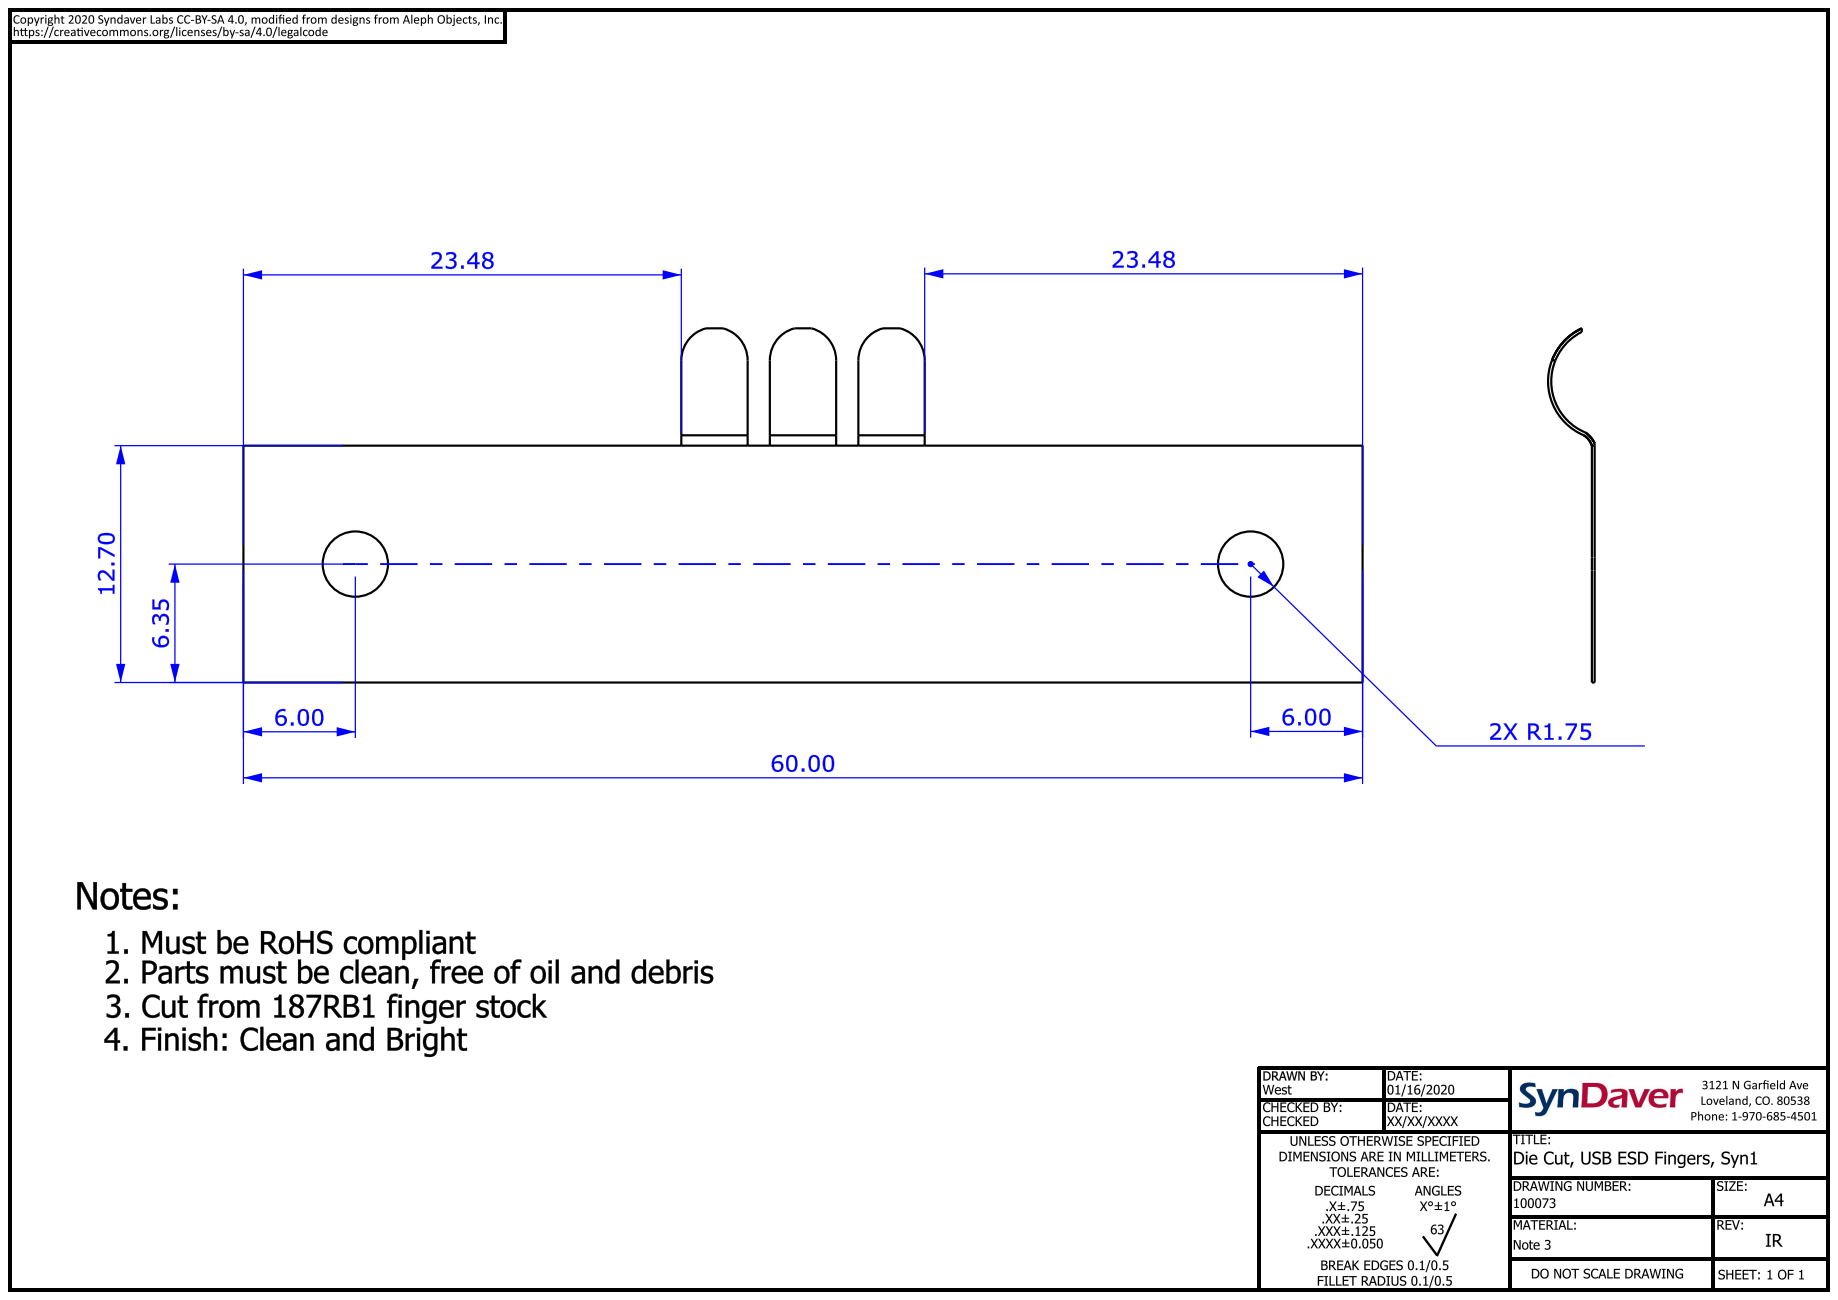
[picture p94: page 1]
