SynDaverCO/syndaver-axi/Electrical/Cable_drawings/Control_box/[100006] Harness, CB LCD-USB, Assembled, Syn1.pdf

ITEM | QTY | UNIT | SUPPLIER | SUPPLIER P/N
A | 2 | PCE | TTI | 71600-010LF

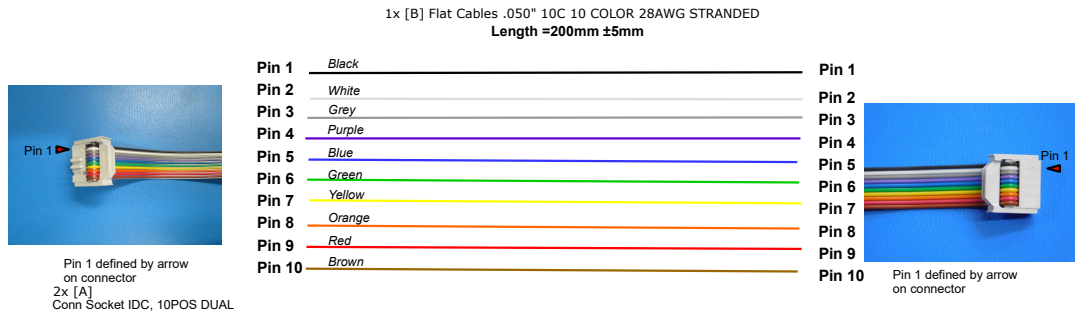
[picture p60: page 1]
Length =200mm ±5mm; Pin 1 Pin 2 Pin 3 Pin 4 Pin 5 Pin 6 Pin 7 Pin 8 Pin 9 Pin 10; Black; White Grey Purple; Blue; Green Yellow; Orange; Red Brown; Pin 1; Pin 2 Pin 3 Pin 4 Pin 5 Pin 6 Pin 7 Pin 8 Pin 9 Pin 10; on connector; Pin 1 defined by arrow

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

B | 200 | mm | TTI | 3302/10-300

1x [B] Flat Cables .050" 10C 10 COLOR 28AWG STRANDED

Pin 1 defined by arrow
Conn Socket IDC, 10POS DUAL

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

CHECKED BY: CHECKED | DATE: XX/XX/XXXX
UNLESS OTHERWISE SPECIFIED DIMENSIONS ARE IN MILLIMETERS. TOLERANCES ARE: CUT LENGTHS ±3MM STRIP LENGTHS ±.5 | | TITLE: Harness, CB LCD-USB, Assembled, Syn1

DRAWING NUMBER: 100006 | SIZE: A4
RoHS COMPLIANT | REV: IR

DO NOT SCALE DRAWING | SHEET:1 OF 1
