SynDaverCO/syndaver-axi/Electrical/Cable_drawings/Control_box/[100019] Harness, CB Z Endstop, Assembled, Syn1.pdf

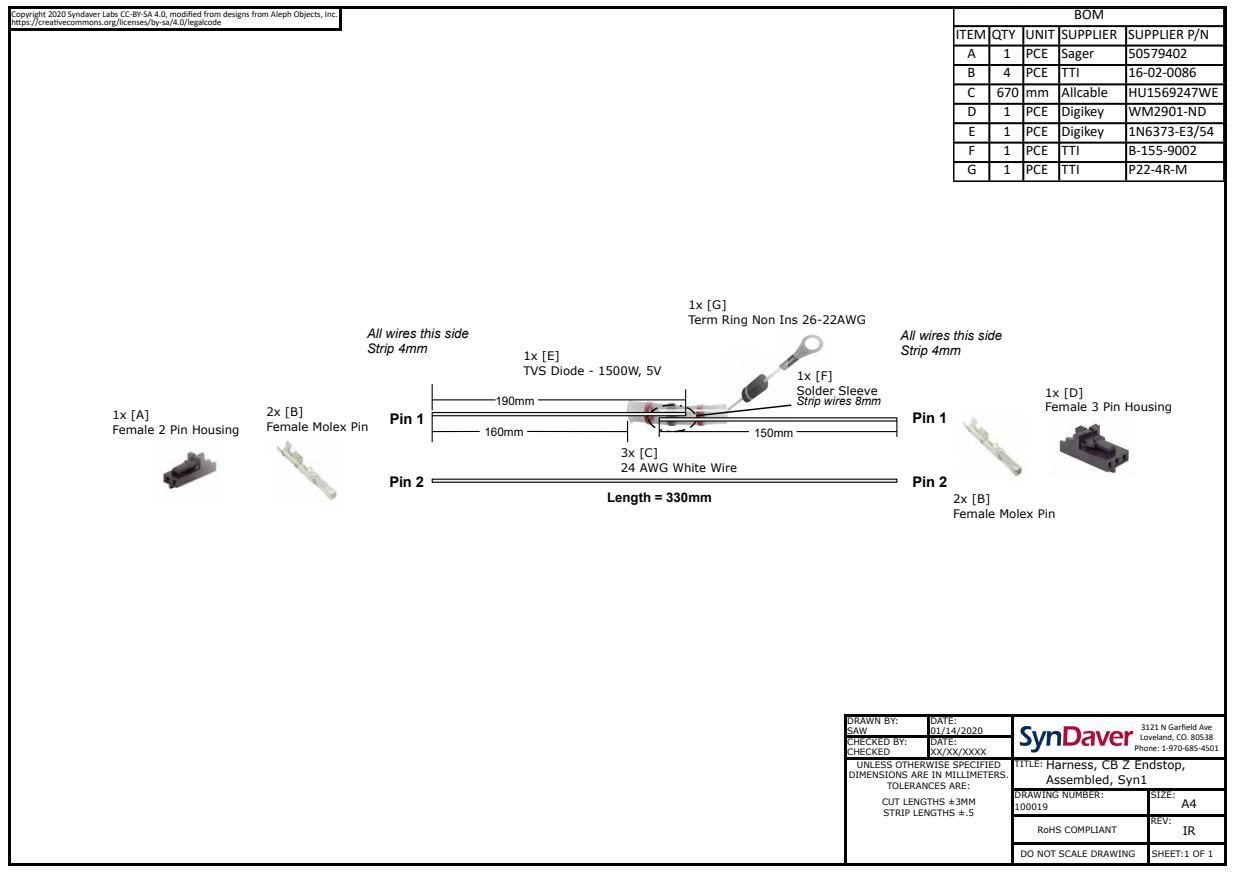
[picture p61: page 1]
Pin 2; Pin 1; Length = 330mm; Strip wires 8mm; 2x [B] Female Molex Pin; 1x [E] TVS Diode - 1500W, 5V; 1x [F] Solder Sleeve

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

ITEM | QTY | UNIT | SUPPLIER | SUPPLIER P/N
A | 1 | PCE | Sager | 50579402
B | 4 | PCE | TTI | 16-02-0086
C | 670 | mm | Allcable | HU1569247WE
D | 1 | PCE | Digikey | WM2901-ND
E | 1 | PCE | Digikey | 1N6373-E3/54
F | 1 | PCE | TTI | B-155-9002
G | 1 | PCE | TTI | P22-4R-M

Term Ring Non Ins 26-22AWG

All wires this side
Strip 4mm

Female 3 Pin Housing

Female Molex Pin

Female 2 Pin Housing

24 AWG White Wire

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

CHECKED BY: CHECKED | DATE: XX/XX/XXXX
UNLESS OTHERWISE SPECIFIED DIMENSIONS ARE IN MILLIMETERS. TOLERANCES ARE: CUT LENGTHS ±3MM STRIP LENGTHS ±.5 | | TITLE: Harness, CB Z Endstop, Assembled, Syn1

DRAWING NUMBER: 100019 | SIZE: A4
RoHS COMPLIANT | REV: IR

DO NOT SCALE DRAWING | SHEET:1 OF 1
