SynDaverCO/syndaver-axi/Electrical/Cable_drawings/Control_box/[100020] Harness, CB Bed Power, Assembled, Syn1.pdf

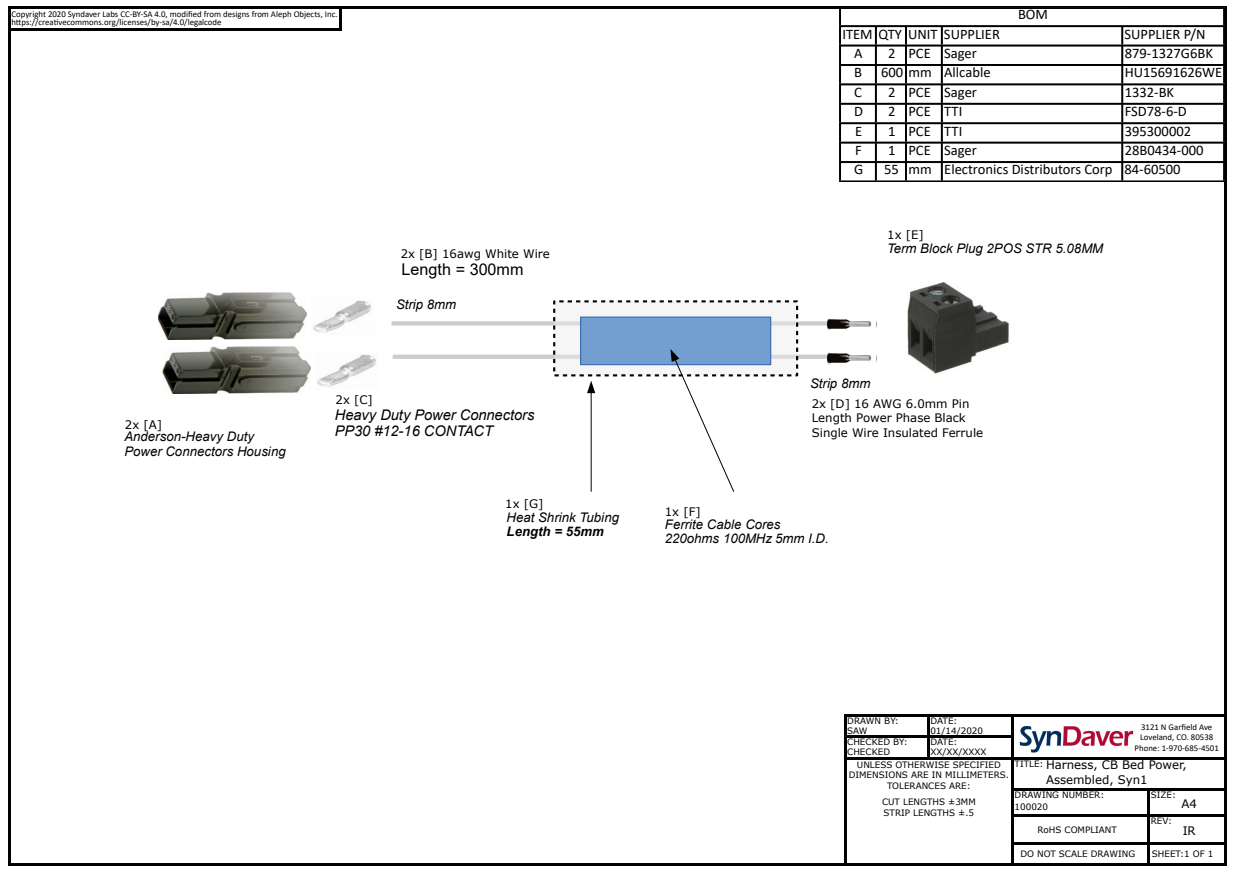
[picture p62: page 1]
Length = 300mm; Strip 8mm; Length = 55mm; Ferrite Cable Cores; 220ohms 100MHz 5mm I.D.; 2x [B] 16awg White Wire

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

ITEM | QTY | UNIT | SUPPLIER | SUPPLIER P/N
A | 2 | PCE | Sager | 879-1327G6BK
B | 600 | mm | Allcable | HU15691626WE
C | 2 | PCE | Sager | 1332-BK
D | 2 | PCE | TTI | FSD78-6-D
E | 1 | PCE | TTI | 395300002
F | 1 | PCE | Sager | 28B0434-000
G | 55 | mm | Electronics Distributors Corp | 84-60500

Term Block Plug 2POS STR 5.08MM

Strip 8mm
2x [D] 16 AWG 6.0mm Pin
Length Power Phase Black
Single Wire Insulated Ferrule

Heavy Duty Power Connectors
PP30 #12-16 CONTACT

Anderson-Heavy Duty
Power Connectors Housing

Heat Shrink Tubing

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

CHECKED BY: CHECKED | DATE: XX/XX/XXXX
UNLESS OTHERWISE SPECIFIED DIMENSIONS ARE IN MILLIMETERS. TOLERANCES ARE: CUT LENGTHS ±3MM STRIP LENGTHS ±.5 | | TITLE: Harness, CB Bed Power, Assembled, Syn1

DRAWING NUMBER: 100020 | SIZE: A4
RoHS COMPLIANT | REV: IR

DO NOT SCALE DRAWING | SHEET:1 OF 1
