SynDaverCO/syndaver-axi/Electrical/Cable_drawings/Control_box/[100021] Harness, CB Switch to PSU, Assembled, Syn1 [REV A].pdf

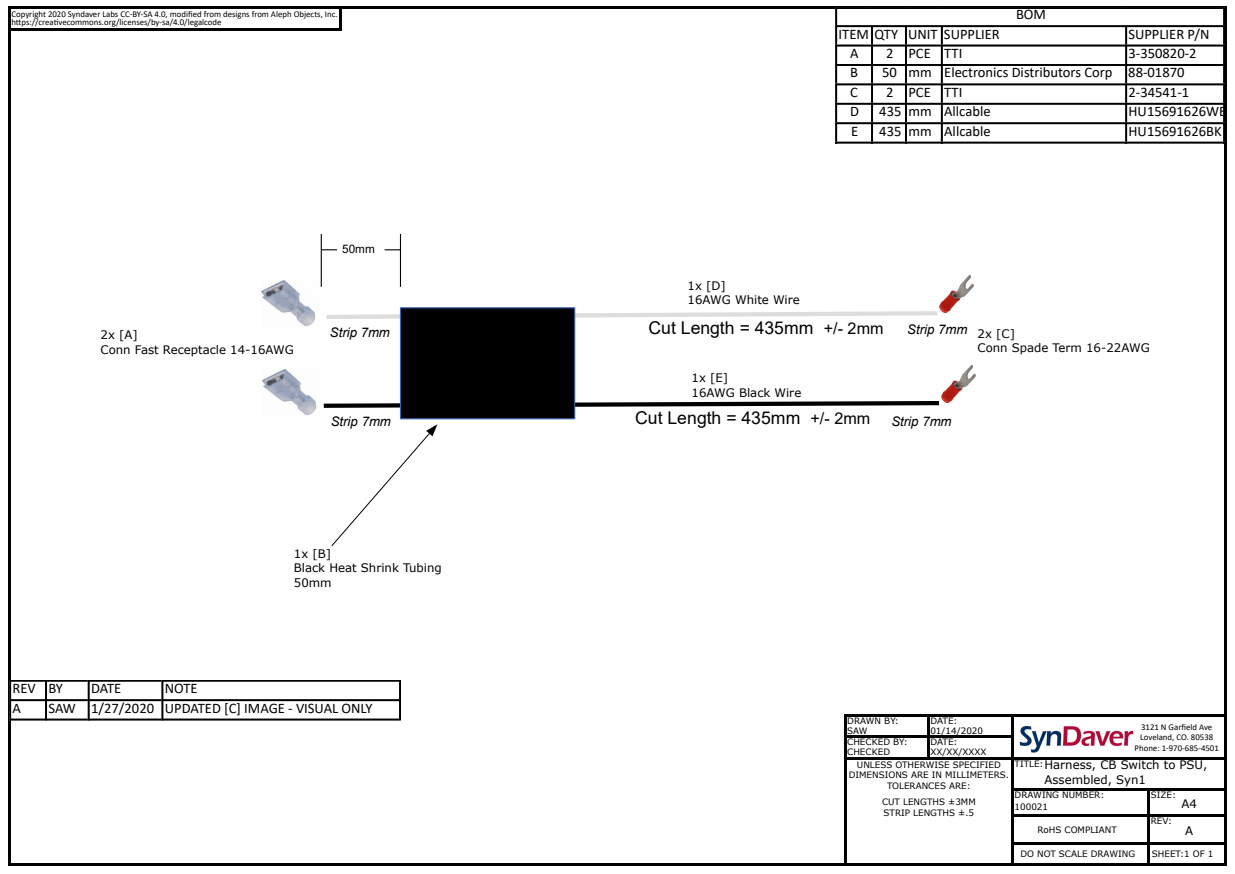
[picture p63: page 1]
Strip 7mm; Cut Length = 435mm +/- 2mm; Cut Length = 435mm +/- 2mm Strip 7mm; 1x [D] 16AWG White Wire; 1x [E] 16AWG Black Wire; 1x [B] Black Heat Shrink Tubing 50mm

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

ITEM | QTY | UNIT | SUPPLIER | SUPPLIER P/N
A | 2 | PCE | TTI | 3-350820-2
B | 50 | mm | Electronics Distributors Corp | 88-01870
C | 2 | PCE | TTI | 2-34541-1
D | 435 | mm | Allcable | HU15691626WE
E | 435 | mm | Allcable | HU15691626BK

Conn Fast Receptacle 14-16AWG

Conn Spade Term 16-22AWG

REV | BY | DATE | NOTE
A | SAW | 1/27/2020 | UPDATED [C] IMAGE - VISUAL ONLY

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

CHECKED BY: CHECKED | DATE: XX/XX/XXXX
UNLESS OTHERWISE SPECIFIED DIMENSIONS ARE IN MILLIMETERS. TOLERANCES ARE: CUT LENGTHS ±3MM STRIP LENGTHS ±.5 | | TITLE: Harness, CB Switch to PSU, Assembled, Syn1

DRAWING NUMBER: 100021 | SIZE: A4
RoHS COMPLIANT | REV: A

DO NOT SCALE DRAWING | SHEET:1 OF 1
