SynDaverCO/syndaver-axi/Mechanical/Sheetmetal/Sheet_Metal-Chassis_Cover-Syn1/[100080] Sheet Metal, Chassis Cover, Syn1 [REV A].pdf

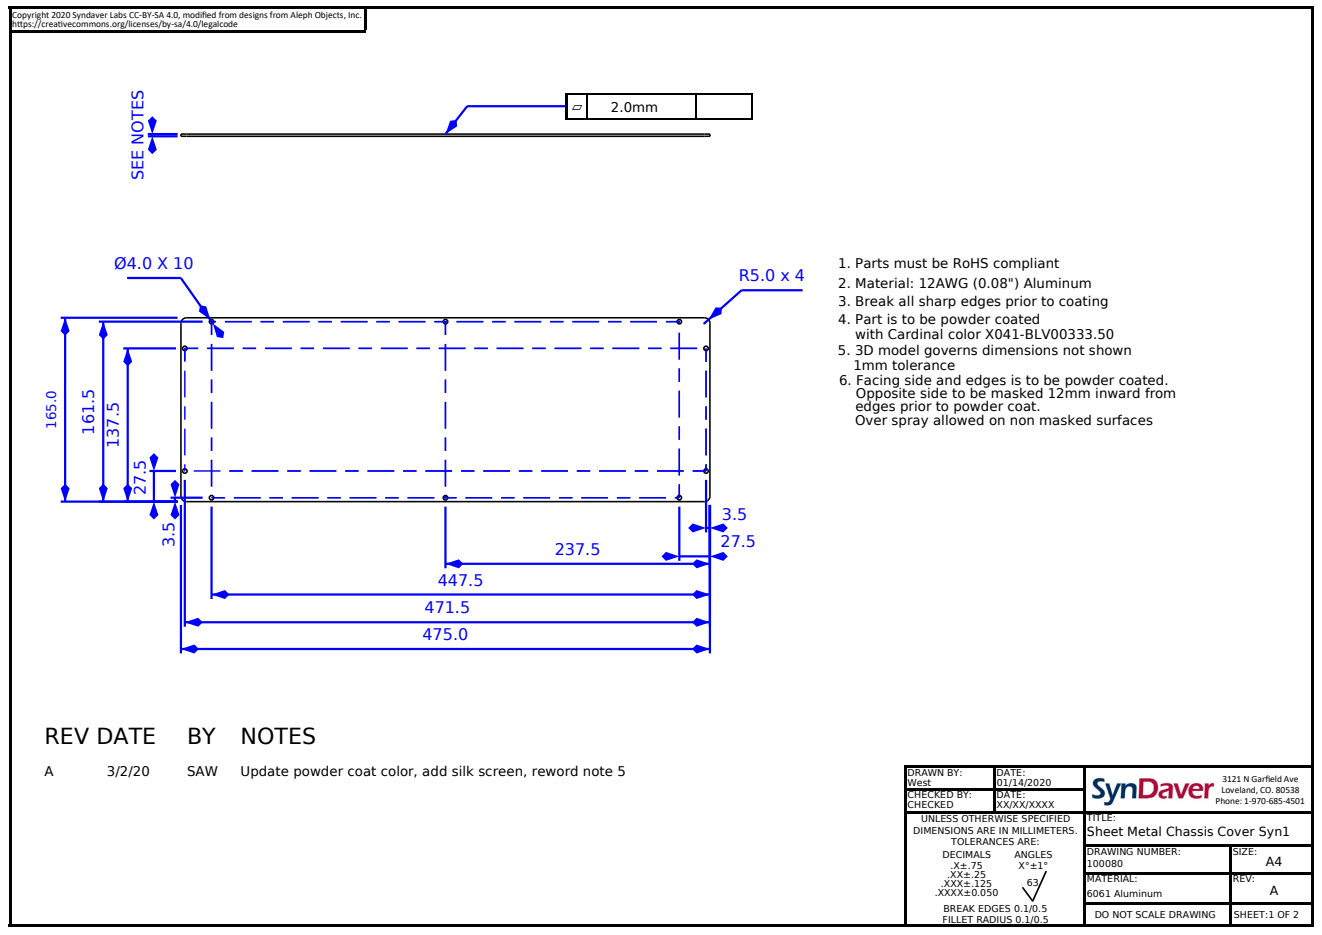
[picture p68: page 1]
SAW; Update powder coat color, add silk screen, reword note 5

Copyright 2020 Syndaver Labs CC-BY-SA 4.0, modified from designs from Aleph Objects, Inc.
https://creativecommons.org/licenses/by-sa/4.0/legalcode

1. Parts must be RoHS compliant
2. Material: 12AWG (0.08") Aluminum
3. Break all sharp edges prior to coating
4. Part is to be powder coated
with Cardinal color X041-BLV00333.50
5. 3D model governs dimensions not shown
1mm tolerance
6. Facing side and edges is to be powder coated.
Opposite side to be masked 12mm inward from
edges prior to powder coat.
Over spray allowed on non masked surfaces

REV DATE BY NOTES

DRAWN BY: West | DATE: 01/14/2020 | 3121 N Garfield Ave Loveland, CO. 80538 Phone: 1-970-685-4501

CHECKED BY: CHECKED | DATE: XX/XX/XXXX
UNLESS OTHERWISE SPECIFIED DIMENSIONS ARE IN MILLIMETERS. TOLERANCES ARE: DECIMALS ANGLES .X±.75 X°±1° .XX±.25 .XXX±.125 .XXXX±0.050 BREAK EDGES 0.1/0.5 FILLET RADIUS 0.1/0.5 | | TITLE: Sheet Metal Chassis Cover Syn1 MATERIAL: 63

DRAWING NUMBER: 100080 | SIZE: A4

6061 Aluminum | REV: A

DO NOT SCALE DRAWING | SHEET:

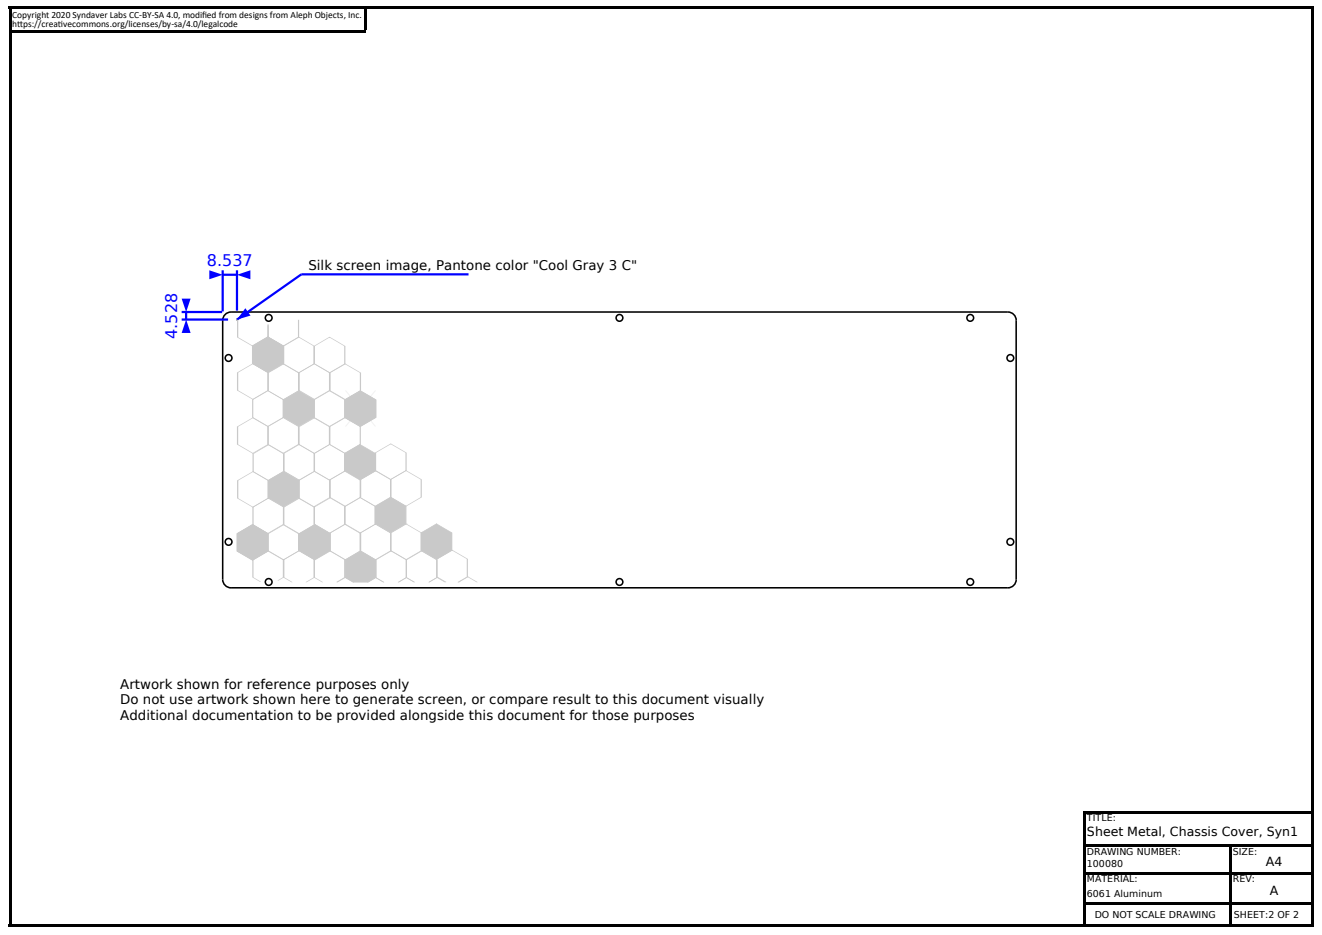
[picture p69: page 2]
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

Silk screen image, Pantone color "Cool Gray 3 C"

Artwork shown for reference purposes only
Do not use artwork shown here to generate screen, or compare result to this document visually
Additional documentation to be provided alongside this document for those purposes

TITLE:
Sheet Metal, Chassis Cover, Syn1

DRAWING NUMBER: 100080 | SIZE: A4

MATERIAL: 6061 Aluminum | REV: A

DO NOT SCALE DRAWING | SHEET:
