SynDaverCO/syndaver-axi/Electrical/Cable_drawings/Control_box/[100009] Harness, CB X, Syn1 [rev A].pdf

`

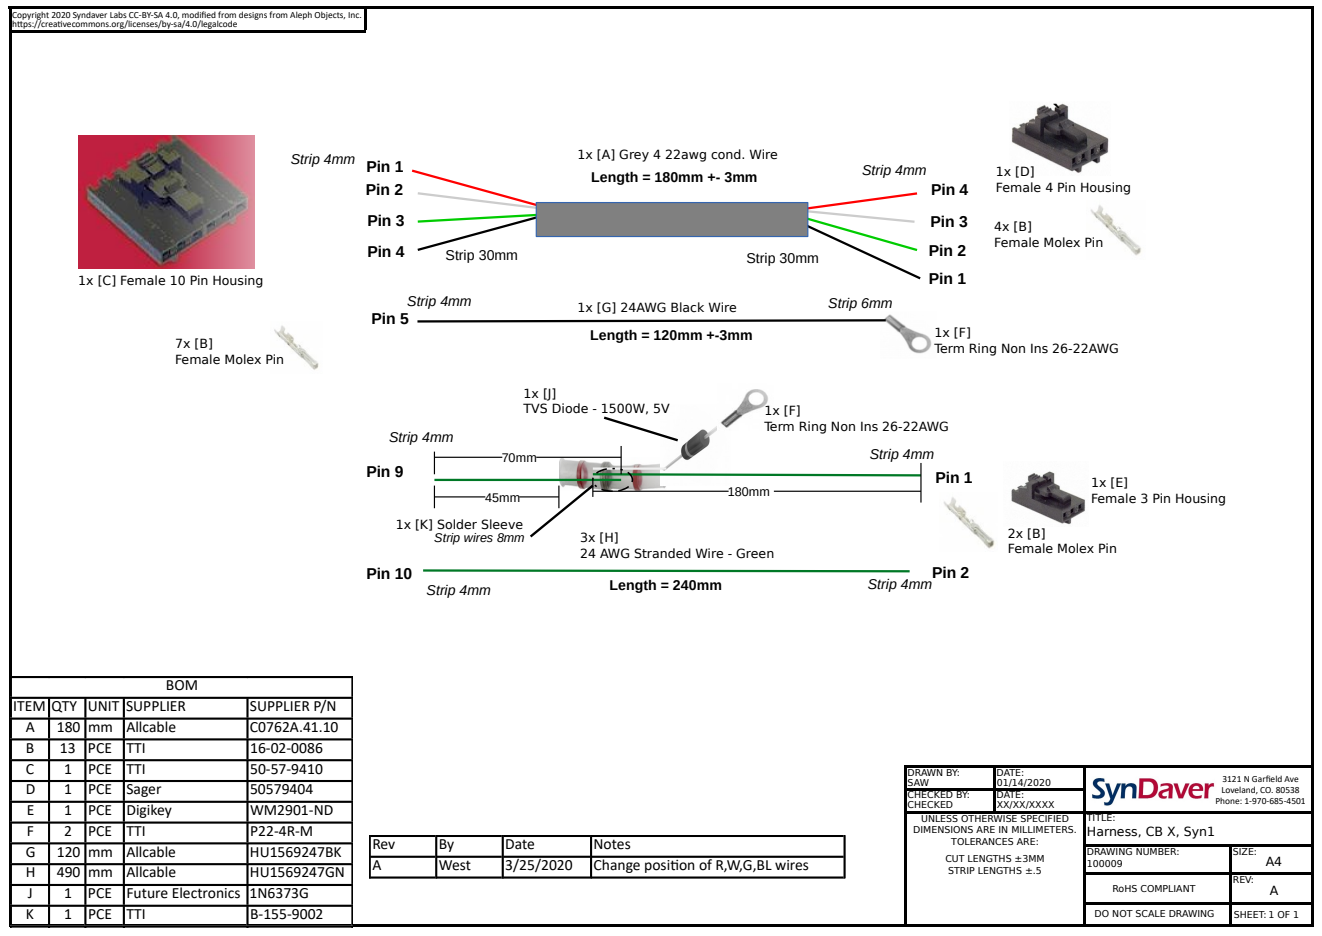
[picture p70: page 1]
SHEET: 1 OF 1; DRAWING NUMBER:; SIZE:; Allcable; PCE; TTI; BOM; Pin 1 Pin 2; Pin 3; Pin 4; Strip 4mm; Pin 9; Pin 10; Pin 2; Pin 1; Strip 30mm; Length = 120mm +-3mm; Pin 5; Length = 240mm; Strip 6mm; Strip wires 8mm; TVS Diode - 1500W, 5V; 1x [K] Solder Sleeve; 1x [G] 24AWG Black Wire

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

1x [A] Grey 4 22awg cond. Wire
Length = 180mm +- 3mm

Female 4 Pin Housing

Female Molex Pin

1x [C] Female 10 Pin Housing

Term Ring Non Ins 26-22AWG

Female 3 Pin Housing

24 AWG Stranded Wire - Green

ITEM | QTY | UNIT | SUPPLIER | SUPPLIER P/N
A | 180 | mm | Allcable | C0762A.41.10
B | 13 | PCE | TTI | 16-02-0086
C | 1 | PCE | TTI | 50-57-9410
D | 1 | PCE | Sager | 50579404
E | 1 | PCE | Digikey | WM2901-ND
F | 2 | PCE | TTI | P22-4R-M

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

CHECKED BY: CHECKED | DATE: XX/XX/XXXX
UNLESS OTHERWISE SPECIFIED DIMENSIONS ARE IN MILLIMETERS. TOLERANCES ARE: CUT LENGTHS ±3MM STRIP LENGTHS ±.5 | | TITLE: Harness, CB X, Syn1

Rev | By | Date | Notes
A | West | 3/25/2020 | Change posion of R,W,G,BL wires

H | 490 | mm | Allcable | HU1569247GN
J | 1 | PCE | Future Electronics | 1N6373G

RoHS COMPLIANT | REV: A

DO NOT SCALE DRAWING
