SynDaverCO/syndaver-axi/Electrical/Cable_drawings/Control_box/[100011] Harness, CB Extruder, Syn1 [rev C].pdf

`

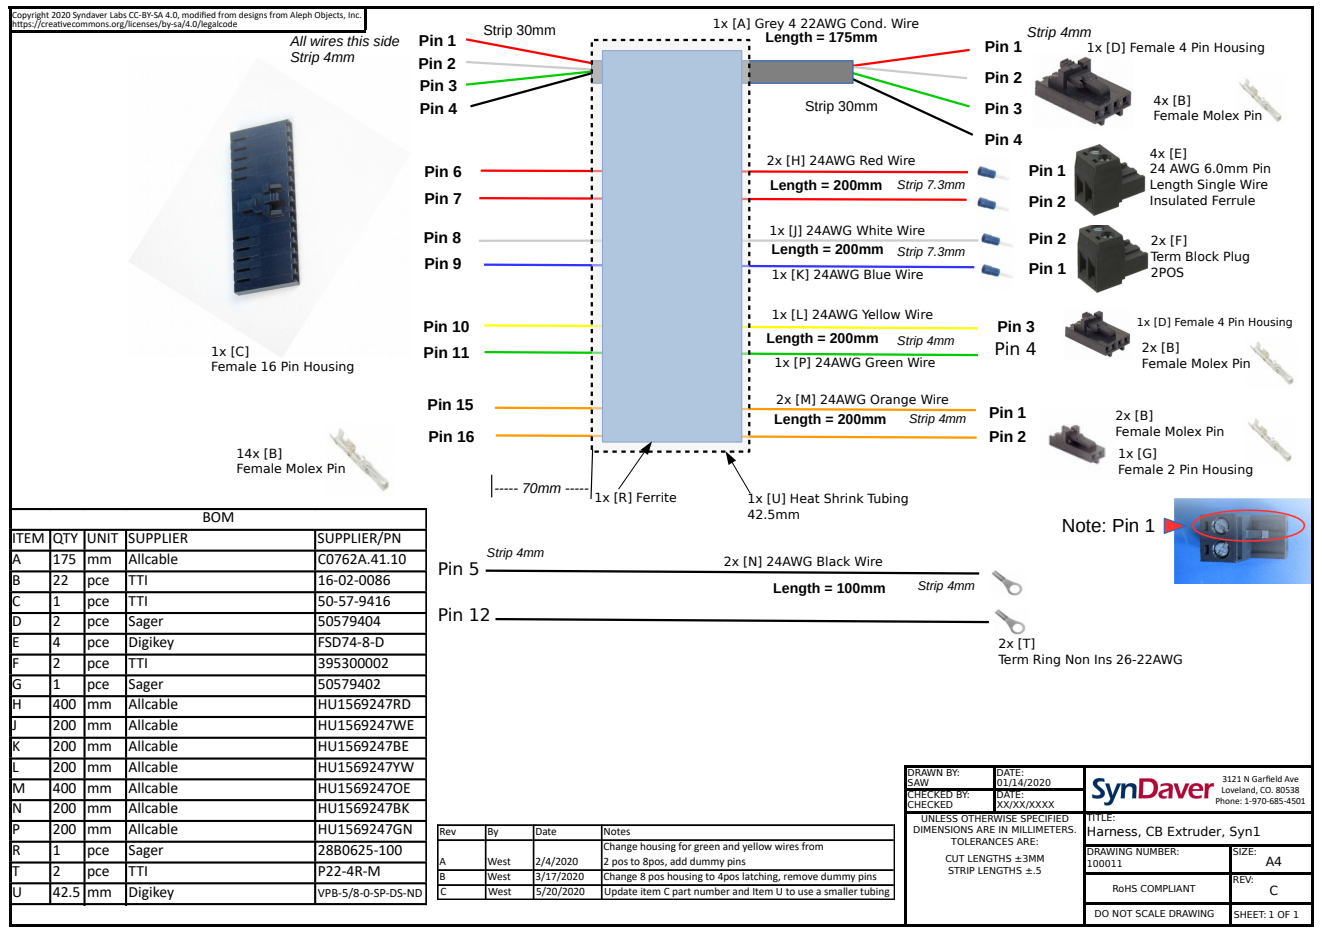
[picture p71: page 1]
SHEET: 1 OF 1; REV:; RoHS COMPLIANT; Pin 10; Pin 3; Length = 200mm; Pin 6; Length = 200mm Strip 7.3mm; Pin 9; Pin 15; Pin 16; Pin 2; Strip 4mm; Pin 1; Pin 1 Pin 2 Pin 3 Pin 4; Strip 30mm; Pin 7; Pin 8; Pin 11; Length = 100mm; Length = 175mm; Pin 4; Note: Pin 1; 2x [H] 24AWG Red Wire; 1x [J] 24AWG White Wire; 1x [K] 24AWG Blue Wire; 1x [L] 24AWG Yellow Wire; 1x [P] 24AWG Green Wire; 2x [M] 24AWG Orange Wire; 2x [N] 24AWG Black Wire; 2x [F] Term Block Plug 2POS; 1x [R] Ferrite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

1x [A] Grey 4 22AWG Cond. Wire

All wires this side
Strip 4mm

1x [D] Female 4 Pin Housing

Female Molex Pin

24 AWG 6.0mm Pin
Length Single Wire
Insulated Ferrule

Female 16 Pin Housing

Female 2 Pin Housing

ITEM | QTY | UNIT | SUPPLIER | SUPPLIER/PN
A | 175 | mm | Allcable | C0762A.41.10
B | 22 | pce | TTI | 16-02-0086
C | 1 | pce | TTI | 50-57-9416
D | 2 | pce | Sager | 50579404
E | 4 | pce | Digikey | FSD74-8-D
F | 2 | pce | TTI | 395300002
G | 1 | pce | Sager | 50579402
H | 400 | mm | Allcable | HU1569247RD
J | 200 | mm | Allcable | HU1569247WE
K | 200 | mm | Allcable | HU1569247BE
L | 200 | mm | Allcable | HU1569247YW
M | 400 | mm | Allcable | HU1569247OE
N | 200 | mm | Allcable | HU1569247BK
P | 200 | mm | Allcable | HU1569247GN

Term Ring Non Ins 26-22AWG

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

CHECKED BY: CHECKED | DATE: XX/XX/XXXX
UNLESS OTHERWISE SPECIFIED DIMENSIONS ARE IN MILLIMETERS. TOLERANCES ARE: CUT LENGTHS ±3MM STRIP LENGTHS ±.5 | | TITLE: Harness, CB Extruder, Syn1

Rev | By | Date | Notes

Change housing for green and yellow wires from
2 pos to 8pos, add dummy pins

DRAWING NUMBER: 100011 | SIZE: A4

DO NOT SCALE DRAWING
