SynDaverCO/syndaver-axi/Electrical/Cable_drawings/Control_box/[100012] Harness, CB Y End-Stop, Syn1.pdf

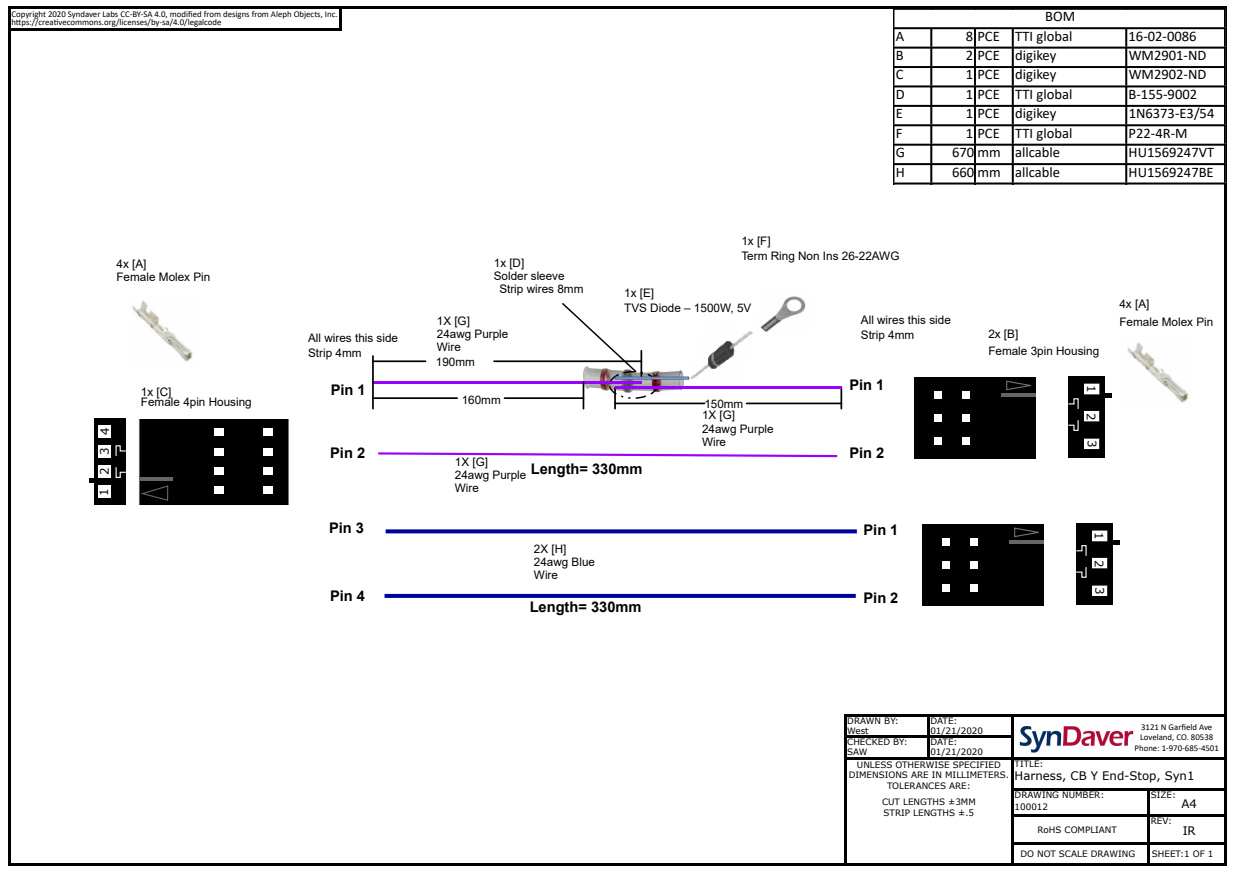
[picture p72: page 1]
Pin 2; Pin 1; Strip 4mm; Female 3pin Housing; Length= 330mm; 1x [C] Female 4pin Housing; 1x [E] TVS Diode – 1500W, 5V; Strip wires 8mm; 2X [H] 24awg Blue Wire; 1x [D] Solder sleeve; Pin 3; Pin 4; 1X [G] 24awg Purple Wire

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

A | 8 PCE | | TTI global | 16-02-0086
B | 2 PCE | | digikey | WM2901-ND
C | 1 PCE | | digikey | WM2902-ND
D | 1 PCE | | TTI global | B-155-9002
E | 1 PCE | | digikey | 1N6373-E3/54
F | 1 PCE | | TTI global | P22-4R-M
G | 670 mm | | allcable | HU1569247VT
H | 660 mm | | allcable | HU1569247BE

Term Ring Non Ins 26-22AWG

Female Molex Pin

All wires this side

Strip 4mm

DRAWN BY: West | DATE: 01/21/2020 | 3121 N Garfield Ave Loveland, CO. 80538 Phone: 1-970-685-4501

CHECKED BY: SAW | DATE: 01/21/2020
UNLESS OTHERWISE SPECIFIED DIMENSIONS ARE IN MILLIMETERS. TOLERANCES ARE: CUT LENGTHS ±3MM STRIP LENGTHS ±.5 | | TITLE: Harness, CB Y End-Stop, Syn1

DRAWING NUMBER: 100012 | SIZE: A4
RoHS COMPLIANT | REV: IR

DO NOT SCALE DRAWING | SHEET:1 OF 1
