SynDaverCO/syndaver-axi/Electrical/Cable_drawings/Control_box/[100018] Harness, CB Bed, Syn1 [rev C].pdf

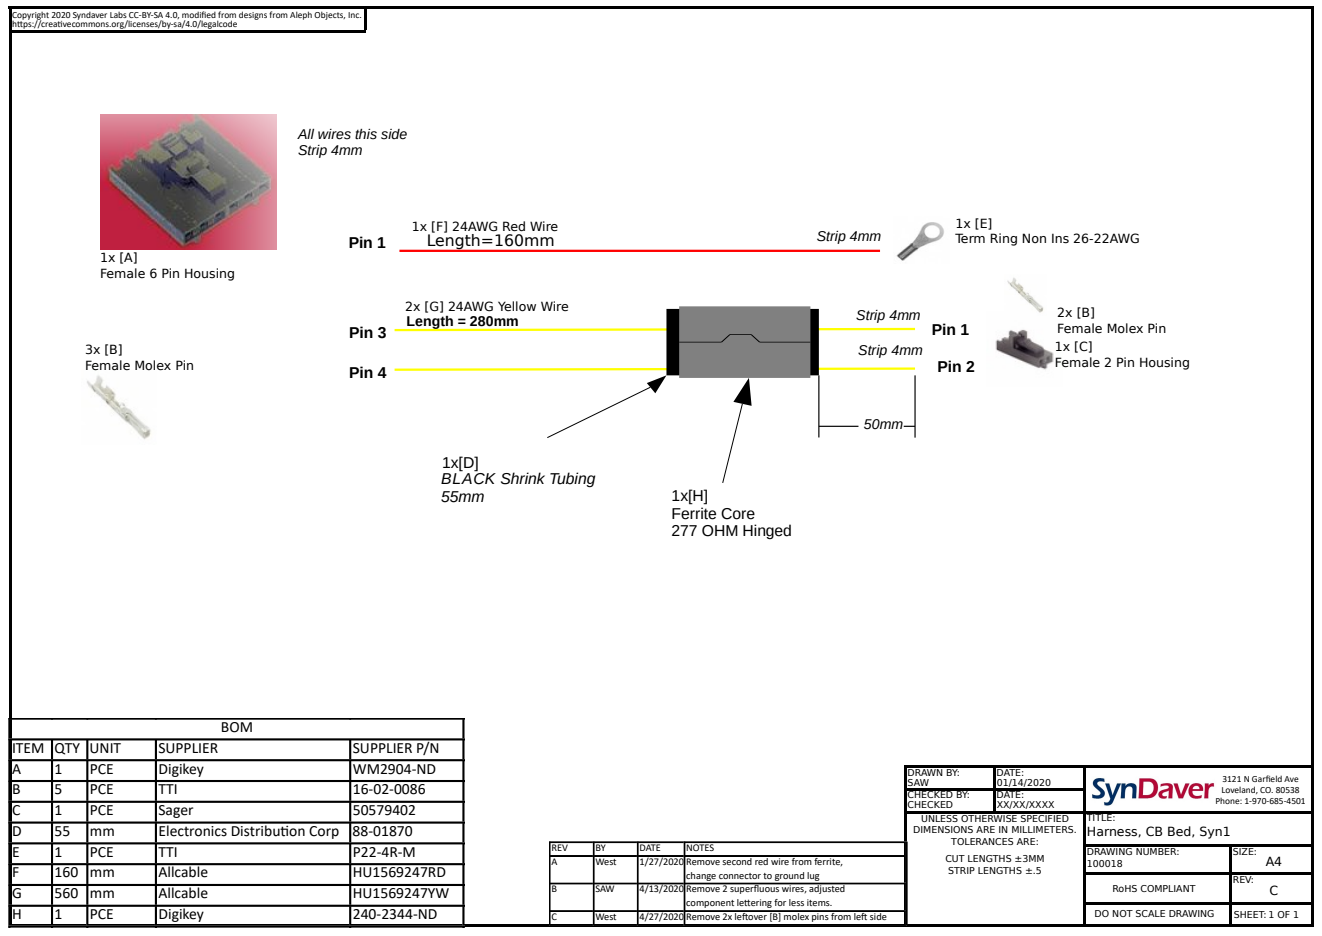
[picture p73: page 1]
SHEET: 1 OF 1; REV:; DRAWING NUMBER:; SIZE:; RoHS COMPLIANT; Pin 3; Pin 4; Pin 2; Pin 1 Length = 280mm; Pin 1; Strip 4mm; 1x[H] Ferrite Core 277 OHM Hinged; BLACK Shrink Tubing 55mm; 2x [G] 24AWG Yellow Wire; 1x [F] 24AWG Red Wire Length=160mm; PCE; TTI; Allcable; Digikey; BOM; REV; DATE; NOTES; SAW; 4/13/2020 Remove 2 superfluous wires, adjusted; West; 4/27/2020 Remove 2x leover [B] molex pins from le side

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

All wires this side
Strip 4mm

Term Ring Non Ins 26-22AWG

Female 6 Pin Housing

Female Molex Pin
Female 2 Pin Housing

ITEM | QTY | UNIT | SUPPLIER | SUPPLIER P/N
A | 1 | PCE | Digikey | WM2904-ND
B | 5 | PCE | TTI | 16-02-0086
C | 1 | PCE | Sager | 50579402
D | 55 | mm | Electronics Distribuon Corp | 88-01870

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

CHECKED BY: CHECKED | DATE: XX/XX/XXXX
UNLESS OTHERWISE SPECIFIED DIMENSIONS ARE IN MILLIMETERS. TOLERANCES ARE: CUT LENGTHS ±3MM STRIP LENGTHS ±.5 | | TITLE: Harness, CB Bed, Syn1

A | West | 1/27/2020 Remove second red wire from ferrite, | change connector to ground lug

F | 160 | mm | Allcable | HU1569247RD

component leering for less items.

DO NOT SCALE DRAWING
