SynDaverCO/syndaver-axi/Electrical/Cable_drawings/Control_box/[100022] Harness, CB Plug to Switch, black and white w ferrite, Syn1.pdf

ITEM | QTY | UNIT | SUPPLIER | SUPPLIER P/N
A | 4 | PCE | TTI | 3-350820-2

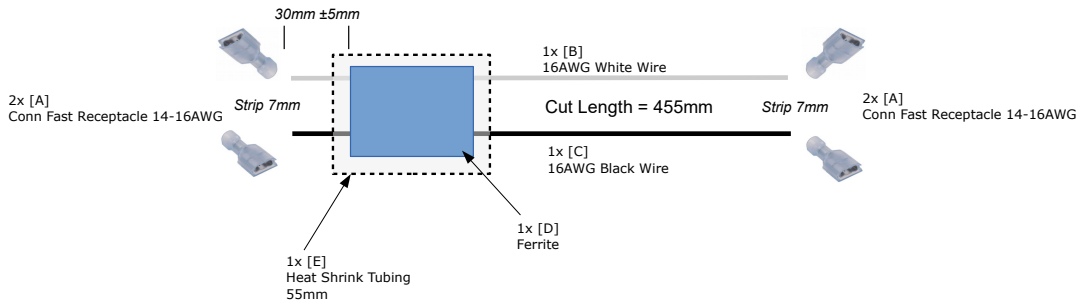
[picture p74: page 1]
Strip 7mm; Cut Length = 455mm; 1x [B] 16AWG White Wire; 1x [D] Ferrite; 1x [E] Heat Shrink Tubing 55mm; 1x [C] 16AWG Black Wire

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

B | 455 | mm | Allcable | HU15691626WE
C | 455 | mm | Allcable | HU15691626BK
D | 1 | PCE | Sager | 28B0434-000
E | 55 | mm | Electronics Distributors Corp | 84-60500

Conn Fast Receptacle 14-16AWG

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

CHECKED BY: CHECKED | DATE: XX/XX/XXXX
UNLESS OTHERWISE SPECIFIED DIMENSIONS ARE IN MILLIMETERS. TOLERANCES ARE: CUT LENGTHS ±3MM STRIP LENGTHS ±.5 | | TITLE: Harness, CB Plug to Switch, black and white w/ ferrite, Syn1

DRAWING NUMBER: 100022 | SIZE: A4
RoHS COMPLIANT | REV: IR

DO NOT SCALE DRAWING | SHEET:1 OF 1
