SynDaverCO/syndaver-axi/Electrical/Cable_drawings/Control_box/[100075] Harness, CB Erase Switch, Syn1.pdf

ITEM | QTY | UNIT | SUPPLIER | SUPPLIER P/N
A | 1 PCE | | digikey | 22552101

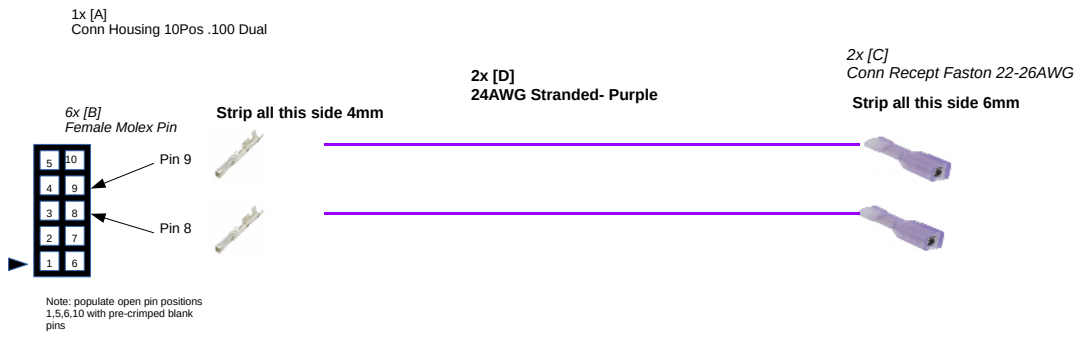
[picture p75: page 1]
24AWG Stranded- Purple; Strip all this side 6mm Strip all this side 4mm; Pin 8; Pin 9

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

B | 6 PCE | | TTI | 16-02-0086
C | 2 PCE | | TTI | 7-520365-2
D | 400 MM | | ALLCABLE HU1569247VT

Conn Housing 10Pos .100 Dual

Conn Recept Faston 22-26AWG

Female Molex Pin

Note: populate open pin positions
1,5,6,10 with pre-crimped blank
pins

DRAWN BY: West | DATE: 01/17/2020 | 3121 N Garfield Ave Loveland, CO. 80538 Phone: 1-970-685-4501

CHECKED BY: CHECKED | DATE: XX/XX/XXXX
UNLESS OTHERWISE SPECIFIED DIMENSIONS ARE IN MILLIMETERS. TOLERANCES ARE: CUT LENGTHS ±3MM STRIP LENGTHS ±.5 | | TITLE: Harness, CB Erase Switch, Syn1

DRAWING NUMBER: 100075 | SIZE: A4
RoHS COMPLIANT | REV: IR

DO NOT SCALE DRAWING | SHEET: 1 OF 1
