SynDaverCO/syndaver-axi/Electrical/Cable_drawings/Control_box/[100494] Harness, CB YZ, Syn 1.pdf

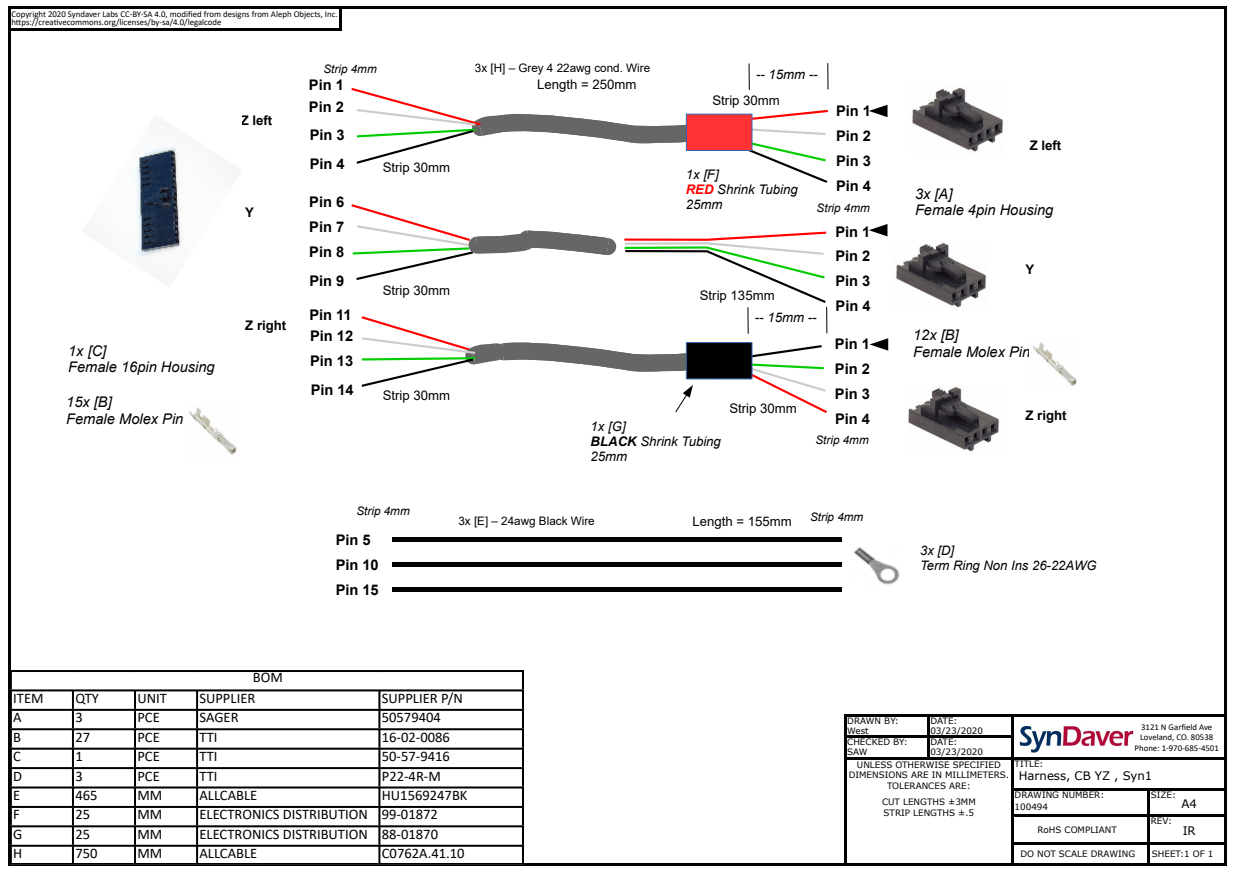
[picture p76: page 1]
SHEET:1 OF 1; DRAWING NUMBER:; SIZE:; Pin 1; Length = 250mm; Pin 2; Pin 3; Pin 4; Pin 6; Strip 4mm; Female 4pin Housing; Pin 7; Pin 8; Pin 9; Pin 11 Pin 12; Pin 13; Pin 14; 1x [C] Female 16pin Housing; Strip 30mm; Strip 135mm; Z left; Z right; 1x [F] RED Shrink Tubing 25mm; 1x [G] BLACK Shrink Tubing 25mm; 3x [E] – 24awg Black Wire; Length = 155mm; Pin 5; Pin 10; Pin 15; ALLCABLE; BOM

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

3x [H] – Grey 4 22awg cond. Wire

Female Molex Pin

Term Ring Non Ins 26-22AWG

ITEM | QTY | UNIT | SUPPLIER | SUPPLIER P/N
A | 3 | PCE | SAGER | 50579404
B | 27 | PCE | TTI | 16-02-0086
C | 1 | PCE | TTI | 50-57-9416
D | 3 | PCE | TTI | P22-4R-M

DRAWN BY: West | DATE: 03/23/2020 | 3121 N Garfield Ave Loveland, CO. 80538 Phone: 1-970-685-4501

CHECKED BY: SAW | DATE: 03/23/2020
UNLESS OTHERWISE SPECIFIED DIMENSIONS ARE IN MILLIMETERS. TOLERANCES ARE: CUT LENGTHS ±3MM STRIP LENGTHS ±.5 | | TITLE: Harness, CB YZ , Syn1

F | 25 | MM | ELECTRONICS DISTRIBUTION | 99-01872
G | 25 | MM | ELECTRONICS DISTRIBUTION | 88-01870

RoHS COMPLIANT | REV: IR

DO NOT SCALE DRAWING
